ScottYates/VoiceLabels/case/stl/11a_front_panel_main.stl

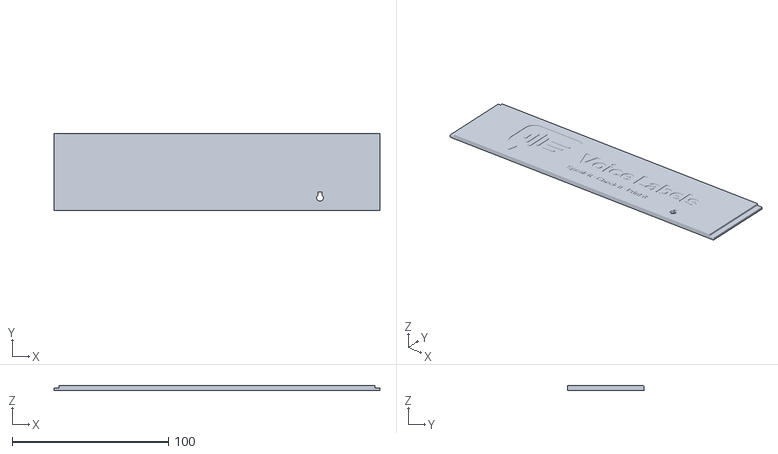
[picture p23: CAD file, 2026-11-02]
case/stl/11a_front_panel_main.stl
208.9 x 49.1 x 3.00
