ScottYates/VoiceLabels/case/stl/4_base.stl

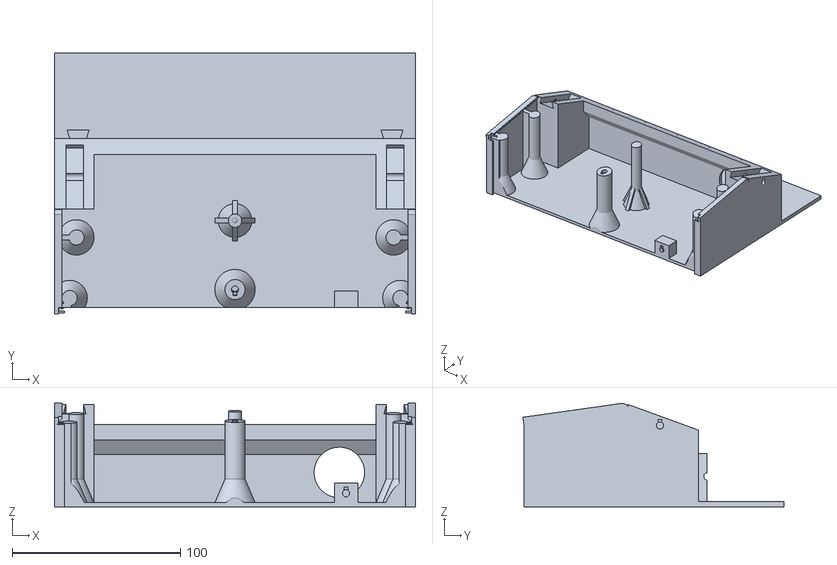
[picture p24: CAD file, 2026-11-02]
case/stl/4_base.stl
214.5 x 155.2 x 61.5
