ScottYates/VoiceLabels/logo3d/stl/logo_plaque.stl

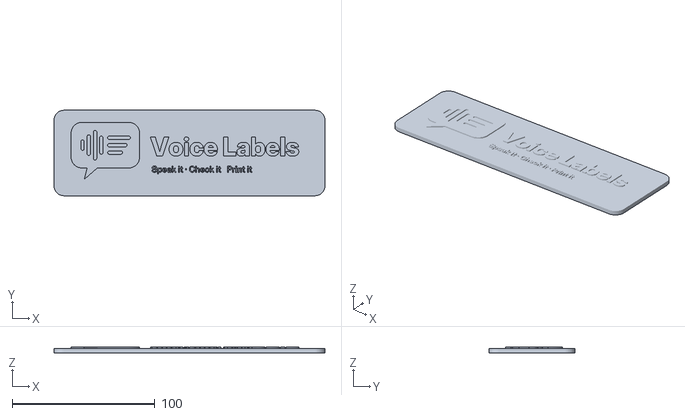
[picture p25: CAD file, 2026-10-25]
logo3d/stl/logo_plaque.stl
190.0 x 60.0 x 4.00
