ScottYates/VoiceLabels/logo3d/stl/logo_3_white.stl

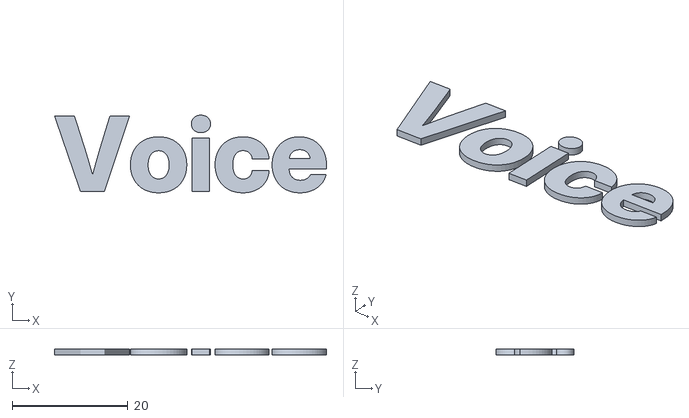
[picture p26: CAD file, 2026-10-25]
logo3d/stl/logo_3_white.stl
47.0 x 13.4 x 1.00
