ScottYates/VoiceLabels/case/stl/6_power_pod.stl

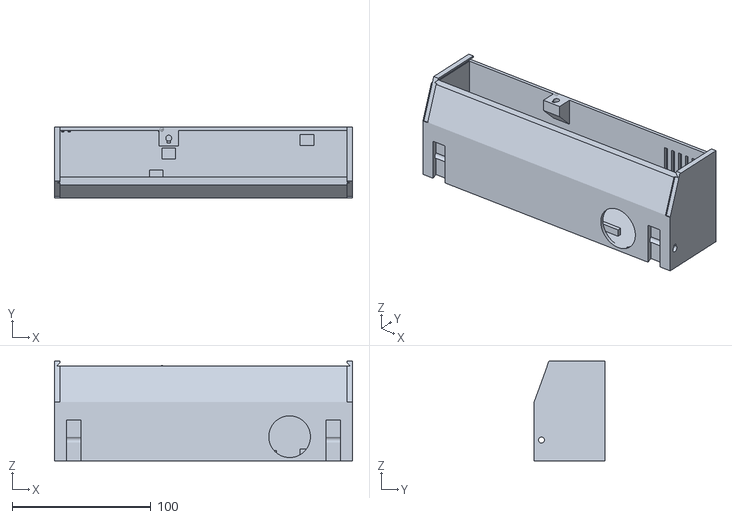
[picture p27: CAD file, 2026-11-02]
case/stl/6_power_pod.stl
214.5 x 50.8 x 71.8
