ScottYates/VoiceLabels/logo3d/stl/logo_4_gray.stl

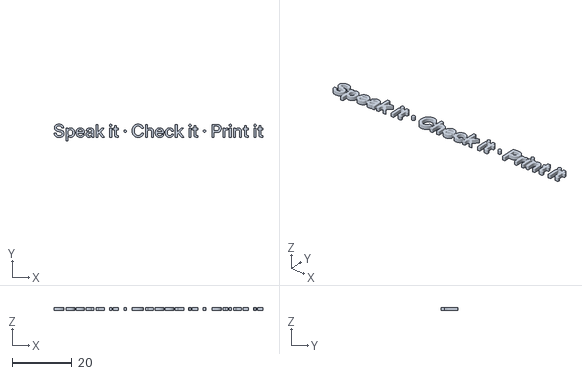
[picture p28: CAD file, 2026-10-25]
logo3d/stl/logo_4_gray.stl
70.0 x 5.66 x 1.00
