ScottYates/VoiceLabels/case/stl/1_housing.stl

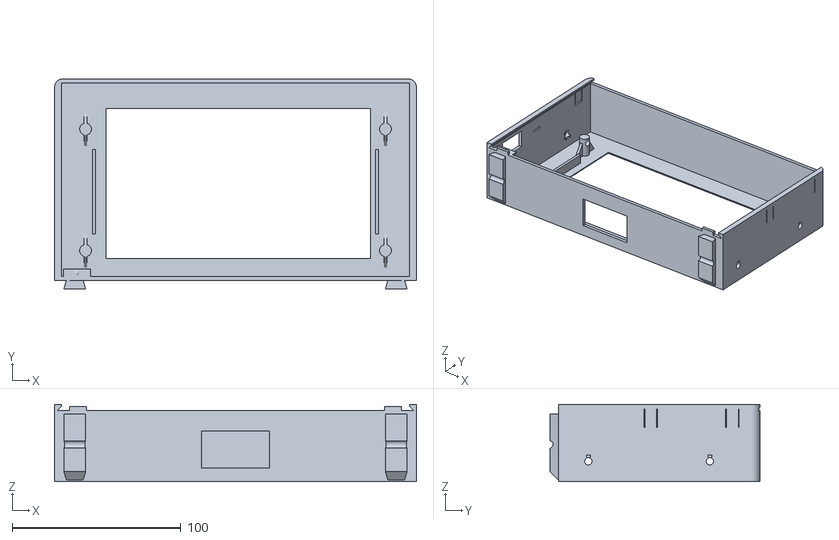
[picture p29: CAD file, 2026-11-02]
case/stl/1_housing.stl
214.5 x 124.6 x 45.7
