ScottYates/VoiceLabels/logo3d/stl/logo_1_base_dark.stl

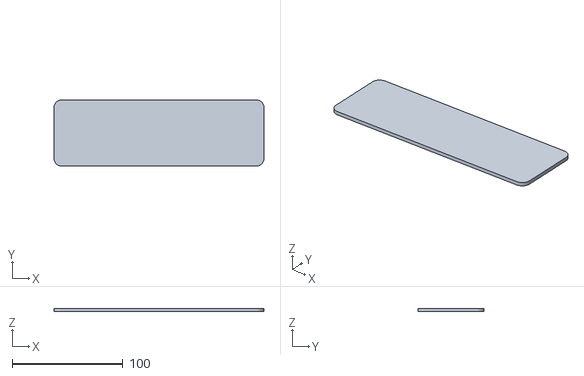
[picture p30: CAD file, 2026-10-25]
logo3d/stl/logo_1_base_dark.stl
190.0 x 60.0 x 3.00
