ScottYates/VoiceLabels/case/stl/9_socket_keeper.stl

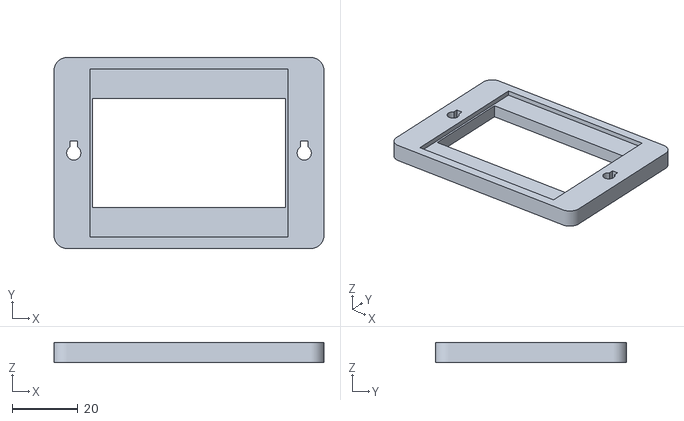
[picture p31: CAD file, 2026-11-02]
case/stl/9_socket_keeper.stl
82.0 x 58.0 x 6.20
