ScottYates/VoiceLabels/logo3d/stl/logo_2_yellow.stl

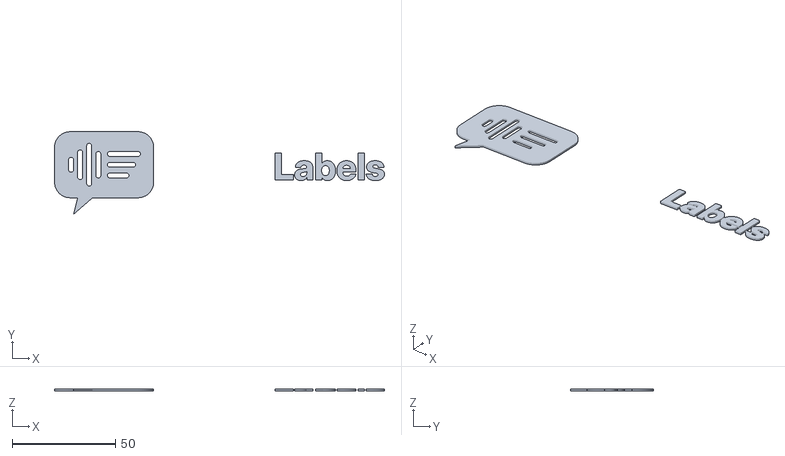
[picture p32: CAD file, 2026-10-25]
logo3d/stl/logo_2_yellow.stl
159.6 x 40.0 x 1.00
