ScottYates/VoiceLabels/case/stl/12_panel_pin_x3.stl

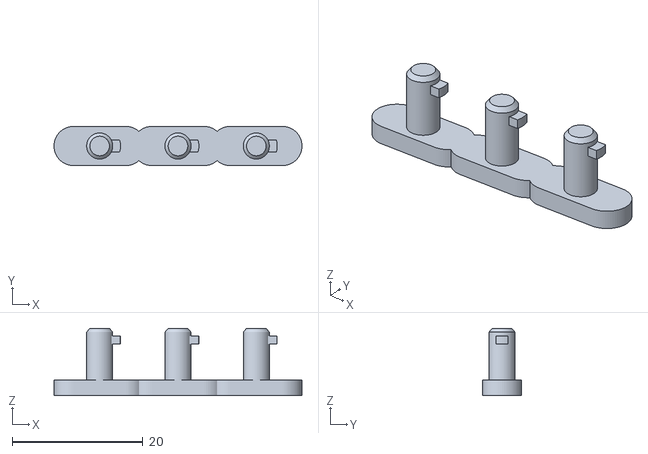
[picture p33: CAD file, 2026-11-02]
case/stl/12_panel_pin_x3.stl
38.0 x 6.00 x 10.3
