ScottYates/VoiceLabels/case/stl/11_front_panel.stl

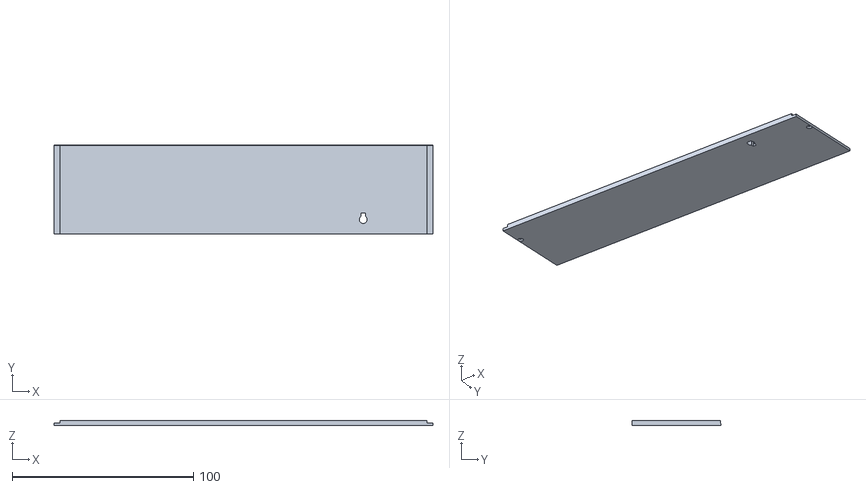
[picture p34: CAD file, 2026-11-02]
case/stl/11_front_panel.stl
208.9 x 49.1 x 3.00
