ScottYates/VoiceLabels/case/stl/5_deck.stl

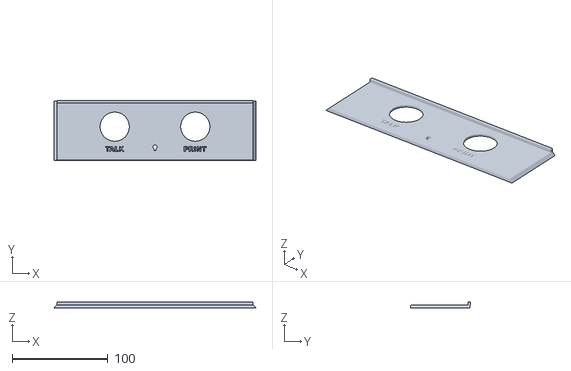
[picture p35: CAD file, 2026-11-02]
case/stl/5_deck.stl
210.7 x 62.7 x 6.00
