ScottYates/VoiceLabels/case/stl/7_pod_lid.stl

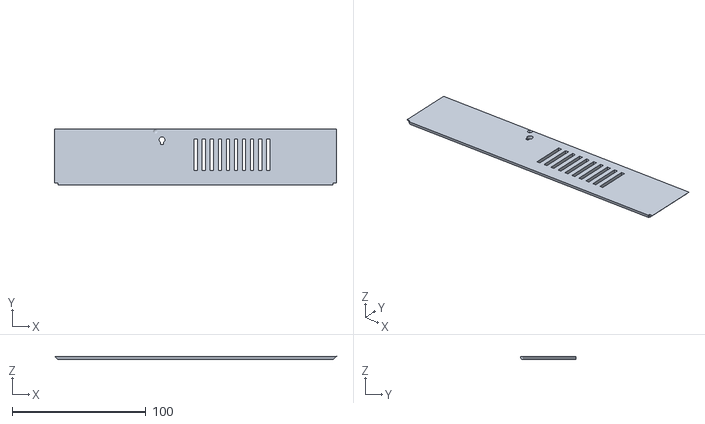
[picture p36: CAD file, 2026-11-02]
case/stl/7_pod_lid.stl
210.7 x 41.5 x 2.40
