ScottYates/VoiceLabels/case/stl/11c_front_logo_voice.stl

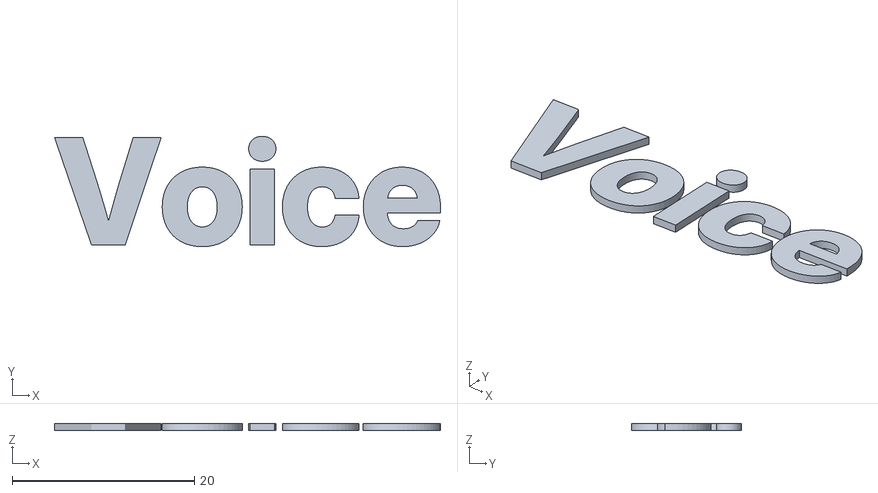
[picture p37: CAD file, 2026-10-29]
case/stl/11c_front_logo_voice.stl
42.3 x 12.1 x 0.8
