ScottYates/VoiceLabels/case/stl/11d_front_logo_tagline.stl

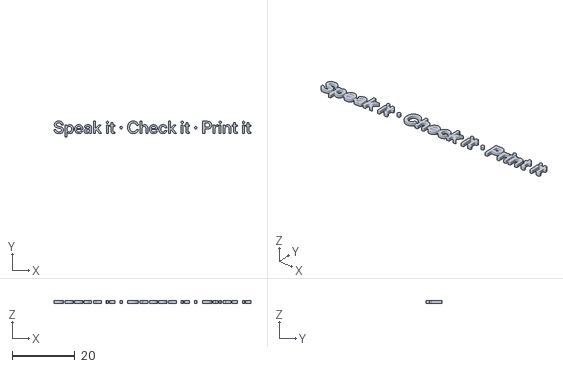
[picture p38: CAD file, 2026-10-29]
case/stl/11d_front_logo_tagline.stl
63.0 x 5.09 x 0.8
