ScottYates/VoiceLabels/case/stl/11b_front_logo_yellow.stl

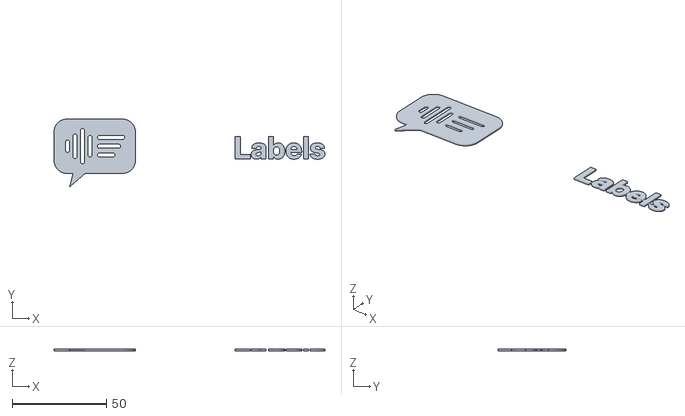
[picture p39: CAD file, 2026-10-29]
case/stl/11b_front_logo_yellow.stl
143.7 x 36.0 x 0.8
