ScottYates/VoiceLabels/case/stl/2_back_plate.stl

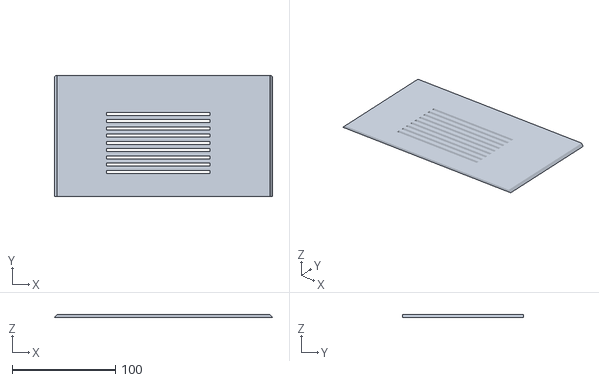
[picture p40: CAD file, 2026-10-23]
case/stl/2_back_plate.stl
210.7 x 117.3 x 2.50
