ScottYates/VoiceLabels/case/stl/10_socket_pin_x2.stl

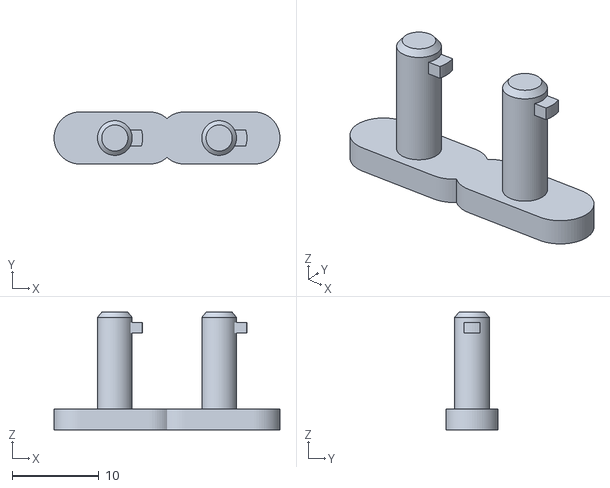
[picture p41: CAD file, 2026-10-23]
case/stl/10_socket_pin_x2.stl
26.0 x 6.00 x 13.5
