ScottYates/VoiceLabels/case/stl/3_screen_pin_x4.stl

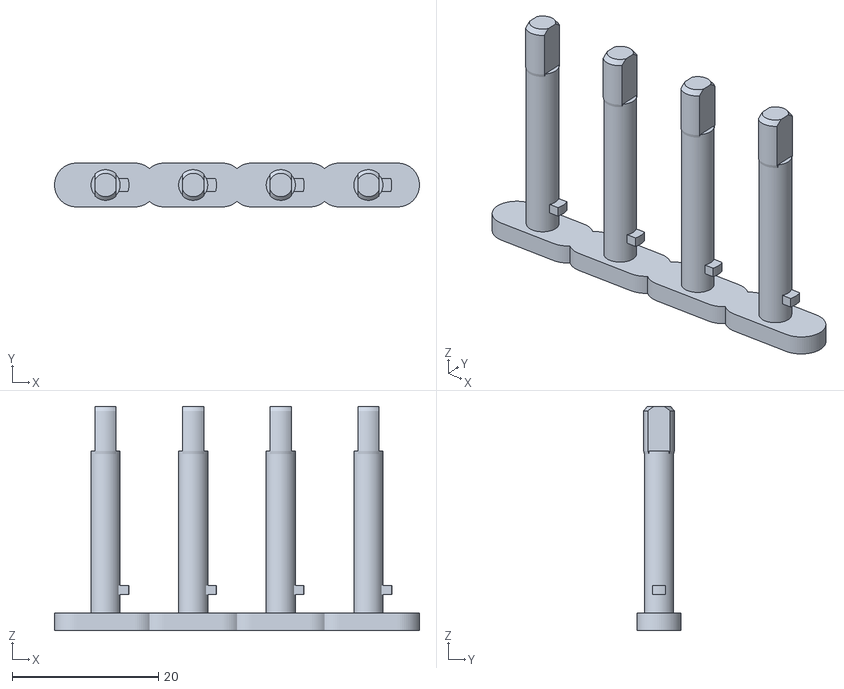
[picture p42: CAD file, 2026-10-23]
case/stl/3_screen_pin_x4.stl
50.0 x 6.00 x 30.7
