ScottYates/VoiceLabels/case/stl/8_lock_pin_x4.stl

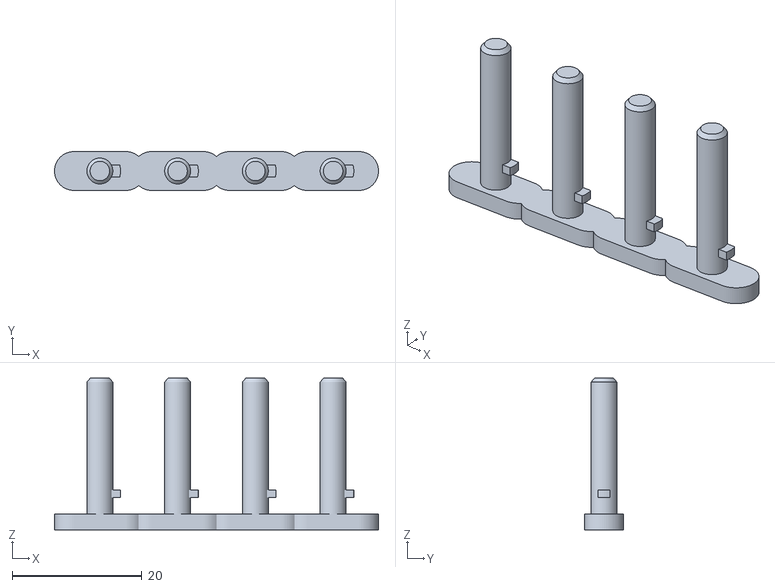
[picture p43: CAD file, 2026-10-23]
case/stl/8_lock_pin_x4.stl
50.0 x 6.00 x 23.4
