ScottYates/VoiceLabels/case/case.py

"""Voice label printer case: parametric model built with manifold3d.

Run:  python3 case.py      -> writes STL files and preview PNGs in ./out

Parts (each exported in its print orientation, no supports needed):
  1. housing      screen housing, printed face-down (best finish on the bezel)
  2. back_plate   flat back of the housing, with vents
  3. screen_pin x4  push-in pins that hold the screen board in the housing
  4. base         console with the button deck in front and the housing seat
  5. deck         flat button plate with TALK / PRINT labels
  6. power_pod    closed box behind the base for the USB power brick, with a
                  switched, fused IEC power socket in its back wall
  7. pod_lid      sliding lid for the power pod
 11. front_panel  the base's front wall: slides up from underneath once the deck is in;
                  the logo is inlaid flush in its front face (11a-11d: the same
                  panel split by colour for a multi-colour printer)
  8. lock_pin x4  quarter-turn pins that lock the housing and pod to the base
  9. socket_keeper  frame that clamps the power socket's front plate to the pod
 10. socket_pin x2  quarter-turn pins that hold the keeper on
 12. panel_pin x3   quarter-turn pins that lock the pod lid, the deck and the front panel in place

How the big parts join (no screws carry them):
  housing -> base   two dovetail rails under the housing slide down its seat
                    into dovetail slots in the base. The deck's back edge
                    then stops the housing sliding back out.
  power pod -> base two vertical dovetail rails on the back of the base; the
                    pod drops onto them and rests on the floor tongue. With
                    the housing on, its lean over the pod stops it lifting.

Coordinates for the housing ("print" frame): X across, Y up the face,
Z depth (0 = front face on the bed). Viewed from the FRONT, user-right = -X.
World frame for the assembly: X user-right, Y toward the back, Z up.
"""
import math
from pathlib import Path

import numpy as np
from manifold3d import CrossSection, FillRule, Manifold, OpType

# ------------------------------------------------------------------ settings
SEG = 64                       # circle smoothness
WALL = 2.4                     # side wall thickness
FRONT = 2.0                    # bezel (front plate) thickness
CLR = 0.4                      # clearance around the screen board

# Hosyond 7" DSI (from the maker's drawing)
PCB_W, PCB_H = 164.9, 102.0    # board / backlight outline
LENS_W, LENS_H = 164.28, 99.17 # glass; top edge flush with the board top
VA_L, VA_R = 3.2, 6.5          # visible area inset from glass edges, front view
VA_T, VA_B = 3.7, 8.5
STACK = 8.25                   # glass front to back of the board
WINDOW_MARGIN = 1.0            # window larger than the visible area by this
WINDOW_CHAMFER = 1.5

SIDE_GAP = 22.0                # room beside the board for USB plugs
TOP_GAP = 12.0                 # room above the board for the power cable to bend
INNER_DEPTH = 40.0             # front plate to back plate (Pi + plugs)
BACK_T = 2.5                   # back plate thickness
CORNER_R = 5.0

# Mic: it plugs straight into one of the Pi's USB ports through an opening in
# the side wall. The Pi's ports face the user's right, near the bottom of the
# case (the GPIO header is at the bottom). The opening lines up with the
# outer port of the stack nearest the GPIO header.
MIC_SIDE = "right"                # side the Pi's USB ports face, seen from the front
PI_STANDOFF = 8.0                 # gap between the screen board and the Pi board
PI_TOP_EDGE = 31.69               # Pi board top edge, mm below the screen board top
MIC_PORT_FROM_GPIO = 9.0          # USB stack centre, mm in from the Pi's GPIO edge
MIC_PORT_ABOVE_PI = 12.8          # outer port centre above the Pi board's top face
MIC_PLUG_W, MIC_PLUG_T = 19.0, 10.0   # mic plug body: width (up-down) x thickness
MIC_HOLE_CLR = 3.0                # extra room around the plug body

# Base and deck
RECLINE = 20.0                 # screen tilt back from vertical, degrees
DECK_ANGLE = 8.0               # button deck rises toward the screen
DECK_LEN = 62.0                # deck depth (horizontal)
DECK_T = 3.0                   # deck thickness (snap-in buttons like ~3 mm)
FRONT_H = 49.0                 # height of the deck underside at the front edge
REAR_SLOPE = 50.0              # rear wall angle from horizontal (>45 = no supports)
BUTTON_HOLE = 30.4             # 30 mm arcade buttons (print-tested holes run small)
BUTTON_PANEL_T = 2.0           # deck thinned to this around each button, for snap-in clips
BUTTON_RECESS_D = 38.0         # diameter of the thinned area (underside)
BUTTON_SPACING = 84.0
BASE_WALL = 2.4
# Front panel: the base's front wall is a separate panel that slides up into
# place from underneath once the deck (with the buttons hanging under it) is in.
# Its side edges are rebated and run in slots in two posts inside the front
# corners; a lip of each post covers the rebate, so the front stays flush.
FP_T = 3.0                     # panel thickness
FP_LIP = 1.2                   # post lip in front of the panel's rebated edge
FP_TONGUE = 3.5                # how far each edge runs into its post
FP_POST = 7.5                  # post width, from the side wall inwards
FP_CLR = 0.25                  # play in the slots
FP_DETENT_Z = 14.0             # click bump height (from the floor)
BUTTON_BODY_D, BUTTON_BODY_L = 31.0, 34.0   # arcade button body under the deck (stand-in for checks)

# Sliding panels (back plate, pod lid, deck): each panel's two long edges are
# bevelled at 45 degrees and slide under matching lips along the top of the
# side walls, like a pencil-box lid. A stop ends the travel and a small bump
# clicks into a dimple under the panel to hold it there. No screws.
SLIDE_NECK = 1.6               # rail width where it sits on the wall
SLIDE_LIP = 1.2                # lip thickness above the panel
SLIDE_CLR = 0.3                # play on each side
DETENT_R, DETENT_H = 1.4, 0.45 # click bump (the dimple is a little bigger)

# Dovetails. A rail is NECK wide where it meets its part and TIP wide at its
# end, HEIGHT tall; slots are DOVE_CLR bigger all round. Raise DOVE_CLR if
# your printer's joints come out too tight, lower it if they rattle.
DOVE_NECK, DOVE_TIP, DOVE_H = 10.0, 13.0, 5.0
DOVE_CLR = 0.25
HOUSING_RAIL_X = None          # set below: rail centres across the housing
HOUSING_RAIL_Z = (1.0, 40.0)   # rail start (at its root) / end along the housing depth
SEAT_RIB_W = 21.0              # solid rib inside each side wall carrying a slot
DECK_LIP_H = 3.0               # lip on the deck's back edge, in front of the bezel
DECK_LIP_D = 2.5
DECK_LIP_REACH = 0.4           # the lip reaches this far past the deck's back end, up to the bezel

# Lock pins: short printed pegs pushed in through the outside walls. Each one
# crosses a dovetail through a groove in the rail, so the part can't slide.
# They lock with a quarter turn, like a camera-lens bayonet: a lug on the shaft
# passes a slot in the wall, then turns behind it, riding up a small ramp on
# the wall's inside face (which pulls the head tight) and dropping into a
# notch at 90 degrees. A raised stop past the notch stops it turning too far.
PIN_D = 4.0                    # pin shaft
PIN_HOLE_D = 4.3               # holes the shaft passes through
PIN_LEN = 21.0                 # shaft length under the head
PIN_HEAD_L, PIN_HEAD_W, PIN_HEAD_T = 14.0, 6.0, 2.4   # wing head you turn with your fingers
PIN_WALL = 2.4                 # the walls the pins lock behind (all 2.4 mm)
LUG_R, LUG_W, LUG_T = 3.2, 1.8, 1.2   # lug: reach from the axis, width, thickness
LUG_GAP = 0.15                 # lug face to the wall's inside face, before the ramp
RAMP_H, NOTCH_H, STOP_H = 0.4, 0.15, 1.2   # ramp top, notch floor, stop: height off the wall
KEYWAY_W, KEYWAY_R = 2.3, 3.6  # slot in the wall the lug passes through
POCKET_R, POCKET_L = 3.8, 2.2  # room behind the wall for the lug to turn
PIN_HOUSING_S = 22.0           # housing pins: distance along the seat from the bezel
PIN_POD_Z = 18.0               # pod pins: height (world Z)

# Cable hole between the power pod and the space under the buttons.
PASS_HOLE_D = 30.0             # ~1.2 inch: tops out below where the pod's front starts to slope
PASS_HOLE_X = 62.0             # centre, world X (user-right is +)

# Derived housing sizes
INNER_W = PCB_W + 2 * CLR + 2 * SIDE_GAP
INNER_H = PCB_H + 2 * CLR + TOP_GAP
W = INNER_W + 2 * WALL
H = INNER_H + 2 * WALL
DEPTH = FRONT + INNER_DEPTH            # shell depth (without back plate)
PCB_X0 = -PCB_W / 2                    # board edges (print X)
PCB_Y0 = WALL + CLR                    # board bottom edge (print Y)
PCB_BACK_Z = FRONT + STACK             # back face of the board
RIB = 8.0                              # corner rib size
RIB_X = INNER_W / 2 - RIB / 2          # rib centres
CLAMP_X = PCB_W / 2 + CLR + 6.0       # posts beside the board that guide the screen pins
CLAMP_YS = [PCB_Y0 + 15.0, PCB_Y0 + 87.0]
SCREEN_PIN_OVER = 3.5                  # how far each screen pin reaches over the board's back
# The part of each screen pin over the board is a cam: round (CAM_D) with two
# flats. It slides in with a flat towards the board (CAM_FLAT from the axis,
# clear of it), and the quarter turn that locks the pin brings the round side
# down onto the board, pressing it CAM_SQUEEZE into the bezel.
CAM_D = 4.2                            # still passes the 4.3 mm hole
CAM_FLAT = 1.45                        # axis to each flat
CAM_SQUEEZE = 0.35                     # how far the round side reaches past the board's back
HOUSING_RAIL_X = W / 2 - 12.0

# ------------------------------------------------------------------ helpers
def box(x0, x1, y0, y1, z0, z1):
    return Manifold.cube([x1 - x0, y1 - y0, z1 - z0]).translate([x0, y0, z0])

def cyl(r, h, x=0, y=0, z=0):
    return Manifold.cylinder(h, r, circular_segments=SEG).translate([x, y, z])

def housing_outline():
    """The housing's outline (print X across, Y up from its bottom edge):
    rounded top corners, square bottom corners where it sits in the base."""
    return (rrect(W, H, CORNER_R).translate([0, H / 2])
            + CrossSection.square([W, H / 2]).translate([-W / 2, 0]))


def rrect(w, h, r):
    """Rounded rectangle centred at the origin (X width, Y height)."""
    core = CrossSection.square([w - 2 * r, h - 2 * r], center=True)
    return core.offset(r, join_type=__import__("manifold3d").JoinType.Round, circular_segments=SEG)

def union(parts):
    return Manifold.batch_boolean(parts, OpType.Add)


def _ccw(pts):
    area = sum(a[0] * b[1] - b[0] * a[1] for a, b in zip(pts, pts[1:] + pts[:1]))
    return pts if area > 0 else pts[::-1]


def _along_y(cs, y0, y1):
    """Extrude a CrossSection drawn in (x, z) along +Y from y0 to y1."""
    return cs.extrude(y1 - y0).rotate([90, 0, 0]).translate([0, y1, 0])


def slide_rails(t, y0, y1, z0=0.0):
    """Two rails along the side edges (x = +-W/2) of a panel t thick lying on
    the plane z = z0, running from y0 to y1. Each rail's inside face is a 45-degree
    undercut that the panel's bevelled edge slides under."""
    rails = []
    for sx in (-1, 1):
        x0, xn = W / 2, W / 2 - SLIDE_NECK
        pts = [(x0, 0), (xn, 0), (xn - t, t), (xn - t, t + SLIDE_LIP), (x0, t + SLIDE_LIP)]
        pts = _ccw([(sx * x, z) for x, z in pts])
        rails.append(_along_y(CrossSection([pts]), y0, y1))
    return union(rails).translate([0, 0, z0])


def slide_panel(t, y0, y1):
    """A panel t thick (bottom at z = 0) whose long edges are bevelled to slide
    under slide_rails, running from y0 to y1."""
    xb = W / 2 - SLIDE_NECK - SLIDE_CLR
    pts = _ccw([(-xb, 0), (xb, 0), (xb - t, t), (-(xb - t), t)])
    return _along_y(CrossSection([pts]), y0, y1)


def detent_bump(x, y, z):
    """Small dome on a surface at height z (the click bump)."""
    return Manifold.cylinder(DETENT_H, DETENT_R, 0.35, SEG).translate([x, y, z - 0.01])


def detent_dimple(x, y):
    """Matching dimple in a panel's underside (panel bottom at z = 0)."""
    return Manifold.cylinder(DETENT_H + 0.25, DETENT_R + 0.3, 0.6, SEG).translate([x, y, -0.01])

def dove_section(clr=0.0, extra=0.0):
    """Dovetail cross-section (u across, v out from the part), narrow at v=0.
    clr grows it for the slot; extra lengthens it back into the part."""
    n, t, h = DOVE_NECK / 2 + clr, DOVE_TIP / 2 + clr, DOVE_H + clr
    slope = (t - n) / h
    return CrossSection([[(-n + slope * extra, -extra), (n - slope * extra, -extra),
                          (t, h), (-t, h)]])

def text_cross_section(s, size):
    """Text outline as a CrossSection, centred, using DejaVu Sans Bold."""
    from matplotlib.font_manager import FontProperties
    from matplotlib.textpath import TextPath
    tp = TextPath((0, 0), s, size=size, prop=FontProperties(family="DejaVu Sans", weight="bold"))
    polys = [p for p in tp.to_polygons() if len(p) >= 3]
    cs = CrossSection(polys, FillRule.EvenOdd)
    (x0, y0), (x1, y1) = cs.bounds()[:2], cs.bounds()[2:]
    return cs.translate([-(x0 + x1) / 2, -(y0 + y1) / 2])

# ------------------------------------------------------------------ housing
def mic_port_yz():
    """Height (print Y) and depth (print Z) of the mic's USB port centre."""
    pi_top = PCB_Y0 + PCB_H - PI_TOP_EDGE        # Pi board edge toward the case top
    pi_gpio_edge = pi_top - 56.0                  # GPIO edge, toward the case bottom
    y = pi_gpio_edge + MIC_PORT_FROM_GPIO
    z = PCB_BACK_Z + PI_STANDOFF + 1.6 + MIC_PORT_ABOVE_PI
    return y, z


def housing():
    outer = housing_outline().extrude(DEPTH)
    inner = box(-INNER_W / 2, INNER_W / 2, WALL, WALL + INNER_H, FRONT, DEPTH + 1)
    shell = outer - inner

    # Window over the visible area. Front view right = -X, so swap L/R.
    lens_x0, lens_x1 = -LENS_W / 2, LENS_W / 2
    lens_y1 = PCB_Y0 + PCB_H
    lens_y0 = lens_y1 - LENS_H
    va_x0, va_x1 = lens_x0 + VA_R, lens_x1 - VA_L     # print X (mirrored)
    va_y0, va_y1 = lens_y0 + VA_B, lens_y1 - VA_T
    m, c = WINDOW_MARGIN, WINDOW_CHAMFER
    win = box(va_x0 - m, va_x1 + m, va_y0 - m, va_y1 + m, -1, FRONT + 1)
    bevel = Manifold.batch_hull([
        box(va_x0 - m - c, va_x1 + m + c, va_y0 - m - c, va_y1 + m + c, -1, 0),
        box(va_x0 - m, va_x1 + m, va_y0 - m, va_y1 + m, c, c + 0.01),
    ])
    shell = shell - win - bevel

    # Side rails that locate the board left/right.
    rails = []
    for sx in (-1, 1):
        x_in = sx * (PCB_W / 2 + CLR)
        rails.append(box(min(x_in, x_in + sx * 2), max(x_in, x_in + sx * 2),
                         PCB_Y0 + 25, PCB_Y0 + 75, FRONT, FRONT + STACK - 1.5))
    # Back plate: slide rails along the side walls' back rims (trimmed to the
    # rounded outline), stop blocks at the bottom corners, and a small pad inside
    # the bottom wall carrying the click bump.
    ribs = []
    outline = housing_outline().extrude(20).translate([0, 0, DEPTH - 1])
    ribs.append(slide_rails(BACK_T, 0, H, DEPTH) ^ outline)
    for sx in (-1, 1):
        ribs.append(box(sx * (W / 2 - 14) - 5, sx * (W / 2 - 14) + 5, 0, BACK_STOP_Y,
                        DEPTH - 0.01, DEPTH + BACK_T) ^ outline)
    ribs.append(_pad_yz(BACK_DETENT_X))
    ribs.append(detent_bump(BACK_DETENT_X, BACK_DETENT_Y, DEPTH))
    # Posts beside the board that carry the screen pins.
    post_top = screen_pin_z() + PIN_D / 2 + 2.0
    bosses = [cyl(3.5, post_top - FRONT, sx * CLAMP_X, y, FRONT) for sx in (-1, 1) for y in CLAMP_YS]
    # ... each braced by two triangular ribs along Y (clear of the board and the pin's path)
    for sx in (-1, 1):
        for y in CLAMP_YS:
            for sy in (-1, 1):
                tri = [(y + sy * 3.0, FRONT - 0.01), (y + sy * 10.0, FRONT - 0.01), (y + sy * 3.0, post_top - 3.0)]
                bosses.append(x_extrude(tri if sy > 0 else tri[::-1], sx * CLAMP_X - 1.0, sx * CLAMP_X + 1.0))

    # Dovetail rails under the bottom wall, running front to back. In the print
    # frame they hang off the Y=0 face and run along Z (straight up on the bed).
    # Their front ends are cut at 45 degrees (starting at z0 where they meet the
    # wall) so they build up from the bed without supports.
    z0, z1 = HOUSING_RAIL_Z
    end_cut = (box(-200, 200, -100, 100, -200, 0).rotate([-45, 0, 0]).translate([0, 0, z0]))
    for sx in (-1, 1):
        rail = (dove_section(extra=0.5).extrude(z1)              # u -> X, v -> -Y
                .mirror([0, 1, 0]).translate([sx * HOUSING_RAIL_X, 0, 0]))
        # groove across the tip for the lock pin (pin axis at the slot bottom)
        groove = cyl(PIN_HOLE_D / 2, W + 4, 0, 0, 0).rotate([0, 90, 0]).translate(
            [-W / 2 - 2, -(DOVE_H + DOVE_CLR), PIN_HOUSING_S])
        rails.append(rail - end_cut - groove)
    shell = union([shell] + rails + ribs + bosses)

    # Mic opening: a tall rectangle lined up with the Pi's USB port.
    my, mz = mic_port_yz()
    hy, hz = (MIC_PLUG_W + MIC_HOLE_CLR) / 2, (MIC_PLUG_T + MIC_HOLE_CLR) / 2
    mic_hole = box(W / 2 - WALL - 1, W / 2 + 1, my - hy, my + hy, mz - hz, mz + hz)
    if MIC_SIDE == "right":                     # user-right is print -X
        mic_hole = mic_hole.mirror([1, 0, 0])

    holes = [mic_hole]
    bores = []
    # Screen pins: in through the side wall, through the post,
    # reaching over the back of the board's edge.
    for sx in (-1, 1):
        for y in CLAMP_YS:
            bores.append(pin_bore(sx, y, screen_pin_z(), sx * (CLAMP_X - 4.5)))
    # Wire pass-through in the bottom wall (button wires to the GPIO header).
    holes.append(box(-20, 20, -1, WALL + 1, 8, 30))
    # Breakaway cable tabs: a notch at the back rim of each side wall, filled
    # by a tab held on by a thin web. Snap out the ones you need; the back
    # plate closes over the cable.
    for y in KNOCKOUT_YS:
        for sx in (-1, 1):
            x_out, x_in = sx * W / 2, sx * (W / 2 - WALL)
            xa, xb = min(x_out, x_in) - 0.01, max(x_out, x_in) + 0.01
            y0, y1 = y - KO_W / 2, y + KO_W / 2
            z0 = DEPTH - KO_DEPTH
            # slits down both long sides of the tab
            holes.append(box(xa - 1, xb + 1, y0 - KO_SLIT, y0, z0, DEPTH + 1))
            holes.append(box(xa - 1, xb + 1, y1, y1 + KO_SLIT, z0, DEPTH + 1))
            # thin the hinge line at the bottom of the tab from the inside
            hinge_in = (xa, xb - KO_WEB) if sx > 0 else (xa + KO_WEB, xb)
            holes.append(box(hinge_in[0], hinge_in[1], y0, y1, z0 - 0.01, z0 + 1.2))
    return add_pin_bores(shell - union(holes), bores)


KO_W = 7.0                      # breakaway tab width (cable up to ~6 mm)
KO_DEPTH = 10.0                 # how far the notch reaches in from the back rim
KO_SLIT = 0.5
KO_WEB = 0.8                    # thickness left at the hinge (2 perimeters)
KNOCKOUT_YS = [PCB_Y0 + 52.0,                         # low: printer cable
               WALL + INNER_H - RIB - 6.0]            # high: power cable

BACK_STOP_Y = 2.0               # back plate stops on blocks this tall at the bottom corners
BACK_DETENT_X = -94.0           # click bump: on a pad inside the bottom wall, beside the
                                # screen board (the board passes this rim on its way in)
BACK_PAD_W = 16.0
BACK_DETENT_Y = WALL + 2.2


def _pad_yz(x_center):
    """Wedge inside the housing's bottom wall at the back rim (45-degree underside)."""
    prof = [(WALL - 0.01, DEPTH - 5.0), (WALL + 4.6, DEPTH - 0.01), (WALL - 0.01, DEPTH - 0.01)]
    pts = prof
    area = sum(a[0] * b[1] - b[0] * a[1] for a, b in zip(pts, pts[1:] + pts[:1]))
    if area < 0:
        pts = pts[::-1]
    # profile is in (y, z); extrude across x
    return (CrossSection([pts]).extrude(BACK_PAD_W).rotate([90, 0, 90])
            .translate([x_center - BACK_PAD_W / 2, 0, 0]))


def back_plate():
    """Slides down from the top of the housing under the rails on the side
    walls, stops on two blocks at the bottom, and clicks onto a bump."""
    outline = housing_outline().extrude(BACK_T + 2).translate([0, 0, -1])
    plate = slide_panel(BACK_T, BACK_STOP_Y + SLIDE_CLR, H) ^ outline
    cut = [detent_dimple(BACK_DETENT_X, BACK_DETENT_Y)]
    # Vent slots over the Pi.
    for i in range(9):
        y = PCB_Y0 + 22 + i * 7
        cut.append(box(-55, 45, y, y + 3, -1, BACK_T + 1))
    return plate - union(cut)

def screen_pin_len():
    """From the outside of the side wall to SCREEN_PIN_OVER past the board edge."""
    return W / 2 - (PCB_W / 2 - SCREEN_PIN_OVER)


def screen_pin_z():
    """Screen pin axis depth: the cam's round side reaches CAM_SQUEEZE past the
    back of the board, so a locked pin presses the board into the bezel."""
    return PCB_BACK_Z + CAM_D / 2 - CAM_SQUEEZE


def screen_pin_cam_from():
    """Where the cam starts along a screen pin (local Z, head at 0): just past
    the inside face of the post, before the board's edge."""
    return PIN_HEAD_T + W / 2 - (CLAMP_X - 3.5 - 0.3)


# ------------------------------------------------------------------ base (world frame)
T = math.tan
DA, RA = math.radians(DECK_ANGLE), math.radians(RECLINE)
DECK_TOP_BACK = FRONT_H + DECK_LEN * T(DA) + DECK_T / math.cos(DA)
E = np.array([DECK_LEN, DECK_TOP_BACK])            # housing front-bottom edge (y, z)
HOUSING_DEPTH = DEPTH + BACK_T
DOWN_BACK = np.array([math.cos(RA), -math.sin(RA)])  # housing depth direction (y, z)
UP_FACE = np.array([math.sin(RA), math.cos(RA)])     # housing height direction (y, z)
B = E + HOUSING_DEPTH * DOWN_BACK                    # housing back-bottom edge
BASE_LEN = B[0] + B[1] / T(math.radians(REAR_SLOPE))   # without the power pod

# ------------------------------------------------------------------ power pod
# The USB power brick lives in a closed box behind the base, under the
# screen's lean. Mains comes in through a switched, fused IEC C14 socket
# (e.g. Amazon B0C2GHJGW2) in its back wall; inside, the cut-off socket end
# of a short 2-prong extension cord feeds the brick.
POWER_POD = True
PSU_L, PSU_H, PSU_T = 63.5, 63.5, 31.75   # brick: prong axis (X), height (Z), thickness (Y)
PSU_CLR = 0.8                      # room around the brick
POD_WALL = 2.4
TONGUE_T = 3.0                     # base floor extension the pod stands on
POD_RAIL_X = W / 2 - 14.0          # vertical dovetail rails on the base's back wall
POD_GAP_V = 0.0                    # pod front to the base's rear wall: touching (the dovetails locate it; it drops on vertically)
POD_GAP_S = 3.0                    # pod's sloped front to the screen's back plate (at the side rails)
POD_FACE_GAP = 0.0                 # ... where the face is built out to meet it: touching
POD_LID_GAP = 0.0                  # pod lid's front edge touches the housing's back (the housing is its stop)
INLET_CUT = (47.6, 27.8)           # IEC socket panel cutout (W x H)
INLET_SCREW_SPACING = 40.0         # its screw ears, above and below the cutout (unused: no screws)
# The socket's flat mounting plate (width, height from ear tip to ear tip,
# thickness) and the raised face on it (width, height) around the switch,
# fuse and plug. From a photo of the real part, scaled by the pin spacing:
# the plate just clears the two pin holes. Measure yours and adjust.
INLET_PLATE = (59.1, 50.0, 2.0)
INLET_FACE = (56.6, 31.0)      # 1/16" wider than the photo estimate, after a test fit
KEEPER_FACE = 4.5                  # keeper frame: thickness in front of the plate (6.2 mm in all, as the pins expect)
KEEPER_SQUEEZE = 0.3               # how much the keeper presses the plate into the wall
KEEPER_WINDOW_CLR = 1.0            # room around the socket's raised face in the keeper's window, each side
KEEPER_PIN_DX = 35.0               # keeper pins: this far either side of the socket centre (closed holes, solid all round)
INLET_DEPTH = 38.0                 # body + terminals behind the panel
INLET_X = -64.0                    # socket centre across the pod (world X, user-right +): keeps the outer keeper pin clear of the side wall
BRICK_X0 = -5.0                    # brick's prong end (world X); prongs face -X
LID_T = 2.4

def pod_geometry():
    z0 = TONGUE_T
    yf = B[0] + POD_GAP_V                                  # vertical part of the front
    c = POD_GAP_S / math.cos(RA)
    slant = lambda z: B[0] + c + (z - B[1]) * T(RA)       # front, parallel to the back plate
    z_v = B[1] + (yf - B[0] - c) / T(RA)                  # where the slant leaves the vertical
    front = lambda z: yf if z <= z_v else slant(z)        # outer front at height z
    brick_z1 = z0 + POD_WALL + PSU_H + PSU_CLR
    z_top = brick_z1 + 1.5                                 # top of the walls (lid sits on it)
    front_in_top = front(z_top) + POD_WALL / math.cos(RA)
    brick_y0 = front_in_top + PSU_CLR
    brick_y1 = brick_y0 + PSU_T
    yb = brick_y1 + PSU_CLR + POD_WALL                     # outer back
    return dict(z0=z0, yf=yf, z_v=z_v, front=front, z_top=z_top, yb=yb,
                brick=(BRICK_X0, BRICK_X0 + PSU_L, brick_y0, brick_y1,
                       z0 + POD_WALL, z0 + POD_WALL + PSU_H))

POD = pod_geometry()
TOTAL_LEN = POD["yb"] if POWER_POD else BASE_LEN

def profile_xs(points, width=None):
    """Extrude a (y, z) side profile across the base width (world X), centred."""
    width = W if width is None else width
    pts = list(points)
    area = sum(a[0] * b[1] - b[0] * a[1] for a, b in zip(pts, pts[1:] + pts[:1]))
    if area < 0:
        pts = pts[::-1]                                  # manifold wants CCW
    cs = CrossSection([pts])
    # CrossSection is in (u, v); extrude along +Z then rotate so u->Y, v->Z, Z->X.
    return cs.extrude(width).rotate([90, 0, 90]).translate([-width / 2, 0, 0])

def x_extrude(points, x0, x1):
    """Extrude a (y, z) side profile over world X from x0 to x1."""
    pts = list(points)
    area = sum(a[0] * b[1] - b[0] * a[1] for a, b in zip(pts, pts[1:] + pts[:1]))
    if area < 0:
        pts = pts[::-1]
    return CrossSection([pts]).extrude(x1 - x0).rotate([90, 0, 90]).translate([x0, 0, 0])


def housing_slots():
    """The dovetail slots the housing's rails slide into (world frame).
    Open at the front (deck end), closed at the back."""
    z0, z1 = HOUSING_RAIL_Z
    slots = []
    for sx in (-1, 1):
        slot = (dove_section(clr=DOVE_CLR, extra=1.0).extrude(z1 + 0.5 - (z0 - 20))
                .mirror([0, 1, 0]).translate([sx * HOUSING_RAIL_X, 0, z0 - 20]))
        slots.append(housing_world(slot))
    return union(slots)


def pod_rail_z():
    """Bottom and top of the base's vertical pod rails."""
    return TONGUE_T, POD["z_v"] - 5.0


def pass_hole(y0, y1):
    """The 1.5" cable hole, as a cylinder along Y between y0 and y1."""
    zc = TONGUE_T + POD_WALL + PASS_HOLE_D / 2          # bottom level with the pod floor
    return cyl(PASS_HOLE_D / 2, y1 - y0, 0, 0, 0).rotate([-90, 0, 0]).translate(
        [PASS_HOLE_X, y0, zc])


def pin_bore(sx, y, z, x_end):
    """Hole for a quarter-turn lock pin along X at (y, z), entering through the
    side wall at x = sx * W/2. Returns (cuts, adds): the hole, slot and turning
    pocket to remove, and the ramps, notches and stops on the wall's inside face
    to add back. The slot points up (+Z in the part's own frame, which is up on
    the print bed too); the pin locks a quarter turn either way."""
    xo, xi = sx * W / 2, sx * (W / 2 - PIN_WALL)
    def along(x0, x1, r):
        a, b = sorted((x0, x1))
        return cyl(r, b - a, 0, 0, 0).rotate([0, 90, 0]).translate([a, y, z])
    cuts = [along(xo + sx * 1, x_end, PIN_HOLE_D / 2)]
    a, b = sorted((xo + sx * 1, xi - sx * 0.01))
    cuts.append(box(a, b, y - KEYWAY_W / 2, y + KEYWAY_W / 2, z, z + KEYWAY_R))
    cuts.append(along(xi + sx * 0.01, xi - sx * POCKET_L, POCKET_R))
    # Ramp, notch and stop: thin sector slabs on the inside face, each side of the slot.
    def height(t):
        if 24 <= t < 66:
            return RAMP_H * (t - 24) / 42 + 0.02
        if 66 <= t < 112:
            return NOTCH_H
        if 112 <= t < 140:
            return STOP_H
        return 0.0
    r0, r1 = PIN_HOLE_D / 2 + 0.05, LUG_R + 0.35
    step = 3
    adds = []
    for side in (-1, 1):
        for t in range(24, 140, step):
            h = height(t + step / 2)
            a0_, a1_ = math.radians(t), math.radians(t + step + 0.5)
            quad = [(r0, a0_), (r1, a0_), (r1, a1_), (r0, a1_)]
            yz = [(y + r * math.sin(a) * side, z + r * math.cos(a)) for r, a in quad]
            x0, x1 = sorted((xi + sx * 0.01, xi - sx * h))
            adds.append(x_extrude(yz, x0, x1))
    return union(cuts), union(adds)


def pin_hole(sx, yz, rail_x, outer_wall=None):
    """Lock pin hole ending 2.5 mm past the far side of the rail's slot."""
    y, z = yz
    return pin_bore(sx, y, z, sx * (rail_x - DOVE_TIP / 2 - DOVE_CLR - 2.5))


def add_pin_bores(body, bores):
    """Cut the holes and pockets, then add the ramps back."""
    cuts = union([c for c, _ in bores])
    adds = union([a for _, a in bores])
    return (body - cuts) + adds


def pin_place(m, sx, y, z, locked=True):
    """Put a pin (modelled head-down along +Z, lug along +X) into its hole on
    side sx: head against the wall, lug sideways when locked, up when not."""
    lug = [0, 1, 0] if locked else [0, 0, 1]
    ax = [-sx, 0, 0]
    third = np.cross(ax, lug).tolist()
    # columns: images of local X (lug), local Y, local Z (axis)
    mat = [[lug[0], third[0], ax[0], sx * (W / 2 + PIN_HEAD_T)],
           [lug[1], third[1], ax[1], y],
           [lug[2], third[2], ax[2], z]]
    return m.transform(mat)


def housing_pin_yz():
    """Where the housing lock pins cross: at the bottom of the slot, so half the
    pin sits in a groove across the rail's tip."""
    p = E + PIN_HOUSING_S * DOWN_BACK - (DOVE_H + DOVE_CLR) * UP_FACE
    return float(p[0]), float(p[1])


def pod_pin_yz():
    """Pod lock pins cross at the tip face of the base's rails."""
    return B[0] + DOVE_H + DOVE_CLR, PIN_POD_Z


POST_FLARE = 6.0               # tall posts: extra radius at the floor, tapering out over POST_FLARE_H
POST_FLARE_H = 14.0
POST_GUSSET_H = 24.0           # free-standing posts: four ribs this tall, reaching POST_GUSSET_R from the axis
POST_GUSSET_R = 12.0
POST_RIB_T = 3.0               # ribs from posts to the walls, and gussets


def post_support(x, y, r, wall_x=None):
    """Bracing for a tall post standing on the base's floor: a flared foot and,
    beside a side wall, a full-height web to the wall (trimmed to the deck
    underside with everything else); otherwise four triangular gussets."""
    z0 = BASE_WALL - 0.01
    adds = [Manifold.cylinder(POST_FLARE_H, r + POST_FLARE, r, SEG).translate([x, y, z0])]
    if wall_x is not None:
        a, b = sorted((x, wall_x))
        adds.append(box(a, b, y - POST_RIB_T / 2, y + POST_RIB_T / 2, z0, 200))
    else:
        tri = [(0, 0), (POST_GUSSET_R, 0), (0, POST_GUSSET_H)]
        for ang in (0, 90, 180, 270):
            g = (x_extrude([(u, v) for u, v in tri], -POST_RIB_T / 2, POST_RIB_T / 2)   # (y, z) profile, thin in X
                 .rotate([0, 0, ang]).translate([x, y, z0]))
            adds.append(g)
    return union(adds)


def base():
    if POWER_POD:   # straight rear wall under the housing; the pod sits behind it
        prof = [(0, 0), (0, FRONT_H), (DECK_LEN, FRONT_H + DECK_LEN * T(DA)),
                (DECK_LEN, E[1]), (B[0], B[1]), (B[0], 0)]
    else:
        prof = [(0, 0), (0, FRONT_H), (DECK_LEN, FRONT_H + DECK_LEN * T(DA)),
                (DECK_LEN, E[1]), (B[0], B[1]), (BASE_LEN, 0)]
    solid = profile_xs(prof)
    # Inner cavity: open top, keeps floor, front wall and rear wall.
    rs = math.radians(90.0 if POWER_POD else REAR_SLOPE)
    rear_outer = B[0] if POWER_POD else BASE_LEN
    y_rear_inner = rear_outer - BASE_WALL / math.sin(rs)
    top = 400
    cav = [(BASE_WALL, BASE_WALL), (y_rear_inner - BASE_WALL / T(rs), BASE_WALL),
           (y_rear_inner - top / T(rs), top), (BASE_WALL, top)]
    cav_cs = CrossSection([cav])
    cavity = cav_cs.extrude(W - 2 * BASE_WALL).rotate([90, 0, 90]).translate(
        [-W / 2 + BASE_WALL, 0, 0])
    body = solid - cavity

    adds, cuts, late_adds = [], [], []
    # Seat ribs: solid from the floor up to the housing seat, inside each side
    # wall, each carrying one of the housing's dovetail slots.
    seat = [(E[0], 0), (E[0], E[1]), (B[0], B[1]), (B[0], 0)]
    xin = W / 2 - BASE_WALL + 0.01
    for sx in (-1, 1):
        x0, x1 = sorted((sx * xin, sx * (xin - SEAT_RIB_W)))
        adds.append(x_extrude(seat, x0, x1))
    # Rear wall thickened along its top (45-degree underside, no supports), so
    # the cable hole has a solid band above it and the housing a wider seat.
    if POWER_POD:
        yi = B[0] - BASE_WALL
        led = 7.0
        ledge = [(yi + 0.01, B[1] - led - 7.5), (yi - led, B[1] - 6),
                 (yi - led, B[1] + (B[0] - (yi - led)) * T(RA) - 0.01),
                 (yi + 0.01, B[1] + BASE_WALL * T(RA) - 0.01)]
        adds.append(x_extrude(ledge, -W / 2 + 1, W / 2 - 1))
    # Deck screw posts (vertical), top trimmed to the deck underside.
    deck_posts = [(sx * (W / 2 - 9), 9.0) for sx in (-1, 1)] + \
                 [(sx * (W / 2 - 13), DECK_LEN - 17.0) for sx in (-1, 1)]
    for x, y in deck_posts:                       # supports under the deck
        ztop = FRONT_H + y * T(DA)
        adds.append(cyl(4.5, ztop + 5, x, y, 0))
        adds.append(post_support(x, y, 4.5, wall_x=math.copysign(W / 2 - BASE_WALL + 0.01, x)))
    # A post near the back of the deck carries the deck's click bump.
    adds.append(cyl(4.0, FRONT_H + DECK_DETENT_Y * T(DA) + 5, DECK_DETENT_X, DECK_DETENT_Y, 0))
    # ... and a post at the front middle takes the deck's lock pin.
    adds.append(cyl(DECK_PIN_POST_R, FRONT_H + DECK_PIN_Y * T(DA) + 5, DECK_PIN_X, DECK_PIN_Y, 0))
    adds.append(post_support(DECK_DETENT_X, DECK_DETENT_Y, 4.0))
    adds.append(post_support(DECK_PIN_X, DECK_PIN_Y, DECK_PIN_POST_R))
    body = union([body] + adds)
    # Trim everything to the outside profile.
    body = body ^ solid
    # Deck: slide rails along the side walls' sloped tops (the deck slides in
    # from the front and stops against the seat ribs), and the click bump.
    L = DECK_LEN / math.cos(DA)
    body = body + deck_world(slide_rails(DECK_T, 0, L))
    body = body + deck_world(detent_bump(DECK_DETENT_X, DECK_DETENT_Y / math.cos(DA), 0))
    cuts.append(housing_slots())
    bores = [pin_hole(sx, housing_pin_yz(), HOUSING_RAIL_X) for sx in (-1, 1)]
    bores.append(deck_pin_bore())
    fp_block, fp_cut, fp_add = front_pin_bore()
    body = body + fp_block
    bores.append((fp_cut, fp_add))
    rear_feet_y = BASE_LEN - 22
    if POWER_POD:
        # Floor tongue the pod stands on, and the vertical dovetail rails on the
        # back wall that the pod drops onto.
        body = body + box(-W / 2, W / 2, B[0] - 1, TOTAL_LEN, 0, TONGUE_T)
        z0, z1 = pod_rail_z()
        rails = [dove_section(extra=0.5).extrude(z1 - z0).translate([sx * POD_RAIL_X, B[0], z0])
                 for sx in (-1, 1)]
        # groove across each rail's tip for the pod's lock pin
        py, pz = pod_pin_yz()
        groove = cyl(PIN_HOLE_D / 2, W + 4, 0, 0, 0).rotate([0, 90, 0]).translate([-W / 2 - 2, py, pz])
        rails = [r - groove for r in rails]
        body = union([body] + rails)
        cuts.append(pass_hole(B[0] - BASE_WALL - 10, B[0] + 0.3))
        rear_feet_y = TOTAL_LEN - 14
    # The housing slides on and off along its dovetails, forward and up. Trim
    # the tops of the side walls in front of it to 0.4 mm below the path of
    # its floor, or their front corners would scrape it.
    cuts.append(housing_world(box(-W / 2 - 1, W / 2 + 1, -0.4, WALL + 20, -90, 0.01)))
    # Front: the wall itself is the separate front panel; leave its opening,
    # through the floor, with a slotted post in each front corner.
    iw = W / 2 - BASE_WALL
    cuts.append(box(-iw, iw, -1, FP_T + FP_CLR, -1, FRONT_H + 6))
    post_d = FP_T + FP_CLR + 2.4
    for sx in (-1, 1):
        a, b = sorted((sx * iw, sx * (iw - FP_POST)))
        post = box(a, b, 0, post_d, 0, FRONT_H + 3) ^ profile_xs(
            [(0, 0), (0, FRONT_H), (DECK_LEN, FRONT_H + DECK_LEN * T(DA)), (DECK_LEN, 0)])
        x1 = iw - FP_TONGUE - FP_CLR                      # panel's full-thickness edge
        slot_main = box(*sorted((sx * (x1 + FP_CLR), 0)), -1, FP_T + FP_CLR, -1, FRONT_H + 6)
        slot_tongue = box(*sorted((sx * (iw - FP_CLR + 0.01), 0)), FP_LIP, FP_T + FP_CLR, -1, FRONT_H + 6)
        post = post - slot_main - slot_tongue
        # click bump on the slot's back face, into a dimple in the panel's edge
        xt = sx * (iw - FP_CLR - FP_TONGUE / 2)
        bump = Manifold.cylinder(DETENT_H + FP_CLR, DETENT_R, 0.35, SEG).rotate([90, 0, 0]).translate(
            [xt, FP_T + FP_CLR + 0.01, FP_DETENT_Z])
        late_adds.append(post + bump)
    # Feet recesses under the floor.
    for x in (-W / 2 + 16, W / 2 - 16):
        for y in (16, rear_feet_y):
            cuts.append(cyl(6.5, 1.2, x, y, -0.2))
    body = union([body - union(cuts)] + late_adds)
    body = add_pin_bores(body, bores)
    # drop zero-volume slivers the deck pin's tilted ramps leave behind; the base is one piece
    return max(body.decompose(), key=lambda m: m.volume()), deck_posts


def power_pod():
    """Closed box for the brick, modelled in world coordinates (print as is)."""
    g = POD
    w = POD_WALL
    z0, z_top, yb, yf = g["z0"], g["z_top"], g["yb"], g["yf"]
    front = g["front"]
    outer = profile_xs([(yf, z0), (yf, g["z_v"]), (front(z_top), z_top), (yb, z_top), (yb, z0)])
    # Inside: walls of thickness w (the slanted part measured square to its face).
    c_in = POD_GAP_S / math.cos(RA) + w / math.cos(RA)
    slant_in = lambda z: B[0] + c_in + (z - B[1]) * T(RA)
    yf_in = yf + w
    z_vi = B[1] + (yf_in - B[0] - c_in) / T(RA)
    zi0 = z0 + w
    zt = z_top + 5
    inner = profile_xs([(yf_in, zi0), (yf_in, z_vi), (slant_in(zt), zt), (yb - w, zt), (yb - w, zi0)],
                       W - 2 * w)
    pod = outer - inner
    fin = lambda z: yf_in if z <= z_vi else slant_in(z)

    adds, cuts = [], []
    xb0, xb1, yb0, yb1, zb0, zb1 = g["brick"]
    # Slots for the base's vertical dovetail rails: open at the bottom, closed
    # at the top, in thickened pads behind the front wall.
    rz0, rz1 = pod_rail_z()
    half = DOVE_TIP / 2 + DOVE_CLR
    for sx in (-1, 1):
        x = sx * POD_RAIL_X
        adds.append(box(x - half - 2.4, x + half + 2.4, yf_in - 0.01, B[0] + DOVE_H + DOVE_CLR + 2.6,
                        zi0 - 0.01, rz1 + 2.5))
        cuts.append(dove_section(clr=DOVE_CLR, extra=1.5).extrude(rz1 + 0.5 - (z0 - 1))
                    .translate([x, B[0], z0 - 1]))
    # The 1.5" cable hole through the front wall, into the space under the buttons.
    cuts.append(pass_hole(yf - 1, slant_in(TONGUE_T + POD_WALL + PASS_HOLE_D) + 1.5))
    bores = []
    # Lock pin holes through each side wall into the rail pads.
    for sx in (-1, 1):
        bores.append(pin_hole(sx, pod_pin_yz(), POD_RAIL_X))
    # Lid: slide rails along the side walls' tops (the lid slides in from the
    # back until it meets the housing's back) and a click bump on the back wall.
    # (the rails run forward to the housing; they're trimmed with the front fill below)
    lid_rails = slide_rails(LID_T, plate_face_y(z_top) - 3, yb, z_top)
    adds.append(detent_bump(POD_DETENT_X, yb - w / 2 - 0.4, z_top))
    # Block for the lid's lock pin, on the inside of the back wall.
    lp_block, lp_cut, lp_add = lid_pin_bore()
    adds.append(lp_block)
    bores.append((lp_cut, lp_add))
    # Fill the space in front of the pod's sloped face, then cut away
    # everything within POD_FACE_GAP of the housing and its back plate. The
    # front then follows the plate and its rails 0.4 mm away, and stays
    # straight (y = yf) against the base below the housing, with no wedge gaps.
    # (bounded by the plate's outer face plus the gap, so nothing reaches
    # into the housing or the plate's vents)
    zc = B[1] + (yf - plate_face_y(B[1], POD_FACE_GAP)) / T(RA)   # that line meets y = yf
    fill = x_extrude([(yf, g["z_v"]), (front(z_top), z_top), (plate_face_y(z_top, POD_FACE_GAP), z_top),
                      (yf, zc)], -W / 2, W / 2)
    shift = [0, POD_FACE_GAP * DOWN_BACK[0], POD_FACE_GAP * DOWN_BACK[1]]
    hous = union([housing_world(housing()), housing_world(back_plate().translate([0, 0, DEPTH]))])
    # sweep the housing through the gap (if any), so undercuts (the rails' lips) are covered too
    # (and 0.3 mm down along the face, so nothing touches the housing's bottom edge)
    down = [0, -0.3 * UP_FACE[0], -0.3 * UP_FACE[1]]
    # and 8 mm along its way off (forward and up), so the rails' undercut lips
    # can't catch the pod as the housing starts to slide.
    moves = [[v * k + d * j for v, d in zip(shift, down)] for k in (0, 0.25, 0.5, 0.75, 1.0) for j in (0, 1)]
    off = [0, -DOWN_BACK[0], -DOWN_BACK[1]]                  # the housing's way off, per mm
    moves += [[v * k for v in off] for k in (0.25, 0.5, 0.75, 1, 1.5, 2, 3, 4, 5, 6, 8)]
    swept = union([hous.translate(m) for m in moves])
    adds.append(fill - swept)
    adds.append(lid_rails - swept)
    # Brick locators: a low rib in front of it and a short stop past its cable end.
    adds.append(box(xb0 + 6, xb1 - 6, yb0 - 3.0 - PSU_CLR, yb0 - PSU_CLR, zi0 - 0.01, zi0 + 5))
    # IEC socket in the back wall: the cutout, and the bores for the two
    # quarter-turn pins that hold the keeper frame over its front plate.
    iw, ih = INLET_CUT
    izc = inlet_zc()
    cuts.append(box(INLET_X - iw / 2, INLET_X + iw / 2, yb - w - 1, yb + 1, izc - ih / 2, izc + ih / 2))
    for dx in (-KEEPER_PIN_DX, KEEPER_PIN_DX):
        bores.append(back_wall_bore(INLET_X + dx, izc))
    # Zip-tie anchors (a bar with a tunnel) for the cord socket and the cords.
    for x, y in [(xb0 - 20, (yb0 + yb1) / 2), (INLET_X + 30, g["yf"] + 16),
                 (xb1 + 16, yb1 - 6)]:
        adds.append(box(x - 5, x + 5, y - 4, y + 4, zi0 - 0.01, zi0 + 6))
        cuts.append(box(x - 6, x + 6, y - 2, y + 2, zi0 + 1.2, zi0 + 3.8))
    # Vent slots in the back wall above the cable coil (away from the mains side).
    for i in range(6):
        x = xb1 + 6 + i * 6
        if x + 2.5 < W / 2 - 14:
            cuts.append(box(x, x + 2.5, yb - w - 1, yb + 1, z_top - 30, z_top - 8))
    pod = add_pin_bores(union([pod] + adds) - union(cuts), bores)
    # drop any zero-volume slivers the trimming leaves behind; the pod is one piece
    return max(pod.decompose(), key=lambda m: m.volume())

def inlet_zc():
    """Height of the power socket's centre: its front plate clears the pod's floor."""
    return POD["z0"] + POD_WALL + 5 + INLET_SCREW_SPACING / 2 + 2


def keeper_t():
    return INLET_PLATE[2] - KEEPER_SQUEEZE + KEEPER_FACE


def back_wall_bore(x, z):
    """A lock-pin bore (hole, slot, turning pocket, ramps) through the pod's
    back wall at (x, z), pin axis along -Y. Built as a side-wall bore and
    turned a quarter turn about Z."""
    cut, add = pin_bore(1, 0.0, z, W / 2 - PIN_WALL - 3.0)
    move = lambda m: m.rotate([0, 0, 90]).translate([x, POD["yb"] - W / 2, 0])
    return move(cut), move(add)


def keeper_pin_place(m, x, locked=True):
    """Put a keeper pin (as modelled by lock_pin) in its hole at x: head on the
    keeper's outer face."""
    m = pin_place(m, 1, 0.0, inlet_zc(), locked)
    return m.rotate([0, 0, 90]).translate([x, POD["yb"] - W / 2 + keeper_t(), 0])


def keeper_pin():
    return lock_pin(keeper_pin_len(), grip=keeper_t() + PIN_WALL)


def keeper_pin_len():
    return keeper_t() + PIN_WALL + LUG_GAP + LUG_T + 1.2      # short tail: the cord socket sits close inside


def socket_keeper():
    """Frame over the power socket's front plate, in world coordinates. A
    pocket in its back fits the plate, a window lets the raised face (plug,
    switch and fuse drawer) through, and two lock pins clamp it to the back
    wall: it presses on the plate around the face, mostly above and below it."""
    yb, izc, kt = POD["yb"], inlet_zc(), keeper_t()
    pw, ph, pt = INLET_PLATE
    hw, hh = KEEPER_PIN_DX + 6.0, ph / 2 + 4.0
    frame = (rrect(2 * hw, 2 * hh, 4.0).extrude(kt)          # in (x, z), thickness along +Y
             .rotate([-90, 0, 0]).translate([INLET_X, yb, izc]))
    cuts = [box(INLET_X - pw / 2 - 0.5, INLET_X + pw / 2 + 0.5, yb - 1, yb + pt - KEEPER_SQUEEZE,
                izc - ph / 2 - 0.5, izc + ph / 2 + 0.5),
            box(INLET_X - INLET_FACE[0] / 2 - KEEPER_WINDOW_CLR, INLET_X + INLET_FACE[0] / 2 + KEEPER_WINDOW_CLR,
                yb - 1, yb + kt + 1,
                izc - INLET_FACE[1] / 2 - KEEPER_WINDOW_CLR, izc + INLET_FACE[1] / 2 + KEEPER_WINDOW_CLR)]
    win_half = INLET_FACE[0] / 2 + KEEPER_WINDOW_CLR
    for dx in (-KEEPER_PIN_DX, KEEPER_PIN_DX):
        x = INLET_X + dx
        cuts.append(cyl(PIN_HOLE_D / 2, kt + 2, 0, 0, 0).rotate([-90, 0, 0]).translate([x, yb - 1, izc]))
        # if the window comes within 1 mm of the pin hole, open it right into the
        # hole rather than leave a sliver too thin to print
        if KEEPER_PIN_DX - PIN_HOLE_D / 2 - win_half < 1.0:
            sgn = 1 if dx > 0 else -1
            a, b = sorted((INLET_X + sgn * (win_half - 0.5), x))
            cuts.append(box(a, b, yb - 1, yb + kt + 1, izc - PIN_HOLE_D / 2, izc + PIN_HOLE_D / 2))
        cuts.append(box(x - KEYWAY_W / 2, x + KEYWAY_W / 2, yb - 1, yb + kt + 1, izc, izc + KEYWAY_R))
    return frame - union(cuts)


POD_DETENT_X = -30.0            # click bump on the back wall's top

# Panel pins: one quarter-turn pin each through the pod lid and the button deck,
# straight down into a block under it, so neither can slide out. Same pin for
# both: it grips 5.4 mm (deck 3.0 + a 2.4 mm shelf; lid 2.4 + a 3.0 mm shelf).
PANEL_PIN_GRIP = DECK_T + PIN_WALL
LID_PIN_X = -25.0               # lid pin: across (world X), clear of the brick and the socket
LID_PIN_IN = 5.5                # ... this far in from the back wall's inside face
LID_BLOCK_W = 14.0              # the block it locks into, on the back wall's inside
DECK_PIN_X, DECK_PIN_Y = 0.0, 14.0   # deck pin: front middle, between the buttons
DECK_PIN_POST_R = 6.0


def _down_frame(px, py, zface):
    """Transform for a pin bore built by pin_bore(1, 0, 0, ...) (axis along X,
    outside at x = W/2, keyway along +Z) so that it points straight down at
    (px, py), its outside face at height zface, keyway towards -Y."""
    return lambda m: m.transform([[0, -1, 0, px], [0, 0, -1, py], [1, 0, 0, zface - W / 2]])


def panel_pin_len():
    return PANEL_PIN_GRIP + LUG_GAP + LUG_T + 1.2


def panel_pin():
    return lock_pin(panel_pin_len(), grip=PANEL_PIN_GRIP)


def _panel_bore(frame):
    cut, add = pin_bore(1, 0.0, 0.0, W / 2 - 7.5)
    return frame(cut), frame(add)


def _panel_hole(px, py, t):
    """Hole and keyway through a panel t thick (its own frame, bottom z = 0)."""
    return union([cyl(PIN_HOLE_D / 2, t + 2, px, py, -1),
                  box(px - KEYWAY_W / 2, px + KEYWAY_W / 2, py - KEYWAY_R, py, -1, t + 1)])


def lid_pin_xy():
    return LID_PIN_X, POD["yb"] - POD_WALL - LID_PIN_IN


def lid_pin_bore():
    """Shelf block on the inside of the pod's back wall (45-degree underside),
    top flush with the walls, with the bore whose 2.4 mm 'wall' sits 0.6 mm
    below the top (so the grip matches the deck's)."""
    px, py = lid_pin_xy()
    zt, yw = POD["z_top"], POD["yb"] - POD_WALL
    d = LID_PIN_IN * 2
    block = x_extrude([(yw + 0.01, zt), (yw - d, zt), (yw - d, zt - 8), (yw + 0.01, zt - 8 - d)],
                      px - LID_BLOCK_W / 2, px + LID_BLOCK_W / 2)
    cut, add = _panel_bore(_down_frame(px, py, zt - (PANEL_PIN_GRIP - LID_T - PIN_WALL)))
    return block, cut, add


def lid_pin_place(m, locked=True):
    """Lid pin in place: head on the lid's top."""
    px, py = lid_pin_xy()
    return _down_frame(px, py, POD["z_top"] + LID_T)(_pin_local(m, locked))


def _pin_local(m, locked):
    """A pin as pin_place puts it on side +1 at (y, z) = (0, 0): head outside x = W/2."""
    return pin_place(m, 1, 0.0, 0.0, locked)


FRONT_PIN_X, FRONT_PIN_Z = 66.0, 8.0   # front panel pin: low on the right, clear of the logo
FRONT_PIN_BLOCK = (14.0, 10.0, 14.0)  # block behind the panel it locks into: width, depth, top height


def _back_frame(px, pz, yface):
    """Transform for a pin bore built by pin_bore(1, 0, 0, ...) so that it
    points straight back (+Y) at (px, pz), its outside face at y = yface,
    keyway pointing up."""
    return lambda m: m.transform([[0, 1, 0, px], [-1, 0, 0, yface + W / 2], [0, 0, 1, pz]])


def front_pin_bore():
    """Block on the base's floor right behind the front panel, with the bore.
    The bore's 2.4 mm 'wall' starts at the panel's back face (y = FP_T); the
    block starts 0.25 mm behind it (the panel's sliding clearance), so the
    lock has that much play."""
    bw, bd, bt = FRONT_PIN_BLOCK
    block = box(FRONT_PIN_X - bw / 2, FRONT_PIN_X + bw / 2, FP_T + FP_CLR, FP_T + FP_CLR + bd, BASE_WALL - 0.01, bt)
    cut, add = _panel_bore(_back_frame(FRONT_PIN_X, FRONT_PIN_Z, FP_T))
    return block, cut, add


def front_pin_hole():
    return union([cyl(PIN_HOLE_D / 2, FP_T + 2, 0, 0, 0).rotate([-90, 0, 0]).translate([FRONT_PIN_X, -1, FRONT_PIN_Z]),
                  box(FRONT_PIN_X - KEYWAY_W / 2, FRONT_PIN_X + KEYWAY_W / 2, -1, FP_T + 1,
                      FRONT_PIN_Z, FRONT_PIN_Z + KEYWAY_R)])


def front_pin_place(m, locked=True):
    """Front panel pin in place: head on the panel's front face."""
    return _back_frame(FRONT_PIN_X, FRONT_PIN_Z, 0.0)(_pin_local(m, locked))


def deck_pin_local():
    """Deck pin position in the deck's own frame (x, along the slope)."""
    return DECK_PIN_X, DECK_PIN_Y / math.cos(DA)


def deck_pin_bore():
    x, s = deck_pin_local()
    cut, add = _panel_bore(_down_frame(x, s, 0.0))
    return deck_world(cut), deck_world(add)


def deck_pin_place(m, locked=True):
    """Deck pin in place: head on the deck's top."""
    x, s = deck_pin_local()
    return deck_world(_down_frame(x, s, DECK_T)(_pin_local(m, locked)))

def back_rail_x():
    """Inside edge of the housing back plate's rail lips (world X)."""
    return W / 2 - SLIDE_NECK - BACK_T - 0.4


def plate_face_y(z, extra=0.0):
    """World Y of the housing back plate's outer face at height z, plus a gap
    `extra` measured square to the face."""
    return B[0] + (z - B[1]) * T(RA) + extra / math.cos(RA)


def pod_lid():
    """Slides in from the back under the rails on the pod's side walls until
    its front edge meets the housing's back plate (its front face is cut at the
    plate's angle, POD_FACE_GAP away), and clicks onto a bump on the back wall."""
    g = POD
    zt = g["z_top"]
    y1 = g["yb"]
    lid = slide_panel(LID_T, plate_face_y(zt) - 2, y1)
    cuts = [detent_dimple(POD_DETENT_X, y1 - POD_WALL / 2 - 0.4), _panel_hole(*lid_pin_xy(), LID_T)]
    rx = back_rail_x()
    for x0, x1, gap in ((-rx, rx, POD_LID_GAP), (rx - 0.01, W, POD_LID_GAP + SLIDE_LIP),
                        (-W, -rx + 0.01, POD_LID_GAP + SLIDE_LIP)):
        ya, yb_ = plate_face_y(zt - 1, gap), plate_face_y(zt + LID_T + 1, gap)
        cuts.append(x_extrude([(ya - 20, -1), (ya, -1), (yb_, LID_T + 1), (ya - 20, LID_T + 1)], x0, x1))
    # Vent slots over the brick and cable coil only (never over the mains side).
    xb0, xb1, yb0, yb1, _, _ = g["brick"]
    for i in range(10):
        x = xb0 + 4 + i * 6
        if x + 2.5 < W / 2 - 14:
            cuts.append(box(x, x + 2.5, yb0 + 4, yb1 - 4, -1, LID_T + 1))
    return lid - union(cuts)

def lock_pin(length=None, cam_from=None, grip=PIN_WALL):
    """Quarter-turn lock pin, modelled as printed: wing head flat on the bed,
    shaft up. The lug (local +X) lines up with the head's long axis, so the
    head shows the lock state: along the slot = open, crosswise = locked.
    The lug's flat underside is a 1.4 mm overhang, which prints fine."""
    length = PIN_LEN if length is None else length
    L, Wd, T = PIN_HEAD_L, PIN_HEAD_W, PIN_HEAD_T
    head = rrect(L, Wd, Wd / 2 - 0.01).extrude(T)
    if cam_from is None:
        shaft = cyl(PIN_D / 2, length - 0.6, 0, 0, T - 0.01)
        tip = Manifold.cylinder(0.6, PIN_D / 2, PIN_D / 2 - 0.5, SEG).translate([0, 0, T + length - 0.61])
    else:
        # Screen pin: round shaft to the post, then the cam: round CAM_D with
        # flats on the lug's sides (local X), so the round side (local Y) faces
        # the board once the pin is turned to locked.
        end = T + length
        shaft = cyl(PIN_D / 2, cam_from - T + 0.01, 0, 0, T - 0.01)
        cam = (Manifold.cylinder(end - cam_from, CAM_D / 2, CAM_D / 2, SEG)
               .translate([0, 0, cam_from])
               ^ box(-CAM_FLAT, CAM_FLAT, -CAM_D, CAM_D, cam_from, end))
        # lead-in where it steps up from the shaft, and a rounded-off tip
        step = Manifold.cylinder(0.4, PIN_D / 2, CAM_D / 2, SEG).translate([0, 0, cam_from - 0.4])
        tip = (Manifold.cylinder(0.6, CAM_D / 2, CAM_D / 2 - 0.5, SEG).translate([0, 0, end - 0.6])
               ^ box(-CAM_FLAT, CAM_FLAT, -CAM_D, CAM_D, end - 0.6, end))
        cam = cam - box(-5, 5, -5, 5, end - 0.6, end + 1)
        shaft = union([shaft, cam, step ^ box(-CAM_FLAT, CAM_FLAT, -CAM_D, CAM_D, 0, end)])
    z0 = T + grip + LUG_GAP
    lug = box(PIN_D / 2 - 0.3, LUG_R, -LUG_W / 2, LUG_W / 2, z0, z0 + LUG_T)
    lug = lug ^ cyl(LUG_R, LUG_T + 1, 0, 0, z0 - 0.5)          # round its outer end
    return union([head, shaft, tip, lug])


DECK_DETENT_X, DECK_DETENT_Y = 0.0, DECK_LEN - 7.0   # click post near the back of the deck


def front_panel():
    """The base's front wall, in world coordinates: slides up from underneath
    in the corner posts' slots, its top following the deck's underside."""
    iw = W / 2 - BASE_WALL
    x1 = iw - FP_TONGUE - FP_CLR
    xe = iw - FP_CLR - 0.15
    top = profile_xs([(-1, -1), (-1, FRONT_H - 0.3 - 1 * T(DA)), (FP_T + 1, FRONT_H - 0.3 + (FP_T + 1) * T(DA)),
                      (FP_T + 1, -1)])
    panel = box(-x1, x1, 0, FP_T, 0, FRONT_H + 2)
    tongues = [box(*sorted((sx * x1 - sx * 0.01, sx * xe)), FP_LIP + FP_CLR, FP_T, 0, FRONT_H + 2)
               for sx in (-1, 1)]
    panel = union([panel] + tongues) ^ top
    dimples = [Manifold.cylinder(DETENT_H + 0.3, DETENT_R + 0.3, 0.6, SEG).rotate([90, 0, 0])
               .translate([sx * (iw - FP_CLR - FP_TONGUE / 2), FP_T + 0.01, FP_DETENT_Z]) for sx in (-1, 1)]
    return panel - union(dimples) - front_pin_hole()


LOGO_SCALE = 0.9                # front panel logo, relative to the logo3d plaque (144 x 36 mm)
LOGO_DEPTH = 0.8                # how deep the coloured logo sits into the front face


def front_logo():
    """The logo inlaid flush into the front panel's front face, by colour:
    {"yellow": ..., "white": ..., "gray": ...} in world coordinates."""
    import sys
    sys.path.insert(0, str(Path(__file__).resolve().parent.parent / "logo3d"))
    from make_logo import logo_2d
    shapes = logo_2d()
    allc = shapes["yellow"] + shapes["white"] + shapes["gray"]
    (u0, v0), (u1, v1) = allc.bounds()[:2], allc.bounds()[2:]
    cu, cv = (u0 + u1) / 2, (v0 + v1) / 2
    zc = FRONT_H / 2 - 0.5
    out = {}
    for colour, cs in shapes.items():
        m = cs.translate([-cu, -cv]).scale([LOGO_SCALE, LOGO_SCALE]).extrude(LOGO_DEPTH + 0.01)
        # (u, v, w) -> (u, -w, v): u = user-right, v = up, into the face along +y
        out[colour] = m.rotate([90, 0, 0]).translate([0, LOGO_DEPTH, zc])
    return out


def front_panel_parts():
    """The front panel split by colour: {"dark": panel minus logo (case colour),
    "yellow": bubble + "Labels", "white": "Voice", "gray": tagline}."""
    panel = front_panel()
    logo = {k: v ^ panel for k, v in front_logo().items()}
    return {"dark": panel - union(list(logo.values())), **logo}


def deck(deck_posts):
    """Slides in from the front under the rails on the base's side walls,
    stops against the seat ribs, and clicks onto a bump on a post."""
    L = DECK_LEN / math.cos(DA)               # length along the slope
    plate = slide_panel(DECK_T, 0, L - SLIDE_CLR)
    cuts = [detent_dimple(DECK_DETENT_X, DECK_DETENT_Y / math.cos(DA)), _panel_hole(*deck_pin_local(), DECK_T)]
    s_mid = L / 2 + 4
    for sx, label in ((-1, "TALK"), (1, "PRINT")):
        cuts.append(cyl(BUTTON_HOLE / 2, DECK_T + 2, sx * BUTTON_SPACING / 2, s_mid, -1))
        # thin the plate around the hole from underneath so snap-in clips can grip
        cuts.append(cyl(BUTTON_RECESS_D / 2, DECK_T - BUTTON_PANEL_T + 1,
                        sx * BUTTON_SPACING / 2, s_mid, -1))
        txt = text_cross_section(label, 7.0).extrude(1.0)
        cuts.append(txt.translate([sx * BUTTON_SPACING / 2, s_mid - BUTTON_HOLE / 2 - 8,
                                   DECK_T - 0.6]))
    # Lip along the back edge: it stands in front of the bottom of the screen
    # bezel and stops the housing sliding back out along its rails.
    xt = W / 2 - SLIDE_NECK - SLIDE_CLR - DECK_T          # the deck's top face reaches this far
    plate = plate + box(-xt, xt, L - SLIDE_CLR - DECK_LIP_D, L - SLIDE_CLR + DECK_LIP_REACH, DECK_T - 0.01,
                        DECK_T + DECK_LIP_H)
    # Trim the front end face vertical in world terms, flush with the front panel
    # below it (cut square to the slope, its top corner would stand 0.4 mm proud).
    ca, sa = math.cos(DA), math.sin(DA)
    front = box(-W, W, -20, 0, FRONT_H - 20, FRONT_H + 30).translate([0, 0, -FRONT_H]).transform(
        [[1, 0, 0, 0], [0, ca, sa, 0], [0, -sa, ca, 0]])
    cuts.append(front)
    return plate - union(cuts), s_mid

# ------------------------------------------------------------------ assembly transforms
def housing_world(m):
    # Explicit affine: world = R * p + t, columns are images of X, Y, Z.
    ex = [-1, 0, 0]
    ey = [0, UP_FACE[0], UP_FACE[1]]
    ez = [0, DOWN_BACK[0], DOWN_BACK[1]]
    mat = [[ex[0], ey[0], ez[0], 0], [ex[1], ey[1], ez[1], E[0]], [ex[2], ey[2], ez[2], E[1]]]
    return m.transform(mat)

def deck_world(m):
    ca, sa = math.cos(DA), math.sin(DA)
    mat = [[1, 0, 0, 0], [0, ca, -sa, 0], [0, sa, ca, FRONT_H]]
    return m.transform(mat)

# ------------------------------------------------------------------ export
def to_trimesh(m):
    import trimesh
    mesh = m.to_mesh()
    return trimesh.Trimesh(vertices=np.asarray(mesh.vert_properties)[:, :3],
                           faces=np.asarray(mesh.tri_verts), process=True)

def place_on_bed(m):
    (x0, y0, z0, x1, y1, z1) = m.bounding_box()
    return m.translate([-(x0 + x1) / 2, -(y0 + y1) / 2, -z0])

def build():
    out = Path(__file__).with_name("out")
    out.mkdir(exist_ok=True)
    h = housing()
    bp = back_plate()
    b, posts = base()
    d, s_mid = deck(posts)
    parts = {
        "1_housing": h,                                   # face-down as modelled
        "2_back_plate": bp,
        "3_screen_pin_x4": union([lock_pin(screen_pin_len(), screen_pin_cam_from()).translate([i * 12, 0, 0])
                                   for i in range(4)]),
        "4_base": b,
        "5_deck": d,                                      # top face up: labels print last, crisp
        "11_front_panel": front_panel().rotate([-90, 0, 0]),   # inside face down, front face up
        "8_lock_pin_x4": union([lock_pin().translate([i * 12, 0, 0]) for i in range(4)]),
        "12_panel_pin_x3": union([panel_pin().translate([i * 12, 0, 0]) for i in range(3)]),
    }
    # The front panel split by colour: all four keep the same placement, so they
    # load together as one multi-part object (one filament per part).
    fpp = {k: v.rotate([-90, 0, 0]) for k, v in front_panel_parts().items()}
    x0, y0, z0, x1, y1, z1 = fpp["dark"].bounding_box()
    shift = [-(x0 + x1) / 2, -(y0 + y1) / 2, -z0]
    aligned = {}
    for key, tag in (("dark", "11a_front_panel_main"), ("yellow", "11b_front_logo_yellow"),
                     ("white", "11c_front_logo_voice"), ("gray", "11d_front_logo_tagline")):
        aligned[tag] = fpp[key].translate(shift)
    if POWER_POD:
        parts["6_power_pod"] = power_pod()                # as modelled: floor down
        parts["7_pod_lid"] = pod_lid().mirror([0, 0, 1])  # top face down, lip up
        parts["9_socket_keeper"] = socket_keeper().rotate([-90, 0, 0])  # outer face down, pocket up
        parts["10_socket_pin_x2"] = union([keeper_pin().translate([i * 12, 0, 0]) for i in range(2)])
    report = {}
    for name, m in list(parts.items()) + list(aligned.items()):
        m = place_on_bed(m) if name in parts else m
        x0, y0, z0, x1, y1, z1 = m.bounding_box()
        report[name] = (round(x1 - x0, 1), round(y1 - y0, 1), round(z1 - z0, 1),
                        m.status().name, m.genus())
        to_trimesh(m).export(out / f"{name}.stl")
    # Assembly in world coordinates.
    hw = housing_world(h)
    bpw = housing_world(bp.translate([0, 0, DEPTH]))
    dw = deck_world(d)
    fpw = front_panel_parts()
    asm = {"housing": hw, "back_plate": bpw, "base": b, "deck": dw, "front_panel": fpw["dark"],
           "front_logo_yellow": fpw["yellow"], "front_logo_white": fpw["white"],
           "front_logo_gray": fpw["gray"]}
    if POWER_POD:
        asm["power_pod"] = power_pod()
        asm["pod_lid"] = pod_lid().translate([0, 0, POD["z_top"]])
        asm["socket_keeper"] = socket_keeper()
    return report, asm, s_mid

if __name__ == "__main__":
    rep, asm, _ = build()
    for k, v in rep.items():
        print(f"{k:14s} {v[0]:6.1f} x {v[1]:6.1f} x {v[2]:6.1f} mm  {v[3]} genus={v[4]}")
    # Interference checks between assembled parts
    names = list(asm)
    for i in range(len(names)):
        for j in range(i + 1, len(names)):
            v = (asm[names[i]] ^ asm[names[j]]).volume()
            print(f"overlap {names[i]} / {names[j]}: {v:.1f} mm^3")
    if POWER_POD:
        xb0, xb1, yb0, yb1, zb0, zb1 = POD["brick"]
        brick = box(xb0, xb1, yb0, yb1, zb0, zb1)
        print(f"brick vs pod: {(brick ^ asm['power_pod']).volume():.1f} mm^3,"
              f" brick vs lid: {(brick ^ asm['pod_lid']).volume():.1f} mm^3")
        print("pod: front y %.1f, back y %.1f, top z %.1f" % (POD["yf"], POD["yb"], POD["z_top"]))
    allm = union(list(asm.values()))
    x0, y0, z0, x1, y1, z1 = allm.bounding_box()
    print(f"assembled size: {x1-x0:.0f} W x {y1-y0:.0f} D x {z1-z0:.0f} H mm")
    to_trimesh(allm).export(Path(__file__).with_name("out") / "assembly_preview.stl")
