ScottYates/VoiceLabels/labelbox/app.py

"""Voice label printer: hold the button, speak, edit, see the label, print.

    python3 app.py              # normal (fullscreen, prints to the Zebra)
    python3 app.py --dry-run    # saves labels to ./out instead of printing
    python3 app.py --windowed   # not fullscreen (handy when testing)

Keys: F1 talk (press to start, press again to stop)   F2 date on/off
      F3 QR on/off   F4 landscape/portrait   F5 left/center/right   F6 icon
      Ctrl+P or Ctrl+Enter print
      Esc clear text   Ctrl+Shift+Q quit
Touch: tap TALK then press and hold it again = clear and start over;
       press and hold the text box or preview = screen off
"""

from __future__ import annotations

import argparse
import datetime as dt
import glob
import json
import os
from pathlib import Path
import queue
import subprocess
import time
import threading
import tkinter as tk

from PIL import Image, ImageTk

import config
import icons
import printer
from hardware import Button
import iconlib
import labels
import network
import voicecmd
from spelling import hyphenate_spelling
from render import LabelSpec, canvas_size, for_printer, render
from stt import PushToTalk
from zpl import image_to_zpl

BG = "#1e1f22"
PANEL = "#2b2d31"
FG = "#f2f3f5"
MUTED = "#a4a7ad"
ACCENT = "#f0b232"
REC = "#e5484d"
OK = "#3fb950"
INPUT_BG = "#14161a"      # text box: darker than the panel, unlike the white label
INPUT_EDGE = "#4a4f57"
LINER = "#c9b98f"         # label backing paper in the preview
LABEL_GHOST = "#d9d6cc"   # neighbouring labels on the roll


def today() -> str:
    return dt.date.today().strftime(config.DATE_FORMAT)


class PowerTile(tk.Canvas):
    """A large square-ish tile: drawn icon, label and a short note, all inside.
    Tapping calls on_tap; the owner switches it between normal and armed."""

    def __init__(self, master, kind, label, note, font_big, font_note, on_tap, accent,
                 icon=None, icon_armed=None):
        super().__init__(master, bg=BG, highlightthickness=0, bd=0, cursor="hand2")
        self.kind, self.label, self.note = kind, label, note
        self.icon, self.icon_armed = icon, icon_armed
        self.font_big, self.font_note, self.accent = font_big, font_note, accent
        self.armed_text = None
        self.bind("<Configure>", lambda e: self.draw())
        self.bind("<ButtonRelease-1>", lambda e: on_tap())

    def set_armed(self, text):
        self.armed_text = text
        self.draw()

    @staticmethod
    def _rrect(c, x0, y0, x1, y1, r, **kw):
        pts = [x0 + r, y0, x1 - r, y0, x1, y0, x1, y0 + r, x1, y1 - r, x1, y1,
               x1 - r, y1, x0 + r, y1, x0, y1, x0, y1 - r, x0, y0 + r, x0, y0]
        return c.create_polygon(pts, smooth=True, **kw)

    def draw(self):
        self.delete("all")
        w, h = self.winfo_width(), self.winfo_height()
        if w < 20 or h < 20:
            return
        armed = self.armed_text is not None
        bg = REC if armed else PANEL
        self._rrect(self, 2, 2, w - 2, h - 2, 18, fill=bg, outline="")
        fg = "#ffffff" if armed else FG
        icon_col = "#ffffff" if armed else self.accent
        cx, cy, r = w / 2, h * 0.34, min(w, h) * 0.16
        lw = max(4, int(r / 5))
        if self.icon is not None:
            self.create_image(cx, cy, image=self.icon_armed if armed else self.icon)
        elif self.kind == "shutdown":                      # power symbol
            self.create_arc(cx - r, cy - r, cx + r, cy + r, start=120, extent=300,
                            style="arc", outline=icon_col, width=lw)
            self.create_line(cx, cy - r * 1.15, cx, cy - r * 0.15, fill=icon_col, width=lw,
                             capstyle="round")
        elif self.kind == "restart":                     # circular arrow
            self.create_arc(cx - r, cy - r, cx + r, cy + r, start=110, extent=290,
                            style="arc", outline=icon_col, width=lw)
            import math as _m
            a = _m.radians(110)
            ex, ey = cx + r * _m.cos(a), cy - r * _m.sin(a)
            s_ = r * 0.55
            self.create_polygon(ex - s_ * 0.2, ey - s_ * 0.55, ex + s_ * 0.85, ey - s_ * 0.05,
                                ex - s_ * 0.2, ey + s_ * 0.6, fill=icon_col, outline="")
        else:                                            # monitor (desktop)
            self.create_rectangle(cx - r * 1.25, cy - r * 0.9, cx + r * 1.25, cy + r * 0.6,
                                  outline=icon_col, width=lw)
            self.create_line(cx, cy + r * 0.6, cx, cy + r * 1.05, fill=icon_col, width=lw)
            self.create_line(cx - r * 0.6, cy + r * 1.1, cx + r * 0.6, cy + r * 1.1,
                             fill=icon_col, width=lw, capstyle="round")
        main = self.armed_text if armed else self.label
        self.create_text(cx, h * 0.66, text=main, fill=fg, font=self.font_big, justify="center",
                         width=w - 24)
        if not armed:
            self.create_text(cx, h * 0.87, text=self.note, fill=MUTED, font=self.font_note,
                             justify="center", width=w - 24)


class HoldButton(tk.Canvas):
    """A button that must be held for `seconds` before it fires.

    While held, a green bar sweeps across it and the label counts down.
    Letting go early cancels. begin()/end() can also be driven by a
    physical button.
    """

    def __init__(self, master, text, font, seconds, on_fire, on_start=None,
                 on_cancel=None, bg=ACCENT, fill=OK, fg="#000000", icon=None):
        super().__init__(master, highlightthickness=0, bd=0, bg=bg, height=1, cursor="hand2")
        self.text, self.font, self.seconds = text, font, seconds
        self.icon = icon                                  # a PhotoImage drawn left of the label
        import tkinter.font as tkfont
        self._measure = tkfont.Font(font=font).measure
        self.on_fire, self.on_start, self.on_cancel = on_fire, on_start, on_cancel
        self.bg, self.fill, self.fg = bg, fill, fg
        self._t0 = None
        self._job = None
        self.bind("<Configure>", lambda e: self._draw(0.0))
        self.bind("<ButtonPress-1>", lambda e: self.begin())
        self.bind("<ButtonRelease-1>", lambda e: self.end())

    def _draw(self, p, label=None):
        w, h = self.winfo_width(), self.winfo_height()
        self.delete("all")
        self.create_rectangle(0, 0, w, h, fill=self.bg, width=0)
        if p > 0:
            self.create_rectangle(0, 0, int(w * min(p, 1.0)), h, fill=self.fill, width=0)
        text = label or self.text
        if self.icon is None:
            self.create_text(w // 2, h // 2, text=text, font=self.font, fill=self.fg)
            return
        iw, gap = self.icon.width(), max(8, self.icon.width() // 3)
        total = iw + gap + self._measure(text)
        x0 = (w - total) // 2
        self.create_image(x0 + iw // 2, h // 2, image=self.icon)
        self.create_text(x0 + iw + gap, h // 2, text=text, font=self.font, fill=self.fg, anchor="w")

    def begin(self):
        if self._t0 is not None:
            return
        if self.on_start and self.on_start() is False:
            return                                      # nothing to print, etc.
        if self.seconds <= 0:                           # no hold required
            self._draw(1.0, "PRINTING")
            self.after(700, lambda: self._draw(0.0))
            self.on_fire()
            return
        self._t0 = time.monotonic()
        self._tick()

    def _tick(self):
        p = (time.monotonic() - self._t0) / self.seconds
        if p >= 1.0:
            self._t0 = None
            self._draw(1.0, "PRINTING")
            self.after(700, lambda: self._draw(0.0))
            self.on_fire()
            return
        left = max(1, int(self.seconds - (time.monotonic() - self._t0)) + 1)
        self._draw(p, f"HOLD {left}")
        self._job = self.after(30, self._tick)

    def end(self):
        if self._t0 is None:
            return
        self._t0 = None
        if self._job:
            self.after_cancel(self._job)
            self._job = None
        self._draw(0.0)
        if self.on_cancel:
            self.on_cancel()


class App:
    def __init__(self, root: tk.Tk, dry_run: bool, screen: tuple[int, int]):
        self.root = root
        self.screen = screen
        self.dry_run = dry_run
        self.events: queue.Queue = queue.Queue()
        self.recording = False
        self.busy = False
        self._preview_job = None
        self._preview_photo = None
        self._auto_date = today()

        self.show_date = tk.BooleanVar(value=config.DATE_DEFAULT_ON)
        self.show_qr = tk.BooleanVar(value=config.QR_DEFAULT_ON)
        self.date_text = tk.StringVar(value=self._auto_date)
        self.qr_text = tk.StringVar(value="")
        self.orientation = tk.StringVar(value=config.ORIENTATION)
        self.align = tk.StringVar(value=config.TEXT_ALIGN)
        self.icon_id = tk.StringVar(value="")
        self.icon_pos = tk.StringVar(value=config.ICON_POSITION)
        self.icon_size = tk.StringVar(value=config.ICON_SIZE)
        self._voice_search = False
        self.copies = tk.IntVar(value=1)

        self._build_ui()
        self._bind_keys()
        saved = self._load_settings()
        # Label size and the per-size position offsets (mm).
        self.label_size = saved.get("label_size") if saved.get("label_size") in labels.sizes() \
            else labels.default_key()
        labels.apply(self.label_size)
        self.offsets = {k: [float(v[0]), float(v[1])] for k, v in (saved.get("offsets") or {}).items()
                        if isinstance(v, (list, tuple)) and len(v) == 2}
        self._refresh_labels_panel()
        self.brightness = int(saved.get("brightness", 100))
        self.print_btn.seconds = float(saved.get("print_hold", config.PRINT_HOLD_SECONDS))
        if saved.get("align") in self.ALIGNS:
            self.align.set(saved["align"])
        if saved.get("icon_pos") in self.ICON_POSITIONS:
            self.icon_pos.set(saved["icon_pos"])
        if saved.get("icon_size") in self.ICON_SIZES:
            self.icon_size.set(saved["icon_size"])
        # Date and QR on/off and the QR text are remembered too.
        if "show_date" in saved:
            self.show_date.set(bool(saved["show_date"]))
        if "show_qr" in saved:
            self.show_qr.set(bool(saved["show_qr"]))
        if isinstance(saved.get("qr_text"), str):
            self.qr_text.set(saved["qr_text"])
        self.show_date.trace_add("write", lambda *_: self._save_settings(show_date=self.show_date.get()))
        self.show_qr.trace_add("write", lambda *_: self._save_settings(show_qr=self.show_qr.get()))
        self._refresh_align_buttons()
        self._refresh_place_buttons()
        self._display_power(True)     # in case an earlier run left it blanked
        self._apply_brightness()

        self.stt = PushToTalk(
            on_partial=lambda t: self.events.put(("partial", t)),
            on_final=lambda t: self.events.put(("final", t)),
            on_error=lambda m: self.events.put(("error", m)),
            on_progress=lambda f, _file: self.events.put(("progress", f)),
        )
        self.button = Button(
            config.TALK_BUTTON_PIN, config.TALK_LED_PIN,
            on_press=lambda: self.events.put(("hw_press", None)),
            on_release=lambda held: self.events.put(("hw_release", held)),
        )
        self.print_hw = Button(
            config.PRINT_BUTTON_PIN, config.PRINT_LED_PIN,
            on_press=lambda: self.events.put(("print_press", None)),
            on_release=lambda held: self.events.put(("print_release", held)),
        )

        self.set_status("Initializing…", MUTED)
        threading.Thread(target=self._load_model, daemon=True).start()
        self._network_at_start()

        for var in (self.show_date, self.show_qr, self.date_text, self.qr_text, self.orientation,
                    self.align, self.icon_id, self.icon_pos, self.icon_size):
            var.trace_add("write", lambda *_: self.schedule_preview())
        self.root.after(50, self._poll)
        self.schedule_preview()

        # Screen blanking: any touch, click or key counts as activity.
        self._last_activity = time.monotonic()
        self._blank_overlay = None
        self._talk_down_at = 0.0
        self._last_talk_tap = -10.0
        self._lp_jobs = []
        self._lp_origin = None
        self._lp_status = None
        self.root.bind_all("<ButtonPress>", lambda e: self._note_activity(), add="+")
        self.root.bind_all("<KeyPress>", lambda e: self._wake(), add="+")
        if config.SCREEN_BLANK_SECONDS:
            self.root.after(5000, self._check_idle)

    # ------------------------------------------------------------------ UI
    def _build_ui(self):
        """Main screen: Hold and speak (top left) and PRINT (top right) side by
        side at the same size; below them the label preview and status on the
        left, the text box and Rotate / Clear / Setup on the right. Date, QR,
        copies and brightness live on a separate Setup screen with big buttons.
        Sizes scale with the screen (800x480 on the 7" panel)."""
        r = self.root
        sw, sh = self.screen
        s = min(sw, sh) / 720          # 0.67 on 800x480
        self._s = s

        def font(pt, bold=False):
            size = max(9, round(pt * s))
            return ("DejaVu Sans", size, "bold") if bold else ("DejaVu Sans", size)
        self._font = font
        self._icon_cache = {}

        pad = max(6, round(14 * s))
        gap = max(4, round(9 * s))
        self._gap = gap
        r.configure(bg=BG)

        body = tk.Frame(r, bg=BG)
        body.pack(fill="both", expand=True, padx=pad, pady=pad)
        body.columnconfigure(0, weight=11, uniform="c")
        body.columnconfigure(1, weight=9, uniform="c")

        # Top row: the two main actions, same height and font.
        big = dict(font=font(30, True), relief="flat", bd=0, highlightthickness=0,
                   pady=round(30 * s), cursor="hand2")
        self.talk_btn = tk.Button(body, text=" Hold and speak", bg=PANEL, fg=FG,
                                  image=self.icon("mic", FG, 30), compound="left",
                                  activebackground=PANEL, activeforeground=FG, **big)
        self.talk_btn.grid(row=0, column=0, sticky="nsew", padx=(0, pad), pady=(0, gap))
        self.talk_btn.bind("<ButtonPress-1>", lambda e: self.talk_press())
        self.talk_btn.bind("<ButtonRelease-1>", lambda e: self.talk_release())
        self.print_btn = HoldButton(body, "PRINT", font(30, True), config.PRINT_HOLD_SECONDS,
                                    on_fire=self.print_label, on_start=self._print_hold_start,
                                    on_cancel=self._print_hold_cancel,
                                    icon=self.icon("printer", "#000000", 30))
        self.print_btn.grid(row=0, column=1, sticky="nsew", pady=(0, gap))

        # Rows below the top buttons: captions, the two boxes (same height),
        # then the status message beside Rotate / Clear / Setup.
        body.rowconfigure(1, weight=0)
        body.rowconfigure(2, weight=1)
        cap_font, cap_bold = font(15), font(15, True)

        cap = tk.Frame(body, bg=BG)
        cap.grid(row=1, column=1, sticky="ew")
        tk.Label(cap, text="LABEL PREVIEW", bg=BG, fg=MUTED, font=cap_bold,
                 anchor="w").pack(side="left")
        # The label size, as a button: it opens the Labels screen (size, position, test print).
        self.size_caption = tk.Button(cap, text="", command=self.open_labels, font=cap_bold,
                                      relief="flat", bd=0, highlightthickness=0,
                                      padx=round(10 * s), pady=0, bg=PANEL, fg=FG,
                                      activebackground=PANEL, activeforeground=FG, cursor="hand2")
        self.size_caption.pack(side="right")
        tcap = tk.Frame(body, bg=BG)
        tcap.grid(row=1, column=0, sticky="ew", padx=(0, pad))
        tk.Label(tcap, text="TEXT", bg=BG, fg=MUTED, font=cap_bold,
                 anchor="w").pack(side="left")
        tk.Label(tcap, text="type here to edit", bg=BG, fg=MUTED, font=cap_font,
                 anchor="e").pack(side="right")

        # Right box: the label drawn on its backing paper.
        self.canvas = tk.Canvas(body, bg=LINER, width=1, height=1, highlightthickness=2,
                                highlightbackground=INPUT_EDGE)
        self.canvas.grid(row=2, column=1, sticky="nsew")
        self.canvas.bind("<Configure>", lambda e: self.schedule_preview())

        # Left box: a dark input, so it can't be mistaken for the white label.
        self.text = tk.Text(body, width=1, height=1, wrap="word", font=font(22),
                            bg=INPUT_BG, fg=FG, insertbackground=FG, insertwidth=3,
                            undo=True, relief="flat", padx=10, pady=8,
                            highlightthickness=2, highlightbackground=INPUT_EDGE,
                            highlightcolor=ACCENT, selectbackground=ACCENT,
                            selectforeground="#000000")
        self.text.grid(row=2, column=0, sticky="nsew", padx=(0, pad))
        self.text.bind("<<Modified>>", self._text_changed)
        self.placeholder = tk.Label(self.text, text="Hold and speak, or type the label text",
                                    bg=INPUT_BG, fg=MUTED, font=font(19), anchor="nw",
                                    justify="left", wraplength=1)
        self.placeholder.bind("<Button-1>", lambda e: self.text.focus_set())
        # Press and hold on either box turns the screen off.
        for w in (self.text, self.placeholder, self.canvas):
            w.bind("<ButtonPress-1>", self._long_press_start, add="+")
            w.bind("<B1-Motion>", self._long_press_move, add="+")
            w.bind("<ButtonRelease-1>", self._long_press_cancel, add="+")
        # Double tap on the text box or the preview clears the text and icon (touch taps land a few pixels
        # apart, so this is checked by hand rather than with <Double-Button-1>).
        self._last_tap = (0.0, 0, 0)
        self._history = []                        # (text, icon) states for "undo"
        self._icon_before = ""
        for w in (self.text, self.placeholder, self.canvas):
            w.bind("<ButtonPress-1>", self._tap_check, add="+")
        self.text.bind("<Double-Button-1>", lambda e: "break")   # no word select
        self.text.bind("<Configure>", lambda e: (
            self.placeholder.configure(wraplength=max(50, e.width - 30)),
            self.status.configure(wraplength=max(100, e.width - 4))))

        # Bottom row: status message (left), Rotate / Align / Icon / Help / Setup (right).
        self.status = tk.Label(body, text="", bg=BG, fg=FG, font=font(22, True),
                               anchor="w", justify="left")
        self.status.grid(row=3, column=0, sticky="ew", padx=(0, pad), pady=(gap, 0))
        row = tk.Frame(body, bg=BG)
        row.grid(row=3, column=1, sticky="ew", pady=(gap, 0))
        btn = dict(font=font(15, True), relief="flat", bd=0, highlightthickness=0,
                   pady=round(7 * s), bg=PANEL, fg=FG, activebackground=PANEL,
                   activeforeground=FG, cursor="hand2", compound="top")
        self._main_btns = {}
        for col, (key, label, ic, cmd) in enumerate([
                ("rotate", "Rotate", "rotate", self.toggle_orientation),
                ("align", "Align", "align-left", self.cycle_align),
                ("icon", "Icon", "image", self.open_icons),
                ("help", "Help", "help", self.open_help),
                ("setup", "Setup", "gear", self.open_setup)]):
            row.columnconfigure(col, weight=1, uniform="b")
            b = tk.Button(row, text=label, command=cmd, image=self.icon(ic, FG, 17), **btn)
            b.grid(row=0, column=col, sticky="nsew", padx=(0 if col == 0 else gap, 0))
            self._main_btns[key] = b

        self._build_setup()
        self._build_icons()
        self._build_place()
        self._build_help()
        self._build_labels()
        self.text.focus_set()

    # --------------------------------------------------------------- setup
    def _build_setup(self):
        """A full-window panel, hidden until Setup is tapped."""
        s, font, gap = self._s, self._font, self._gap
        pad = max(8, round(18 * s))
        p = tk.Frame(self.root, bg=BG)
        self.setup_panel = p
        p.columnconfigure(1, weight=1)
        for r_ in (1, 2, 4, 5, 6):              # button rows share the spare height
            p.rowconfigure(r_, weight=1, uniform="rows")

        big = dict(font=font(24, True), relief="flat", bd=0, highlightthickness=0,
                   pady=round(20 * s), cursor="hand2", bg=PANEL, fg=FG,
                   activebackground=PANEL, activeforeground=FG)
        label = dict(bg=BG, fg=MUTED, font=font(20, True), anchor="w")
        entry = dict(font=font(24), relief="flat")

        head = tk.Frame(p, bg=BG)
        head.grid(row=0, column=0, columnspan=2, sticky="w", padx=pad, pady=(pad, gap))
        tk.Label(head, text="Setup", bg=BG, fg=FG, font=font(30, True), anchor="w").pack(anchor="w")
        self.net_label = tk.Label(head, text="", bg=BG, fg=MUTED, font=font(15, True), anchor="w")
        self.net_label.pack(anchor="w")
        top = tk.Frame(p, bg=BG)
        top.grid(row=0, column=1, sticky="e", padx=pad, pady=(pad, gap))
        self.protect_label = tk.Label(head, text="", bg=BG, font=font(15, True), justify="left",
                                      anchor="w")
        self.protect_label.pack(anchor="w")
        tk.Button(top, text=" Network", command=self.open_network, image=self.icon("network", FG, 24),
                  compound="left", **dict(big, padx=round(16 * s))).pack(side="left", padx=(0, gap))
        tk.Button(top, text=" Power", command=self.open_power, image=self.icon("power", FG, 24),
                  compound="left", **dict(big, padx=round(16 * s))).pack(side="left", padx=(0, gap))
        tk.Button(top, text=" Done", command=self.close_setup, image=self.icon("check", "#000000", 24),
                  compound="left",
                  **dict(big, bg=ACCENT, fg="#000000", activebackground="#ffd36b",
                         activeforeground="#000000", padx=round(22 * s))).pack(side="left")

        # Date and QR: a big on/off button plus the text to print.
        self._toggles = {}
        for r_, (name, var, text_var) in enumerate(
                [("Date", self.show_date, self.date_text), ("QR", self.show_qr, self.qr_text)],
                start=1):
            t = tk.Checkbutton(p, text=name, variable=var, indicatoron=False,
                               offrelief="flat", selectcolor=OK, **big)
            t.grid(row=r_, column=0, sticky="nsew", padx=(pad, gap), pady=(0, gap))
            tk.Entry(p, textvariable=text_var, **entry).grid(
                row=r_, column=1, sticky="nsew", padx=(0, pad), pady=(0, gap))
            self._toggles[name] = (t, var)
            var.trace_add("write", lambda *_: self._refresh_toggles())
        tk.Label(p, text="QR text: leave blank to use the label text", bg=BG, fg=MUTED,
                 font=font(15), anchor="w").grid(row=3, column=1, sticky="w",
                                                 padx=(0, pad), pady=(0, gap))

        # Text alignment: Left / Center / Right, the current one highlighted.
        tk.Label(p, text=" Align", image=self.icon("align-left", MUTED, 20), compound="left",
                 **label).grid(row=4, column=0, sticky="w", padx=(pad, gap), pady=(0, gap))
        al = tk.Frame(p, bg=BG)
        al.grid(row=4, column=1, sticky="nsew", padx=(0, pad), pady=(0, gap))
        al.rowconfigure(0, weight=1)
        self._align_btns = {}
        for i, a in enumerate(self.ALIGNS):
            al.columnconfigure(i, weight=1, uniform="al")
            b = tk.Button(al, text=" " + a.capitalize(), compound="left",
                          command=lambda a=a: self.set_align(a), **big)
            b.grid(row=0, column=i, sticky="nsew", padx=(0 if i == 0 else gap, 0))
            self._align_btns[a] = b

        # Copies: − n +
        tk.Label(p, text=" Copies", image=self.icon("copies", MUTED, 20), compound="left",
                 **label).grid(row=5, column=0, sticky="w",
                                                padx=(pad, gap), pady=(0, gap))
        cp = tk.Frame(p, bg=BG)
        cp.grid(row=5, column=1, sticky="nsw", padx=(0, pad), pady=(0, gap))
        step = dict(big, padx=round(34 * s))
        tk.Button(cp, text="−", command=lambda: self._bump_copies(-1), **step).pack(side="left", fill="y")
        tk.Label(cp, textvariable=self.copies, bg=BG, fg=FG, width=3,
                 font=font(30, True)).pack(side="left")
        tk.Button(cp, text="+", command=lambda: self._bump_copies(1), **step).pack(side="left", fill="y")

        # Brightness: one button per level, the current one highlighted.
        tk.Label(p, text=" Brightness", image=self.icon("sun", MUTED, 20), compound="left",
                 **label).grid(row=6, column=0, sticky="w",
                                                    padx=(pad, gap), pady=(0, gap))
        br = tk.Frame(p, bg=BG)
        br.grid(row=6, column=1, sticky="nsew", padx=(0, pad), pady=(0, gap))
        br.rowconfigure(0, weight=1)
        self._bright_btns = {}
        for i, lv in enumerate(sorted(config.BRIGHTNESS_LEVELS) or [100]):
            br.columnconfigure(i, weight=1, uniform="br")
            b = tk.Button(br, text=f"{lv}%", command=lambda lv=lv: self.set_brightness(lv), **big)
            b.grid(row=0, column=i, sticky="nsew", padx=(0 if i == 0 else gap, 0))
            self._bright_btns[lv] = b
        # Print hold: how long PRINT must be held.
        p.rowconfigure(7, weight=1, uniform="rows")
        tk.Label(p, text=" Print hold", image=self.icon("timer", MUTED, 20), compound="left",
                 **label).grid(row=7, column=0, sticky="w",
                                                    padx=(pad, gap), pady=(0, gap))
        ph = tk.Frame(p, bg=BG)
        ph.grid(row=7, column=1, sticky="nsew", padx=(0, pad), pady=(0, gap))
        ph.rowconfigure(0, weight=1)
        self._hold_btns = {}
        for i, sec in enumerate(config.PRINT_HOLD_CHOICES):
            ph.columnconfigure(i, weight=1, uniform="ph")
            b = tk.Button(ph, text="Off" if sec == 0 else f"{sec:g} s",
                          command=lambda sec=sec: self.set_print_hold(sec), **big)
            b.grid(row=0, column=i, sticky="nsew", padx=(0 if i == 0 else gap, 0))
            self._hold_btns[sec] = b
        # Labels: the size loaded, opening the Labels screen (size, position, test print).
        p.rowconfigure(8, weight=1, uniform="rows")
        tk.Label(p, text=" Labels", image=self.icon("printer", MUTED, 20), compound="left",
                 **label).grid(row=8, column=0, sticky="w", padx=(pad, gap), pady=(0, pad))
        self.setup_labels_btn = tk.Button(p, text="", command=self.open_labels,
                                          image=self.icon("arrow-right", FG, 22), compound="right",
                                          **dict(big, padx=round(20 * s)))
        self.setup_labels_btn.grid(row=8, column=1, sticky="nsew", padx=(0, pad), pady=(0, pad))
        self._refresh_toggles()
        self._build_power(big, pad, gap, font)
        self._build_network(big, pad, gap, font)

    # ------------------------------------------------------------ icon search
    ICON_COLS, ICON_ROWS = 7, 3
    ICON_POSITIONS = ("left", "top", "right", "bottom")
    ICON_SIZES = ("small", "medium", "large")

    def _panel_button_style(self, pt=22):
        s, font = self._s, self._font
        return dict(font=font(pt, True), relief="flat", bd=0, highlightthickness=0,
                    pady=round(14 * s), padx=round(18 * s), cursor="hand2", bg=PANEL, fg=FG,
                    activebackground=PANEL, activeforeground=FG)

    # ------------------------------------------------------------ labels
    def _build_labels(self):
        """Label size, a position nudge for each size, and a calibration print."""
        s, font, gap = self._s, self._font, self._gap
        pad = max(8, round(16 * s))
        big = self._panel_button_style(22)
        p = tk.Frame(self.root, bg=BG)
        self.labels_panel = p
        p.columnconfigure(1, weight=1)
        head = tk.Frame(p, bg=BG)
        head.grid(row=0, column=0, columnspan=2, sticky="ew", padx=pad, pady=(pad, gap))
        tk.Label(head, text="Labels", bg=BG, fg=FG, font=font(28, True)).pack(side="left")
        tk.Button(head, text=" Done", command=self.close_labels, image=self.icon("check", "#000000", 22),
                  compound="left", **dict(big, bg=ACCENT, fg="#000000", activebackground="#ffd36b",
                                          activeforeground="#000000", pady=round(8 * s),
                                          padx=round(26 * s))).pack(side="right")
        lab = dict(bg=BG, fg=MUTED, font=font(18, True), anchor="w")

        # Size: one button per size in config.LABEL_SIZES.
        tk.Label(p, text="Size", **lab).grid(row=1, column=0, sticky="w", padx=(pad, gap), pady=(0, gap))
        sz = tk.Frame(p, bg=BG)
        sz.grid(row=1, column=1, sticky="nsew", padx=(0, pad), pady=(0, gap))
        sz.rowconfigure(0, weight=1)
        self._size_btns = {}
        for i, key in enumerate(labels.sizes()):
            sz.columnconfigure(i, weight=1, uniform="sz")
            b = tk.Button(sz, text=labels.name(key), command=lambda k=key: self.set_label_size(k), **big)
            b.grid(row=0, column=i, sticky="nsew", padx=(0 if i == 0 else gap, 0))
            self._size_btns[key] = b

        # Position: nudge the print across (left / right) and along (up / down).
        self.offset_title = tk.Label(p, text="Position", **lab)
        self.offset_title.grid(row=2, column=0, sticky="nw", padx=(pad, gap), pady=(0, gap))
        pos = tk.Frame(p, bg=BG)
        pos.grid(row=2, column=1, sticky="nsew", padx=(0, pad), pady=(0, gap))
        step = dict(big, padx=round(22 * s))
        self._offset_vals = []
        for r_, (axis, minus, plus, ic_m, ic_p) in enumerate(
                [(0, "Left", "Right", "arrow-left", "arrow-right"),
                 (1, "Up", "Down", "arrow-up", "arrow-down")]):
            pos.rowconfigure(r_, weight=1)
            tk.Button(pos, text=" " + minus, image=self.icon(ic_m, FG, 22), compound="left",
                      command=lambda a=axis: self.nudge_offset(a, -1), **step).grid(
                row=r_, column=0, sticky="nsew", pady=(0 if r_ == 0 else gap, 0))
            v = tk.Label(pos, text="", bg=BG, fg=FG, font=font(22, True), width=9)
            v.grid(row=r_, column=1, pady=(0 if r_ == 0 else gap, 0))
            self._offset_vals.append(v)
            tk.Button(pos, text=" " + plus, image=self.icon(ic_p, FG, 22), compound="left",
                      command=lambda a=axis: self.nudge_offset(a, 1), **step).grid(
                row=r_, column=2, sticky="nsew", pady=(0 if r_ == 0 else gap, 0))
        tk.Button(pos, text="Reset", command=self.reset_offset, **step).grid(
            row=0, column=3, rowspan=2, sticky="nsew", padx=(gap, 0))
        pos.columnconfigure(4, weight=1)

        # Measure the labels (after changing rolls) and print the calibration label.
        act = tk.Frame(p, bg=BG)
        act.grid(row=3, column=0, columnspan=2, sticky="nsew", padx=pad, pady=(0, gap))
        act.columnconfigure((0, 1), weight=1, uniform="act")
        act.rowconfigure(0, weight=1)
        tk.Button(act, text=" Measure labels", image=self.icon("timer", FG, 22), compound="left",
                  command=self.measure_labels, **big).grid(row=0, column=0, sticky="nsew", padx=(0, gap))
        tk.Button(act, text=" Print test label", image=self.icon("printer", FG, 22), compound="left",
                  command=self.print_test_label, **big).grid(row=0, column=1, sticky="nsew")
        self.labels_note = tk.Label(p, text="", bg=BG, fg=MUTED, font=font(15), anchor="w",
                                    justify="left", wraplength=1)
        self.labels_note.grid(row=4, column=0, columnspan=2, sticky="ew", padx=pad, pady=(0, pad))
        p.bind("<Configure>", lambda e: self.labels_note.configure(wraplength=max(200, e.width - 2 * pad)))
        for r_ in (1, 2, 3):
            p.rowconfigure(r_, weight=1)
        self._labels_hint = ("After loading a new roll: pick its size, tap Measure labels (the printer "
                             "feeds a few blank labels to learn their length), then Print test label. The "
                             "solid border should sit the same distance from every edge; if it doesn't, "
                             "move the print and test again. Each size keeps its own position.")

    def open_labels(self):
        self._refresh_labels_panel()
        self.labels_note.configure(text=self._labels_hint, fg=MUTED)
        self.labels_panel.place(relx=0, rely=0, relwidth=1, relheight=1)
        self.labels_panel.lift()

    def close_labels(self):
        self.labels_panel.place_forget()
        self.text.focus_set()

    def _refresh_labels_panel(self):
        if not hasattr(self, "_size_btns"):
            return
        for k, b in self._size_btns.items():
            on = k == self.label_size
            col = "#000000" if on else FG
            b.configure(bg=OK if on else PANEL, activebackground=OK if on else PANEL,
                        fg=col, activeforeground=col)
        dx, dy = self.offsets.get(self.label_size, [0.0, 0.0])
        if hasattr(self, "setup_labels_btn"):
            self.setup_labels_btn.configure(
                text=f"{labels.name(self.label_size)}   size, position, test print  ")
        self.offset_title.configure(text=f"Position\n{labels.name(self.label_size)}")
        self._offset_vals[0].configure(text=("centered" if dx == 0 else
                                             f"{abs(dx):.1f} mm {'right' if dx > 0 else 'left'}"))
        self._offset_vals[1].configure(text=("centered" if dy == 0 else
                                             f"{abs(dy):.1f} mm {'down' if dy > 0 else 'up'}"))

    def set_label_size(self, key):
        if key not in labels.sizes():
            return
        self.label_size = key
        labels.apply(key)
        self._save_settings(label_size=key)
        self._refresh_labels_panel()
        self.labels_note.configure(text=f"{labels.name(key)} labels. " + self._labels_hint, fg=MUTED)
        self.schedule_preview()

    def nudge_offset(self, axis, sign):
        cur = list(self.offsets.get(self.label_size, [0.0, 0.0]))
        step = float(getattr(config, "OFFSET_STEP_MM", 0.5))
        cur[axis] = round(max(-10.0, min(10.0, cur[axis] + sign * step)), 2)
        self.offsets[self.label_size] = cur
        self._save_settings(offsets=self.offsets)
        self._refresh_labels_panel()

    def reset_offset(self):
        self.offsets[self.label_size] = [0.0, 0.0]
        self._save_settings(offsets=self.offsets)
        self._refresh_labels_panel()

    def _labels_job(self, what, make_zpl):
        if self.busy:
            return
        self.busy = True
        self.labels_note.configure(text=f"{what}…", fg=MUTED)

        def work():
            try:
                msg = printer.send(make_zpl(), dry_run=self.dry_run)
                self.events.put(("labels_note", (f"{what}: {msg.lower()}", OK)))
            except Exception as e:  # noqa: BLE001
                self.events.put(("labels_note", (f"{what} failed: {e}", REC)))
        threading.Thread(target=work, daemon=True).start()

    def measure_labels(self):
        self._labels_job("Measuring labels", labels.measure_command)

    def print_test_label(self):
        key = self.label_size
        dx, dy = self.offsets.get(key, [0.0, 0.0])
        self._labels_job(f"Test label ({labels.name(key)})",
                         lambda: image_to_zpl(labels.test_label(key, dx, dy)))

    # ------------------------------------------------------------- help
    HELP_VOICE = [
        ("\u201cspace\u201d", "Adds a space. Say it between spelled words:\n"
                                "\u201cJ A N E space D O E\u201d gives Jane Doe"),
        ("\u201cstart over\u201d", "Clears all the text (anything said after it is kept)"),
        ("\u201cupper case\u201d", "Makes everything UPPER CASE"),
        ("\u201clower case\u201d", "Makes everything lower case"),
        ("\u201ctitle case\u201d", "Capitalizes Each Word"),
        ("\u201cundo\u201d", "Goes back to how it was before the last change"),
        ("\u201cchange \u2026 to \u2026\u201d", "Replaces one thing with another everywhere:\n"
                                                  "\u201cchange periods to dashes\u201d, \u201cchange red to blue\u201d"),
        ("\u201cremove \u2026\u201d", "Takes it out of the text: \u201cremove comma\u201d, \u201cremove dash\u201d,\n"
                                       "\u201cremove punctuation\u201d, or words: \u201cremove Doe\u201d"),
        ("Spelling", "Say the letters one by one: \u201cJ A N E\u201d gives Jane"),
    ]
    HELP_TOUCH = [
        ("Double-tap", "On the text or the label: clears the text and icon"),
        ("Tap Talk, then hold", "Starts over and listens again"),
        ("Hold text or label", "Turns the screen off (touch to wake)"),
        ("PRINT", "Hold to print. On other screens it means Done"),
    ]

    def _build_help(self):
        """Voice commands and touch shortcuts, from the Help button."""
        s, font, gap = self._s, self._font, self._gap
        pad = max(8, round(16 * s))
        p = tk.Frame(self.root, bg=BG)
        self.help_panel = p
        p.columnconfigure(1, weight=1)
        head = tk.Frame(p, bg=BG)
        head.grid(row=0, column=0, columnspan=2, sticky="ew", padx=pad, pady=(pad, 0))
        tk.Label(head, text="Help", bg=BG, fg=FG, font=font(28, True)).pack(side="left")
        tk.Button(head, text=" Done", command=self.close_help, image=self.icon("check", "#000000", 22),
                  compound="left", **dict(self._panel_button_style(20), bg=ACCENT, fg="#000000",
                                          activebackground="#ffd36b", activeforeground="#000000",
                                          pady=round(8 * s), padx=round(26 * s))).pack(side="right")
        r = 1
        for title, rows in (("Say these while holding Talk", self.HELP_VOICE),
                            ("Touch", self.HELP_TOUCH)):
            tk.Label(p, text=title.upper(), bg=BG, fg=MUTED, font=font(13, True), anchor="w").grid(
                row=r, column=0, columnspan=2, sticky="w", padx=pad, pady=(gap, 2))
            r += 1
            for key, desc in rows:
                tk.Label(p, text=key, bg=BG, fg=ACCENT, font=font(16, True), anchor="nw",
                         justify="left").grid(row=r, column=0, sticky="nw", padx=(pad, gap), pady=1)
                tk.Label(p, text=desc, bg=BG, fg=FG, font=font(16), anchor="nw",
                         justify="left").grid(row=r, column=1, sticky="nw", padx=(0, pad), pady=1)
                r += 1
        p.rowconfigure(r, weight=1)

    def open_help(self):
        self.help_panel.place(relx=0, rely=0, relwidth=1, relheight=1)
        self.help_panel.lift()

    def close_help(self):
        self.help_panel.place_forget()
        self.text.focus_set()

    def _build_icons(self):
        """Search screen: a search box, a grid of icons, page buttons."""
        s, font, gap = self._s, self._font, self._gap
        pad = max(8, round(14 * s))
        big = self._panel_button_style()
        p = tk.Frame(self.root, bg=BG)
        self.icons_panel = p
        self.icon_query = tk.StringVar()
        self._icon_results, self._icon_svgs = [], {}
        self._icon_mode, self._icon_pg, self._icon_gen = "saved", 0, 0
        self._forget_mode = False
        self._icon_photos = []

        head = tk.Frame(p, bg=BG)
        head.pack(fill="x", padx=pad, pady=(pad, gap // 2))
        self.icon_entry = tk.Entry(head, textvariable=self.icon_query, font=font(26), relief="flat",
                                   bg=INPUT_BG, fg=FG, insertbackground=FG, width=1,
                                   highlightthickness=2, highlightbackground=INPUT_EDGE,
                                   highlightcolor=ACCENT)
        self.icon_entry.pack(side="left", fill="both", expand=True, padx=(0, gap))
        self.icon_entry.bind("<Return>", lambda e: (self.icon_search(), "break")[1])
        self.icon_entry.bind("<Escape>", lambda e: (self.close_icons(), "break")[1])
        tk.Button(head, text=" Find", image=self.icon("search", FG, 22), compound="left",
                  command=self.icon_search, **big).pack(side="left", padx=(0, gap))
        self.saved_btn = tk.Button(head, text=" Saved", image=self.icon("bookmark", FG, 22),
                                   compound="left", command=self.show_saved_icons, **big)
        self.saved_btn.pack(side="left", padx=(0, gap))
        tk.Button(head, text=" Back", image=self.icon("back", FG, 22), compound="left",
                  command=self.close_icons, **big).pack(side="left")

        self.icons_status = tk.Label(p, text="", bg=BG, fg=MUTED, font=font(16, True),
                                     anchor="w", justify="left")
        self.icons_status.pack(fill="x", padx=pad)

        grid = tk.Frame(p, bg=BG)
        grid.pack(fill="both", expand=True, padx=pad, pady=(gap // 2, 0))
        self._blank_tile = ImageTk.PhotoImage(Image.new("RGB", (2, 2), BG))
        self._icon_tiles = []
        for r_ in range(self.ICON_ROWS):
            grid.rowconfigure(r_, weight=1, uniform="ir")
        for c_ in range(self.ICON_COLS):
            grid.columnconfigure(c_, weight=1, uniform="ic")
        for k in range(self.ICON_ROWS * self.ICON_COLS):
            b = tk.Button(grid, image=self._blank_tile, bg=BG, activebackground="#ffffff",
                          relief="flat", bd=0, highlightthickness=4, highlightbackground=BG,
                          width=1, height=1, cursor="hand2",
                          command=lambda k=k: self._icon_tile_tap(k))
            b.grid(row=k // self.ICON_COLS, column=k % self.ICON_COLS, sticky="nsew",
                   padx=(0 if k % self.ICON_COLS == 0 else gap, 0),
                   pady=(0 if k < self.ICON_COLS else gap, 0))
            self._icon_tiles.append(b)

        foot = tk.Frame(p, bg=BG)
        foot.pack(fill="x", padx=pad, pady=(gap, pad))
        self.icon_prev = tk.Button(foot, text=" Prev", image=self.icon("arrow-left", FG, 20),
                                   compound="left", command=lambda: self._icon_page(-1), **big)
        self.icon_prev.pack(side="left")
        self.icon_page_label = tk.Label(foot, text="", bg=BG, fg=MUTED, font=font(18, True))
        self.icon_page_label.pack(side="left", padx=gap)
        self.icon_next = tk.Button(foot, text="Next ", image=self.icon("arrow-right", FG, 20),
                                   compound="right", command=lambda: self._icon_page(1), **big)
        self.icon_next.pack(side="left")
        self.forget_btn = tk.Button(foot, text=" Remove saved", image=self.icon("trash", FG, 20),
                                    compound="left", command=self._toggle_forget, **big)
        self.no_icon_btn = tk.Button(foot, text=" No icon", image=self.icon("clear", FG, 20),
                                     compound="left", command=self.remove_icon, **big)

    def _icons_note(self, msg, color=MUTED):
        self.icons_status.configure(text=msg, fg=color)

    def _icons_hint(self):
        talk = "hold TALK and say it" if self.button.available else "press F1 and say it"
        return f"Type a word and tap Find, or {talk}"

    def open_icons(self, force_search=False):
        """Icon button: adjust the icon if there is one, otherwise pick one."""
        if self.icon_id.get() and not force_search:
            self.open_place()
            return
        self.close_place()
        self.icons_panel.place(relx=0, rely=0, relwidth=1, relheight=1)
        self.icons_panel.lift()
        self._forget_mode = False
        if self.icon_id.get():
            self.no_icon_btn.pack(side="right")
        else:
            self.no_icon_btn.pack_forget()
        if self._icon_mode == "search" and self._icon_results:
            self._render_icon_page()
            self._icons_note(f"{len(self._icon_results)} icons for “{self.icon_query.get()}”. "
                             "Tap one to put it on the label", MUTED)
        else:
            self.show_saved_icons()
        self.icon_entry.focus_set()

    def close_icons(self):
        if self.recording and self._voice_search:
            self.stop_recording(cancel=True)
        self.icons_panel.place_forget()
        self.text.focus_set()
        self.schedule_preview()

    def show_saved_icons(self):
        self._icon_gen += 1
        self._icon_mode, self._icon_pg = "saved", 0
        self._icon_results = iconlib.library()
        self._icon_svgs = {i: iconlib.local_svg(i) for i in self._icon_results}
        if self._icon_results:
            self.forget_btn.pack(side="right", padx=(self._gap, 0))
            self._icons_note("Saved icons: tap one to use it, or find a new one above", MUTED)
        else:
            self.forget_btn.pack_forget()
            self._icons_note("No saved icons yet. " + self._icons_hint(), MUTED)
        self._render_icon_page()

    def icon_search(self):
        q = " ".join(self.icon_query.get().split())
        if not q:
            self._icons_note(self._icons_hint(), ACCENT)
            return
        self._icon_gen += 1
        gen = self._icon_gen
        self._forget_mode = False
        self.forget_btn.pack_forget()
        self._last_icon_query = q
        self._icons_note(f"Searching for “{q}”…", MUTED)
        per = self.ICON_COLS * self.ICON_ROWS

        def work():
            try:
                ids = iconlib.search(q)
                svgs = iconlib.fetch_many(ids[:per])
                self.events.put(("icons_found", (gen, q, ids, svgs)))
            except iconlib.IconError as e:
                self.events.put(("icons_error", (gen, str(e))))
            except Exception as e:  # noqa: BLE001
                self.events.put(("icons_error", (gen, f"Search failed: {e}")))
        threading.Thread(target=work, daemon=True).start()

    def _icons_loaded(self, gen, q, ids, svgs):
        if gen != self._icon_gen:
            return
        self._icon_mode, self._icon_pg = "search", 0
        self._icon_results, self._icon_svgs = ids, dict(svgs)
        if ids:
            self._icons_note(f"{len(ids)} icons for “{q}”. Tap one to put it on the label", MUTED)
        else:
            self._icons_note(f"Nothing found for “{q}”. Try a simpler word", ACCENT)
        self._render_icon_page()

    def _icon_page(self, delta):
        per = self.ICON_COLS * self.ICON_ROWS
        pages = max(1, -(-len(self._icon_results) // per))
        self._icon_pg = max(0, min(pages - 1, self._icon_pg + delta))
        self._render_icon_page()
        ids = self._icon_results[self._icon_pg * per:(self._icon_pg + 1) * per]
        missing = [i for i in ids if not self._icon_svgs.get(i)]
        if missing:
            gen, pg = self._icon_gen, self._icon_pg

            def work():
                try:
                    self.events.put(("icons_page", (gen, pg, iconlib.fetch_many(missing))))
                except Exception as e:  # noqa: BLE001
                    self.events.put(("icons_error", (gen, f"Couldn't load icons: {e}")))
            threading.Thread(target=work, daemon=True).start()

    def _icons_page_loaded(self, gen, pg, svgs):
        if gen == self._icon_gen:
            self._icon_svgs.update(svgs)
            if pg == self._icon_pg:
                self._render_icon_page()

    def _render_icon_page(self):
        per = self.ICON_COLS * self.ICON_ROWS
        pages = max(1, -(-len(self._icon_results) // per))
        px = max(40, round(108 * self._s))
        self._icon_photos = []
        cur = self.icon_id.get()
        for k, b in enumerate(self._icon_tiles):
            idx = self._icon_pg * per + k
            iid = self._icon_results[idx] if idx < len(self._icon_results) else None
            svg = self._icon_svgs.get(iid) if iid else None
            pic = iconlib.thumb(iid, svg, px) if svg else None
            if pic is None:
                b.configure(image=self._blank_tile, bg=PANEL if iid else BG,
                            state="normal" if iid else "disabled", highlightbackground=BG)
                continue
            photo = ImageTk.PhotoImage(pic.convert("RGB"))
            self._icon_photos.append(photo)
            edge = REC if self._forget_mode else (ACCENT if iid == cur else BG)
            b.configure(image=photo, bg="#ffffff", state="normal", highlightbackground=edge)
        for w in (self.icon_prev, self.icon_page_label, self.icon_next):
            w.pack_forget()
        if pages > 1:                               # Prev  2 / 5  Next
            self.icon_prev.pack(side="left")
            self.icon_page_label.pack(side="left", padx=self._gap)
            self.icon_next.pack(side="left")
            self.icon_page_label.configure(text=f"{self._icon_pg + 1} / {pages}")
        self.icon_prev.configure(state="normal" if self._icon_pg > 0 else "disabled")
        self.icon_next.configure(state="normal" if self._icon_pg < pages - 1 else "disabled")

    def _toggle_forget(self):
        self._forget_mode = not self._forget_mode
        self.forget_btn.configure(bg=REC if self._forget_mode else PANEL,
                                  activebackground=REC if self._forget_mode else PANEL,
                                  text=" Done removing" if self._forget_mode else " Remove saved")
        self._icons_note("Tap icons to remove them from your saved icons" if self._forget_mode
                         else "Your saved icons. Tap one to use it", REC if self._forget_mode else MUTED)
        self._render_icon_page()

    def _icon_tile_tap(self, k):
        per = self.ICON_COLS * self.ICON_ROWS
        idx = self._icon_pg * per + k
        if idx >= len(self._icon_results):
            return
        iid = self._icon_results[idx]
        if self._forget_mode:
            iconlib.forget(iid)
            self._icon_results.remove(iid)
            if not self._icon_results:
                self._toggle_forget()
                self.show_saved_icons()
            else:
                self._icon_pg = min(self._icon_pg, (len(self._icon_results) - 1) // per)
                self._render_icon_page()
            return
        if not self._icon_svgs.get(iid):
            return                                  # still downloading
        if iid != self.icon_id.get():
            self._remember()
        self.icon_id.set(iid)
        threading.Thread(target=lambda: self._save_icon(iid), daemon=True).start()
        self.icons_panel.place_forget()
        self.open_place()

    def _save_icon(self, iid):
        try:
            iconlib.save(iid)
        except Exception:  # noqa: BLE001
            pass

    def remove_icon(self):
        if self.icon_id.get():
            self._remember()
        self.icon_id.set("")
        self.close_place()
        self.close_icons()

    # ------------------------------------------------------------ icon placement
    def _build_place(self):
        """Placement screen: the label in the middle with a button on each side
        to move the icon there, plus icon size."""
        s, font, gap = self._s, self._font, self._gap
        pad = max(8, round(14 * s))
        big = self._panel_button_style(20)
        p = tk.Frame(self.root, bg=BG)
        self.place_panel = p
        p.columnconfigure(1, weight=1)
        p.rowconfigure(1, weight=1)
        self.place_canvas = tk.Canvas(p, bg=LINER, highlightthickness=0, width=1, height=1)
        self.place_canvas.grid(row=1, column=1, sticky="nsew")
        self.place_canvas.bind("<Configure>", lambda e: self.schedule_preview())
        self._pos_btns = {}
        spots = {"top": (0, 1, "n"), "bottom": (2, 1, "s"), "left": (1, 0, "w"), "right": (1, 2, "e")}
        for pos, (r_, c_, side) in spots.items():
            vertical = pos in ("top", "bottom")
            b = tk.Button(p, text=pos.capitalize(), image=self.icon("arrow-" + {
                "top": "up", "bottom": "down", "left": "left", "right": "right"}[pos], FG, 22),
                compound="left" if vertical else "top",
                command=lambda pos=pos: self.set_icon_pos(pos), **big)
            b.grid(row=r_, column=c_, sticky="nsew",
                   padx=(pad if pos == "left" else (gap if pos == "right" else 0),
                         gap if pos == "left" else 0),
                   pady=(pad if pos == "top" else (gap if pos == "bottom" else 0),
                         gap if pos == "top" else (pad if pos == "bottom" else 0)))
            self._pos_btns[pos] = b
        side = tk.Frame(p, bg=BG)
        side.grid(row=0, column=3, rowspan=3, sticky="nsew", padx=(gap, pad), pady=pad)
        tk.Button(side, text=" Done", image=self.icon("check", "#000000", 22), compound="left",
                  command=self.close_place,
                  **dict(big, bg=ACCENT, fg="#000000", activebackground="#ffd36b",
                         activeforeground="#000000")).pack(fill="x")
        tk.Label(side, text="Icon size", bg=BG, fg=MUTED, font=font(16, True),
                 anchor="w").pack(fill="x", pady=(gap * 2, gap // 2))
        self._size_btns = {}
        for sz in self.ICON_SIZES:
            b = tk.Button(side, text=sz.capitalize(), command=lambda sz=sz: self.set_icon_size(sz),
                          **big)
            b.pack(fill="x", pady=(0, gap))
            self._size_btns[sz] = b
        tk.Button(side, text=" Remove", image=self.icon("trash", FG, 20), compound="left",
                  command=self.remove_icon, **big).pack(side="bottom", fill="x")
        tk.Button(side, text=" Change", image=self.icon("image", FG, 20), compound="left",
                  command=lambda: self.open_icons(force_search=True),
                  **big).pack(side="bottom", fill="x", pady=(0, gap))

    def open_place(self):
        if not self.icon_id.get():
            self.open_icons(force_search=True)
            return
        self.place_panel.place(relx=0, rely=0, relwidth=1, relheight=1)
        self.place_panel.lift()
        self._refresh_place_buttons()
        self.schedule_preview()

    def close_place(self):
        if hasattr(self, "place_panel"):
            self.place_panel.place_forget()
        self.text.focus_set()
        self.schedule_preview()

    def set_icon_pos(self, pos):
        if pos in self.ICON_POSITIONS:
            self.icon_pos.set(pos)
            self._save_settings(icon_pos=pos)
            self._refresh_place_buttons()

    def set_icon_size(self, size):
        if size in self.ICON_SIZES:
            self.icon_size.set(size)
            self._save_settings(icon_size=size)
            self._refresh_place_buttons()

    def _refresh_place_buttons(self):
        for group, cur in ((getattr(self, "_pos_btns", {}), self.icon_pos.get()),
                           (getattr(self, "_size_btns", {}), self.icon_size.get())):
            for key, b in group.items():
                on = key == cur
                col = "#000000" if on else FG
                b.configure(bg=OK if on else PANEL, activebackground=OK if on else PANEL,
                            fg=col, activeforeground=col)
                if group is getattr(self, "_pos_btns", None):
                    arrow = {"top": "up", "bottom": "down", "left": "left", "right": "right"}[key]
                    b.configure(image=self.icon("arrow-" + arrow, col, 22))

    def _draw_place_preview(self, img):
        c = self.place_canvas
        cw, ch = max(c.winfo_width(), 50), max(c.winfo_height(), 50)
        pad = 12
        scale = min((cw - 2 * pad) / img.width, (ch - 2 * pad) / img.height)
        w, h = max(1, int(img.width * scale)), max(1, int(img.height * scale))
        self._place_photo = ImageTk.PhotoImage(img.convert("L").resize((w, h), Image.LANCZOS))
        c.delete("all")
        c.create_image((cw - w) // 2, (ch - h) // 2, image=self._place_photo, anchor="nw")

    # ------------------------------------------------------------ power panel
    POWER_ACTIONS = {   # key: (label, armed label, note)
        "restart": ("Restart", "Tap again\nto restart", "Back in about a minute"),
        "shutdown": ("Shut down", "Tap again\nto shut down", "Switch back on to start"),
        "desktop": ("Desktop", "Tap again\nto exit", "The app icon brings it back"),
    }

    def _build_power(self, big, pad, gap, font):
        """Restart / Shut down / Exit to desktop, each needing a second tap."""
        p = tk.Frame(self.root, bg=BG)
        self.power_panel = p
        p.columnconfigure((0, 1, 2), weight=1, uniform="pw")
        p.rowconfigure(2, weight=1)
        tk.Label(p, text="Power", bg=BG, fg=FG, font=font(30, True), anchor="w").grid(
            row=0, column=0, columnspan=2, sticky="w", padx=pad, pady=(pad, gap))
        tk.Button(p, text=" Back", command=self.close_power, image=self.icon("back", "#000000", 24),
                  compound="left",
                  **dict(big, bg=ACCENT, fg="#000000", activebackground="#ffd36b",
                         activeforeground="#000000", padx=round(30 * self._s))).grid(
            row=0, column=2, sticky="e", padx=pad, pady=(pad, gap))
        self.power_note = tk.Label(p, text="", bg=BG, fg=MUTED, font=font(16, True), anchor="w",
                                   justify="left")
        self.power_note.grid(row=1, column=0, columnspan=3, sticky="w", padx=pad, pady=(0, gap))
        self._power_btns = {}
        accents = {"restart": ACCENT, "shutdown": REC, "desktop": MUTED}
        row = tk.Frame(p, bg=BG)                     # equal spacing, so all tiles match
        row.grid(row=2, column=0, columnspan=3, sticky="nsew", padx=pad - gap // 2, pady=(0, pad))
        row.rowconfigure(0, weight=1)
        for i, (key, (lab, _, note)) in enumerate(self.POWER_ACTIONS.items()):
            row.columnconfigure(i, weight=1, uniform="tile")
            ic = {"restart": "rotate", "shutdown": "power", "desktop": "monitor"}[key]
            t = PowerTile(row, key, lab, note, font(24, True), font(14),
                          lambda k=key: self._power_tap(k), accents[key],
                          icon=self.icon(ic, accents[key], 84),
                          icon_armed=self.icon(ic, "#ffffff", 84))
            t.grid(row=0, column=i, sticky="nsew", padx=gap // 2)
            self._power_btns[key] = t
        self._power_armed = None

    # ------------------------------------------------------------ network panel
    def _build_network(self, big, pad, gap, font):
        """Automatic (DHCP) or a fixed IP address, with an on-screen number pad."""
        s = self._s
        p = tk.Frame(self.root, bg=BG)
        self.network_panel = p
        p.columnconfigure(0, weight=1)
        head = tk.Frame(p, bg=BG)
        head.grid(row=0, column=0, sticky="ew", padx=pad, pady=(pad, gap // 2))
        tk.Label(head, text="Network", bg=BG, fg=FG, font=font(30, True)).pack(side="left")
        tk.Button(head, text=" Back", command=self.close_network, image=self.icon("back", FG, 24),
                  compound="left", **dict(big, padx=round(24 * s))).pack(side="right")
        self.net_save_btn = tk.Button(
            head, text=" Save", command=self._network_save, image=self.icon("check", "#000000", 24),
            compound="left", **dict(big, bg=ACCENT, fg="#000000", activebackground="#ffd36b",
                                    activeforeground="#000000", padx=round(28 * s)))
        self.net_save_btn.pack(side="right", padx=(0, gap))
        self.net_status = tk.Label(p, text="", bg=BG, fg=MUTED, font=font(15, True), anchor="w",
                                   justify="left")
        self.net_status.grid(row=1, column=0, sticky="ew", padx=pad)

        body = tk.Frame(p, bg=BG)
        body.grid(row=2, column=0, sticky="nsew", padx=pad, pady=(gap // 2, pad))
        p.rowconfigure(2, weight=1)
        body.columnconfigure(0, weight=3, uniform="nb")
        body.columnconfigure(1, weight=2, uniform="nb")
        body.rowconfigure(0, weight=1)

        left = tk.Frame(body, bg=BG)
        left.grid(row=0, column=0, sticky="nsew", padx=(0, gap))
        left.columnconfigure(1, weight=1)
        modes = tk.Frame(left, bg=BG)
        modes.grid(row=0, column=0, columnspan=2, sticky="ew", pady=(0, gap))
        modes.columnconfigure((0, 1), weight=1, uniform="nm")
        self.net_mode = tk.StringVar(value="dhcp")
        self._net_mode_btns = {}
        for i, (key, lab) in enumerate((("dhcp", "Automatic"), ("static", "Fixed address"))):
            b = tk.Button(modes, text=lab, command=lambda k=key: self._set_net_mode(k),
                          **dict(big, font=font(20, True), padx=4))
            b.grid(row=0, column=i, sticky="nsew", padx=(0 if i == 0 else gap, 0))
            self._net_mode_btns[key] = b
        self._net_entries = {}
        for r_, (key, lab) in enumerate((("ip", "IP address"), ("gateway", "Router"),
                                         ("dns", "DNS server")), start=1):
            left.rowconfigure(r_, weight=1)
            tk.Label(left, text=lab, bg=BG, fg=MUTED, font=font(17, True), anchor="w").grid(
                row=r_, column=0, sticky="w", padx=(0, gap))
            e = tk.Entry(left, font=font(24), relief="flat", width=1, justify="left",
                         bg=INPUT_BG, fg=FG, insertbackground=FG, disabledbackground=PANEL,
                         disabledforeground=MUTED, highlightthickness=2,
                         highlightbackground=INPUT_EDGE, highlightcolor=ACCENT)
            e.grid(row=r_, column=1, sticky="nsew", pady=(0, gap))
            e.bind("<FocusIn>", lambda ev, k=key: setattr(self, "_net_focus", k))
            e.bind("<Return>", lambda ev: (self._network_save(), "break")[1])
            self._net_entries[key] = e
        self._net_focus = "ip"
        self.net_hint = tk.Label(left, text="", bg=BG, fg=MUTED, font=font(14), anchor="w",
                                 justify="left")
        self.net_hint.grid(row=4, column=0, columnspan=2, sticky="ew")
        left.bind("<Configure>", lambda ev: self.net_hint.configure(wraplength=max(100, ev.width - 4)))

        pad_f = tk.Frame(body, bg=BG)                 # number pad
        pad_f.grid(row=0, column=1, sticky="nsew")
        keys = ["1", "2", "3", "4", "5", "6", "7", "8", "9", ".", "0", "back"]
        self._net_keys = []
        for i, k in enumerate(keys):
            r_, c_ = divmod(i, 3)
            pad_f.rowconfigure(r_, weight=1, uniform="kp")
            pad_f.columnconfigure(c_, weight=1, uniform="kp")
            kw = dict(big, font=font(24, True), padx=2, pady=2)
            if k == "back":
                b = tk.Button(pad_f, image=self.icon("backspace", FG, 22), command=self._net_backspace, **kw)
            else:
                b = tk.Button(pad_f, text=k, command=lambda k=k: self._net_type(k), **kw)
            b.grid(row=r_, column=c_, sticky="nsew", padx=(0 if c_ == 0 else gap // 2, 0),
                   pady=(0 if r_ == 0 else gap // 2, 0))
            self._net_keys.append(b)
        self._net_busy = False

    def open_network(self):
        self.network_panel.place(relx=0, rely=0, relwidth=1, relheight=1)
        self.network_panel.lift()
        saved = self._load_settings().get("network") or {}
        self.net_status.configure(text="Reading the network…", fg=MUTED)
        self._set_net_mode(saved.get("mode", "dhcp"), refresh_only=True)

        def work():
            try:
                st = network.status()
            except network.NetError as e:
                st = {"error": str(e)}
            self.events.put(("net_status", st))
        threading.Thread(target=work, daemon=True).start()

    def close_network(self):
        self.network_panel.place_forget()
        if hasattr(self, "net_label"):
            self.net_label.configure(text=self.network_text())

    def _net_status_text(self, st):
        if st.get("error"):
            return st["error"], REC
        if not st.get("connection"):
            return "Not connected to a network", ACCENT
        how = {"static": "fixed address", "dhcp": "automatic address"}.get(st.get("method"), st.get("method") or "")
        return (f"{st.get('type') or 'Network'} “{st['connection']}” · {st.get('ip') or 'no address'}"
                f" · {how}"), MUTED

    def _network_loaded(self, st):
        self._net_current = st
        text, color = self._net_status_text(st)
        self.net_status.configure(text=text, fg=color)
        saved = self._load_settings().get("network") or {}
        mode = saved.get("mode") or st.get("method") or "dhcp"
        vals = {"ip": saved.get("ip") or st.get("ip") or "",
                "gateway": saved.get("gateway") or st.get("gateway") or "",
                "dns": " ".join(saved.get("dns") or []) or (st.get("dns") or [st.get("gateway") or ""])[0] or ""}
        for k, e in self._net_entries.items():
            e.configure(state="normal")
            e.delete(0, "end")
            e.insert(0, vals[k])
        self._set_net_mode("static" if mode == "static" else "dhcp")

    def _set_net_mode(self, mode, refresh_only=False):
        self.net_mode.set(mode)
        for k, b in self._net_mode_btns.items():
            on = k == mode
            col = "#000000" if on else FG
            b.configure(bg=OK if on else PANEL, activebackground=OK if on else PANEL,
                        fg=col, activeforeground=col)
        fixed = mode == "static"
        for e in self._net_entries.values():
            e.configure(state="normal" if fixed else "disabled")
        for b in self._net_keys:
            b.configure(state="normal" if fixed else "disabled")
        if fixed and not refresh_only:
            e = self._net_entries.get(self._net_focus) or self._net_entries["ip"]
            e.focus_set()
            e.icursor("end")
        self.net_hint.configure(text=(
            "Pick an address your router doesn't hand out to other devices (outside its "
            "DHCP range), or reserve it in the router. The Pi uses it every time it starts."
            if fixed else
            "The router gives the Pi an address each time it connects. It can change "
            "after a restart; the Setup screen always shows the current one."))

    def _net_entry(self):
        return self._net_entries.get(self._net_focus) or self._net_entries["ip"]

    def _net_type(self, ch):
        e = self._net_entry()
        if str(e.cget("state")) != "normal":
            return
        e.insert("insert", ch)
        e.focus_set()

    def _net_backspace(self):
        e = self._net_entry()
        if str(e.cget("state")) != "normal":
            return
        i = e.index("insert")
        if i > 0:
            e.delete(i - 1)
        e.focus_set()

    def _network_save(self):
        if self._net_busy:
            return
        mode = self.net_mode.get()
        cur = getattr(self, "_net_current", {}) or {}
        if mode == "static":
            ip = self._net_entries["ip"].get().strip()
            gw = self._net_entries["gateway"].get().strip()
            dns = self._net_entries["dns"].get().replace(",", " ").split()
            problem = network.check_static(ip, gw, cur.get("prefix") or 24, dns)
            if problem:
                self.net_status.configure(text=problem, fg=REC)
                return
            choice = {"mode": "static", "ip": ip, "gateway": gw, "dns": dns or [gw],
                      "prefix": cur.get("prefix") or 24}
        else:
            choice = {"mode": "dhcp"}
        self._net_busy = True
        self.net_save_btn.configure(state="disabled")
        self.net_status.configure(
            text="Applying… the network drops for a few seconds while it reconnects", fg=ACCENT)

        def work():
            try:
                if choice["mode"] == "static":
                    st = network.apply("static", choice["ip"], choice["gateway"], choice["dns"],
                                       choice["prefix"])
                else:
                    st = network.apply("dhcp")
                self.events.put(("net_applied", (True, choice, st)))
            except network.NetError as e:
                self.events.put(("net_applied", (False, choice, str(e))))
            except Exception as e:  # noqa: BLE001
                self.events.put(("net_applied", (False, choice, f"Failed: {e}")))
        threading.Thread(target=work, daemon=True).start()

    def _network_applied(self, ok, choice, result):
        self._net_busy = False
        self.net_save_btn.configure(state="normal")
        if not ok:
            self.net_status.configure(text=result, fg=REC)
            return
        self._save_settings(network=choice)
        self._net_current = result
        text, _ = self._net_status_text(result)
        self.net_status.configure(text="Saved. " + text, fg=OK)
        if hasattr(self, "net_label"):
            self.net_label.configure(text=self.network_text())

    def _network_at_start(self):
        """Put the saved network choice back at start-up (needed with power-off
        protection on, which resets the system's own network files)."""
        saved = self._load_settings().get("network") or {}

        def work():
            note = network.ensure(saved)
            if note:
                self.events.put(("net_note", note))
            network.watch()
        threading.Thread(target=work, daemon=True).start()
        if not self.dry_run:
            printer.watch(on_change=lambda st, d: self.events.put(("printer_state", d)))

    def open_power(self):
        self._power_armed = None
        self._refresh_power_buttons()
        state = self.protection_state()
        self.power_note.configure(text={
            "on": "Safe to unplug at any time.",
            "pending": "Unplug protection starts after a restart.",
            "ending": "Unplug protection ends at the next restart.",
            "off": "Shut down before unplugging.",
        }[state], fg=OK if state == "on" else MUTED)
        self.power_panel.place(relx=0, rely=0, relwidth=1, relheight=1)
        self.power_panel.lift()

    def close_power(self):
        self._power_armed = None
        self.power_panel.place_forget()

    def _refresh_power_buttons(self):
        for key, t in self._power_btns.items():
            t.set_armed(self.POWER_ACTIONS[key][1] if key == self._power_armed else None)

    def _power_tap(self, key):
        """First tap arms the button for 4 s; a second tap does it."""
        if self._power_armed != key:
            self._power_armed = key
            self._refresh_power_buttons()
            token = object()
            self._power_token = token
            self.root.after(4000, lambda: (self._power_token is token and self._power_armed == key
                                           and (setattr(self, "_power_armed", None),
                                                self._refresh_power_buttons())))
            return
        self._power_armed = None
        self._refresh_power_buttons()
        if key == "desktop":
            self._exit_armed = True
            self.exit_to_desktop()
            return
        verb, msg = (("reboot", "Restarting…") if key == "restart"
                     else ("poweroff", "Shutting down… wait for the screen to go dark"))
        self.button.led_off()
        self.print_hw.led_off()
        try:
            subprocess.run(["sync"], timeout=20)
            r = subprocess.run(["systemctl", verb], capture_output=True, text=True, timeout=20)
            ok = r.returncode == 0
            err = r.stderr.strip()
        except Exception as e:  # noqa: BLE001
            ok, err = False, str(e)
        if ok:
            self.power_note.configure(text=msg, fg=ACCENT)
        else:
            if "authentication" in (err or "").lower():
                err = "not allowed yet. Run once: sudo bash ~/labelbox/kiosk/allow-power.sh"
            self.power_note.configure(text="Couldn't do that: " + (err or "systemctl failed")[:120], fg=REC)

    ALIGNS = ("left", "center", "right")

    def set_align(self, align: str):
        if align not in self.ALIGNS:
            return
        self.align.set(align)
        self._save_settings(align=align)
        self._refresh_align_buttons()

    def cycle_align(self):
        i = self.ALIGNS.index(self.align.get()) if self.align.get() in self.ALIGNS else 0
        self.set_align(self.ALIGNS[(i + 1) % len(self.ALIGNS)])

    def _refresh_align_buttons(self):
        cur = self.align.get()
        if hasattr(self, "_main_btns") and cur in self.ALIGNS:
            self._main_btns["align"].configure(image=self.icon("align-" + cur, FG, 17),
                                               text=cur.capitalize())
        for a, b in getattr(self, "_align_btns", {}).items():
            on = a == cur
            col = "#000000" if on else FG
            b.configure(image=self.icon("align-" + a, col, 24),
                        bg=OK if on else PANEL, activebackground=OK if on else PANEL,
                        fg=col, activeforeground=col)

    def set_print_hold(self, seconds):
        self.print_btn.seconds = float(seconds)
        self._save_settings(print_hold=float(seconds))
        self._refresh_hold_buttons()

    def _refresh_hold_buttons(self):
        cur = self.print_btn.seconds
        for sec, b in getattr(self, "_hold_btns", {}).items():
            on = abs(sec - cur) < 1e-6
            b.configure(bg=OK if on else PANEL, activebackground=OK if on else PANEL,
                        fg="#000000" if on else FG, activeforeground="#000000" if on else FG)

    def open_setup(self):
        self.setup_panel.place(relx=0, rely=0, relwidth=1, relheight=1)
        self.setup_panel.lift()
        self._refresh_brightness_buttons()
        self._refresh_hold_buttons()
        text, color = {
            "on": ("Safe to unplug", OK),
            "pending": ("Safe to unplug after a restart", MUTED),
            "ending": ("Unplug protection ends at restart", ACCENT),
            "off": ("Shut down before unplugging", MUTED),
        }[self.protection_state()]
        self.protect_label.configure(text=text, fg=color)
        self.net_label.configure(text=self.network_text())

    def exit_to_desktop(self):
        """First tap arms the button; a second tap within 4 s leaves the app."""
        if not getattr(self, "_exit_armed", False):
            self.open_setup()
            self.open_power()
            return
        self._exit_armed = False
        if os.environ.get("LABELBOX_KIOSK"):
            # Starting the desktop stops the kiosk service (they conflict).
            r = subprocess.run(["systemctl", "--no-block", "start", "lightdm.service"],
                               capture_output=True, text=True)
            if r.returncode != 0:
                self.close_power()
                self.close_setup()
                self.set_status("Couldn't start the desktop: "
                                + (r.stderr.strip() or "systemctl failed"), REC)
        else:
            self.root.destroy()                         # running on the desktop already

    def _quit_now(self):
        """Ctrl+Shift+Q: go straight to the desktop (or quit if already there)."""
        self._exit_armed = True
        self.exit_to_desktop()

    def close_setup(self):
        if hasattr(self, "power_panel"):
            self.close_power()
        if hasattr(self, "network_panel"):
            self.close_network()
        self.setup_panel.place_forget()
        qr = self.qr_text.get()
        if qr != self._load_settings().get("qr_text", ""):
            self._save_settings(qr_text=qr)               # saved once, not on every key
        self.text.focus_set()
        self.schedule_preview()

    def icon(self, name, color=FG, pt=24):
        """A PhotoImage icon sized to sit beside text of `pt` points."""
        px = max(18, round(pt * 2.0 * self._s))
        key = (name, color, px)
        if key not in self._icon_cache:
            self._icon_cache[key] = ImageTk.PhotoImage(icons.icon_image(name, px, color))
        return self._icon_cache[key]

    def _refresh_toggles(self):
        for name, (t, var) in self._toggles.items():
            on = var.get()
            ic = {"Date": "calendar", "QR": "qr"}.get(name, "check")
            t.configure(text=" " + name, image=self.icon(ic, "#000000" if on else FG, 24),
                        compound="left",
                        fg="#000000" if on else FG,
                        activeforeground="#000000" if on else FG,
                        activebackground=OK if on else PANEL)

    def _refresh_brightness_buttons(self):
        for lv, b in getattr(self, "_bright_btns", {}).items():
            on = lv == self.brightness
            b.configure(bg=OK if on else PANEL, activebackground=OK if on else PANEL,
                        fg="#000000" if on else FG, activeforeground="#000000" if on else FG)

    def _bump_copies(self, delta: int):
        try:
            n = int(self.copies.get())
        except (tk.TclError, ValueError):
            n = 1
        self.copies.set(max(1, min(50, n + delta)))

    def _bind_keys(self):
        keys = {
            "<F1>": lambda e: self.toggle_recording(),
            "<F2>": lambda e: self.show_date.set(not self.show_date.get()),
            "<F3>": lambda e: self.show_qr.set(not self.show_qr.get()),
            "<F4>": lambda e: self.toggle_orientation(),
            "<F5>": lambda e: self.cycle_align(),
            "<F6>": lambda e: self.open_icons(),
            "<Control-p>": lambda e: self.print_label(),
            "<Control-Return>": lambda e: self.print_label(),
            "<Escape>": lambda e: self._escape(),
            "<Control-Q>": lambda e: self._quit_now(),     # Ctrl+Shift+Q
        }
        for seq, fn in keys.items():
            # Bind on the text box too, and stop Tk's built-in text bindings.
            for w in (self.root, self.text):
                w.bind(seq, lambda e, fn=fn: (fn(e), "break")[1])

    def _open_menu(self):
        """The screen covering the main one, if any."""
        for name in ("labels_panel", "help_panel", "place_panel", "icons_panel", "setup_panel"):
            panel = getattr(self, name, None)
            if panel is not None and panel.winfo_ismapped():
                return name
        return None

    def _menu_ok(self):
        """The deck's PRINT button acts as Done / OK on the other screens."""
        menu = self._open_menu()
        if menu == "labels_panel":
            self.close_labels()
        elif menu == "help_panel":
            self.close_help()
        elif menu == "place_panel":
            self.close_place()
        elif menu == "icons_panel":
            q = " ".join(self.icon_query.get().split())
            if q and q != getattr(self, "_last_icon_query", None):
                self.icon_search()                 # typed a word: OK = Find
            else:
                self.close_icons()
        elif menu == "setup_panel":
            self.close_setup()                     # also closes the power tiles
        self.print_hw.led_flash(1)

    def _escape(self):
        if self.labels_panel.winfo_ismapped():
            self.close_labels()
        elif self.help_panel.winfo_ismapped():
            self.close_help()
        elif self.place_panel.winfo_ismapped():
            self.close_place()
        elif self.icons_panel.winfo_ismapped():
            self.close_icons()
        elif self.setup_panel.winfo_ismapped():
            self.close_setup()
        else:
            self.clear()

    def set_status(self, msg: str, color: str = FG):
        self.status.configure(text=msg, fg=color)

    # ------------------------------------------------------------- preview
    def _text_changed(self, _e=None):
        if self.text.edit_modified():
            self.text.edit_modified(False)
            self.schedule_preview()

    def current_spec(self) -> LabelSpec:
        return LabelSpec(
            text=self.text.get("1.0", "end-1c"),
            show_date=self.show_date.get(),
            date_text=self.date_text.get().strip(),
            show_qr=self.show_qr.get(),
            qr_data=self.qr_text.get().strip(),
            orientation=self.orientation.get(),
            align=self.align.get(),
            icon=self.icon_id.get(),
            icon_pos=self.icon_pos.get(),
            icon_size=self.icon_size.get(),
        )

    def schedule_preview(self):
        if self._preview_job:
            self.root.after_cancel(self._preview_job)
        self._preview_job = self.root.after(120, self.update_preview)

    def update_preview(self):
        self._preview_job = None
        try:
            img = render(self.current_spec())
        except Exception as e:  # noqa: BLE001
            self.set_status(f"Preview error: {e}", REC)
            return
        cw, ch = max(self.canvas.winfo_width(), 50), max(self.canvas.winfo_height(), 50)
        pad, gap = 14, 10
        scale = min((cw - 2 * pad - 2 * gap) / img.width, (ch - 2 * pad) / img.height)
        w, h = max(1, int(img.width * scale)), max(1, int(img.height * scale))
        shown = img.convert("L").resize((w, h), Image.LANCZOS)
        self._preview_photo = ImageTk.PhotoImage(shown)
        c = self.canvas
        c.delete("all")
        x0, y0 = (cw - w) // 2, (ch - h) // 2
        # Draw it as a label on a roll: the box is the backing paper, with the
        # neighbouring labels peeking in at the sides.
        for nx in (x0 - gap - w, x0 + w + gap):
            c.create_rectangle(nx, y0, nx + w, y0 + h, fill=LABEL_GHOST, outline="")
        c.create_image(x0, y0, image=self._preview_photo, anchor="nw")
        if self.place_panel.winfo_ismapped():
            self._draw_place_preview(img)
        cw_, ch_ = canvas_size(self.orientation.get())
        self.size_caption.configure(text=f"{cw_ / config.DPI:g} × {ch_ / config.DPI:g} in  \u25be")
        # Placeholder in the text box when it's empty.
        if self.text.get("1.0", "end-1c").strip():
            self.placeholder.place_forget()
        else:
            self.placeholder.place(x=12, y=10)

    # ----------------------------------------------------------- recording
    def talk_press(self):
        """TALK went down (screen or physical button). A tap followed quickly by
        a press and hold clears the text and starts over."""
        now = time.monotonic()
        fresh = now - self._last_talk_tap <= getattr(config, "DOUBLE_TAP_SECONDS", 0.6)
        self._talk_down_at = now
        self._last_talk_tap = -10.0
        self.start_recording(fresh=fresh)

    def talk_release(self):
        held = time.monotonic() - self._talk_down_at
        if held < config.MIN_TALK_SECONDS:
            self.stop_recording(cancel=True)        # a tap: too short to be speech
            self._last_talk_tap = time.monotonic()
        else:
            self.stop_recording()

    def toggle_recording(self):
        self.stop_recording() if self.recording else self.start_recording()

    def start_recording(self, fresh: bool = False):
        if self.recording or self.busy:
            return
        if not self.stt.ready:
            self.set_status("Speech model is still loading…", MUTED)
            return
        # Keep the date current unless someone typed their own.
        if self.date_text.get() == self._auto_date:
            self._auto_date = today()
            self.date_text.set(self._auto_date)
        if self.help_panel.winfo_ismapped():
            self.close_help()                      # talking from Help goes to the label
        self._voice_search = self.icons_panel.winfo_ismapped()
        if self._voice_search:
            self._query_before = self.icon_query.get()
            self._icons_note("Listening… say what the icon should show, then let go", REC)
        elif fresh:
            self._remember()                       # so "undo" can bring it back
            self._set_text("")                     # start over: nothing to go back to
        self._status_before = (self.status.cget("text"), self.status.cget("fg"))
        self.recording = True
        self._before_recording = self.text.get("1.0", "end-1c")
        self._icon_before = self.icon_id.get()
        self.stt.begin()
        self.button.led_on()
        self.talk_btn.configure(bg=REC, activebackground=REC, text=" Listening…")
        self.set_status("Cleared. Listening… release to finish" if fresh
                        else "Listening… release to finish", REC)

    def stop_recording(self, cancel: bool = False):
        if not self.recording:
            return
        self.recording = False
        self.talk_btn.configure(bg=PANEL, activebackground=PANEL, text=" Hold and speak")
        if cancel:
            self.stt.cancel()
            self.button.led_off()
            if self._voice_search:
                self.icon_query.set(getattr(self, "_query_before", ""))
                self._icons_note(self._icons_hint(), MUTED)
                self._voice_search = False
                return
            self._set_text(self._before_recording)
            # Put back the message from before the tap, not "Listening…".
            text, color = getattr(self, "_status_before", ("", FG))
            if not text or text.startswith(("Listening", "Cleared")):
                text, color = self._idle_hint(), FG
            self.set_status(text, color)
            return
        self.busy = True
        self.button.led_on()                       # stays on until the words are in
        self.set_status("Transcribing…", MUTED)
        self.stt.end()

    def _set_text(self, value: str):
        self.text.delete("1.0", "end")
        self.text.insert("1.0", value)
        self.text.mark_set("insert", "end-1c")
        self.schedule_preview()

    @staticmethod
    def _tidy(spoken: str) -> str:
        """Join spelled-out letters (J A N E -> Jane) and drop the period
        speech recognition puts at the end; labels don't want one."""
        spoken = spoken.strip()
        joiner = getattr(config, "SPELL_JOINER", "-")
        if joiner is not None:
            spoken = hyphenate_spelling(spoken, joiner, getattr(config, "SPELL_CASE", "name"))
        while spoken.endswith(".") and not spoken.endswith("..."):
            spoken = spoken[:-1].rstrip()
        return spoken

    def _merge(self, spoken: str) -> str:
        """What was heard, combined with the text from before the recording,
        with the spoken commands (space, start over, upper / lower / title
        case) carried out."""
        self._cmd_note = None
        self._undo_said = False
        if not getattr(config, "VOICE_COMMANDS", True):
            spoken = self._tidy(spoken)
            if config.RECORD_MODE == "append" and self._before_recording.strip():
                return f"{self._before_recording.rstrip()} {spoken}"
            return spoken
        text, case, cleared, only, removals, undo = voicecmd.parse(spoken.strip())
        if undo:                                     # "undo": show what it would go back to
            self._undo_said = True
            return self._history[-1][0] if self._history else self._before_recording
        new = voicecmd.finish(self._tidy(text))
        before = "" if cleared else self._before_recording.rstrip("\n")
        if cleared:
            result = new.lstrip()
        elif only:                                   # just commands: work on the text there
            result = before + new
        elif config.RECORD_MODE == "append" and before.strip():
            result = before.rstrip() + ("" if new.startswith(" ") else " ") + new
        else:
            result = new
        result = voicecmd.apply_case(voicecmd.apply_removals(result, removals), case)
        notes = {"upper": "Changed to UPPER CASE", "lower": "Changed to lower case",
                 "title": "Changed to Title Case"}
        if only:
            self._cmd_note = ("Cleared" if cleared and not case else
                              notes.get(case) or (("Changed" if any(r[0] == "replace" for r in removals)
                                                   else "Removed") if removals else None) or
                              ("Space added" if new else None))
        return result

    # ------------------------------------------------------------ printing
    def _print_hold_start(self):
        """Called when PRINT is pressed. Return False to refuse the hold."""
        self._note_activity()
        if self.recording or self.busy:
            return False
        spec = self.current_spec()
        if not (spec.text.strip() or spec.show_qr or spec.show_date):
            self.set_status("Nothing to print yet", MUTED)
            return False
        self.print_hw.led_blink(fast=True)
        self.set_status("Keep holding to print…", ACCENT)
        return True

    def _print_hold_cancel(self):
        self.print_hw.led_off()
        self.set_status(f"Hold PRINT for {self.print_btn.seconds:g} seconds to print", MUTED)

    def print_label(self):
        if self.recording or self.busy:
            return
        spec = self.current_spec()
        if not (spec.text.strip() or spec.show_qr or spec.show_date):
            self.set_status("Nothing to print yet", MUTED)
            return
        try:
            copies = max(1, min(50, int(self.copies.get())))
        except (tk.TclError, ValueError):
            copies = 1
        self.busy = True
        self.print_hw.led_on()                     # stays on until the label is sent
        self.set_status("Printing…", MUTED)

        def work():
            try:
                img = render(spec)
                dx, dy = self.offsets.get(self.label_size, [0.0, 0.0])
                zpl = image_to_zpl(labels.shift(for_printer(img, spec.orientation), dx, dy), copies=copies)
                msg = printer.send(zpl, dry_run=self.dry_run, preview_png=img)
                self.events.put(("printed", f"{msg} ({copies} cop{'y' if copies == 1 else 'ies'})"))
            except Exception as e:  # noqa: BLE001
                self.events.put(("print_error", str(e)))

        threading.Thread(target=work, daemon=True).start()

    # ------------------------------------------------------- screen blanking
    def _note_activity(self):
        self._last_activity = time.monotonic()

    def _display_power(self, on: bool):
        try:
            subprocess.run(["wlopm", "--on" if on else "--off", "*"],
                           timeout=5, capture_output=True)
        except Exception:  # noqa: BLE001 - not on a Wayland desktop
            pass

    # ------------------------------------------------------------ brightness
    SETTINGS_FILE = Path(__file__).with_name("settings.json")

    @staticmethod
    def _backlights() -> list:
        return sorted(glob.glob("/sys/class/backlight/*"))

    # With power-off protection on (kiosk/protect.sh), the main storage is
    # read-only and anything written to it is lost at restart, so settings are
    # also kept on the boot partition through a small root helper.
    BOOT_SETTINGS = Path("/boot/firmware/voicelabels-settings.json")
    SAVE_HELPER = "/usr/local/sbin/voicelabels-save-settings"

    def _load_settings(self) -> dict:
        for f in (self.BOOT_SETTINGS, self.SETTINGS_FILE):
            try:
                data = json.loads(f.read_text())
                if isinstance(data, dict):
                    return data
            except (OSError, ValueError):
                continue
        return {}

    def _save_settings(self, **changes):
        data = self._load_settings()
        data.update(changes)
        text = json.dumps(data, indent=2)
        tmp = self.SETTINGS_FILE.with_suffix(".tmp")
        try:                                   # write, flush to disk, then swap in
            with open(tmp, "w") as fh:
                fh.write(text)
                fh.flush()
                os.fsync(fh.fileno())
            os.replace(tmp, self.SETTINGS_FILE)
        except OSError:
            pass
        if os.path.exists(self.SAVE_HELPER):
            try:
                subprocess.run(["sudo", "-n", self.SAVE_HELPER], input=text.encode(),
                               timeout=10, capture_output=True)
            except Exception:  # noqa: BLE001
                pass

    @staticmethod
    def network_text() -> str:
        """'labelbox · 192.168.1.20', or a note when there's no network."""
        import socket
        host = socket.gethostname()
        ip = None
        try:                       # the address used to reach the network (sends nothing)
            with socket.socket(socket.AF_INET, socket.SOCK_DGRAM) as sk:
                sk.connect(("192.0.2.1", 9))
                ip = sk.getsockname()[0]
        except OSError:
            pass
        if not ip or ip.startswith("127."):
            try:
                ips = subprocess.run(["hostname", "-I"], capture_output=True, text=True,
                                     timeout=3).stdout.split()
                ip = next((a for a in ips if "." in a and not a.startswith("127.")), None)
            except Exception:  # noqa: BLE001
                ip = None
        return f"{host} · {ip}" if ip else f"{host} · no network"

    @staticmethod
    def protection_state() -> str:
        """'on' (safe to unplug), 'pending' (on after a restart), or 'off'."""
        try:
            now = "overlayroot=tmpfs" in Path("/proc/cmdline").read_text()
            conf = "overlayroot=tmpfs" in Path("/boot/firmware/cmdline.txt").read_text()
        except OSError:
            return "off"
        if now:
            return "on" if conf else "ending"
        return "pending" if conf else "off"

    def _apply_brightness(self):
        pct = max(1, min(100, int(self.brightness)))
        for dev in self._backlights():
            try:
                top = int(Path(dev, "max_brightness").read_text())
                Path(dev, "brightness").write_text(str(max(1, round(top * pct / 100))))
            except (OSError, ValueError):
                pass
        self._refresh_brightness_buttons()

    def set_brightness(self, level: int):
        self.brightness = int(level)
        self._apply_brightness()
        self._save_settings(brightness=self.brightness)

    def _check_idle(self):
        idle = time.monotonic() - self._last_activity
        if (self._blank_overlay is None and not self.recording and not self.busy
                and idle >= config.SCREEN_BLANK_SECONDS):
            self._blank()
        self.root.after(5000, self._check_idle)

    def _blank(self):
        # A black cover over the whole window catches the waking touch, so it
        # can't also press whatever button is underneath.
        cover = tk.Frame(self.root, bg="#000000", cursor="none")
        cover.place(relx=0, rely=0, relwidth=1, relheight=1)
        cover.lift()
        cover.bind("<ButtonPress>", lambda e: (self._wake(), "break")[1])
        self._blank_overlay = cover
        self._display_power(False)

    def _long_press_start(self, e):
        self._long_press_cancel()
        secs = getattr(config, "LONG_PRESS_BLANK_SECONDS", 0)
        if not secs or self.recording or self.busy:
            return
        self._lp_origin = (e.x_root, e.y_root)
        self._lp_status = (self.status.cget("text"), self.status.cget("fg"))
        self._lp_jobs = [
            self.root.after(int(min(0.6, secs / 2) * 1000),
                            lambda: self.set_status("Keep holding to turn the screen off", MUTED)),
            self.root.after(int(secs * 1000), self._long_press_fire),
        ]

    def _long_press_move(self, e):
        # Dragging (e.g. selecting text) is not a long press.
        if self._lp_origin and (abs(e.x_root - self._lp_origin[0]) > 15
                                or abs(e.y_root - self._lp_origin[1]) > 15):
            self._long_press_cancel()

    def _long_press_cancel(self, _e=None):
        jobs, self._lp_jobs = self._lp_jobs, []
        for job in jobs:
            self.root.after_cancel(job)
        if jobs and self._lp_status:
            self.set_status(*self._lp_status)       # put back the message it replaced
        self._lp_origin = self._lp_status = None

    def _long_press_fire(self):
        self._lp_jobs = []
        if self._lp_status:
            self.set_status(*self._lp_status)
        self._lp_origin = self._lp_status = None
        if self._blank_overlay is None and not self.recording and not self.busy:
            self._blank()

    def _wake(self):
        self._note_activity()
        if self._blank_overlay is not None:
            self._display_power(True)
            # The panel can come back at full brightness; put back the level
            # it had, now and again shortly after in case the driver resets it.
            self._apply_brightness()
            self.root.after(400, self._apply_brightness)
            self.root.after(1500, self._apply_brightness)
            self._blank_overlay.destroy()
            self._blank_overlay = None

    # --------------------------------------------------------------- misc
    def toggle_orientation(self):
        self.orientation.set("portrait" if self.orientation.get() == "landscape" else "landscape")

    def _tap_check(self, e):
        now = time.monotonic()
        t, x, y = self._last_tap
        if now - t < 0.4 and abs(e.x_root - x) < 40 and abs(e.y_root - y) < 40:
            self._last_tap = (0.0, 0, 0)
            self._long_press_cancel()
            if not self.recording and not self.busy and (self.text.get("1.0", "end-1c")
                                                          or self.icon_id.get()):
                self._remember()
                self._set_text("")
                self.icon_id.set("")
                self.set_status("Cleared", MUTED)
            return "break"
        self._last_tap = (now, e.x_root, e.y_root)
        return None

    def _remember(self, text=None, icon=None):
        """Keep the text and icon so "undo" can put them back."""
        state = (self.text.get("1.0", "end-1c") if text is None else text,
                 self.icon_id.get() if icon is None else icon)
        if not self._history or self._history[-1] != state:
            self._history.append(state)
            del self._history[:-30]

    def undo(self):
        if not self._history:
            self.set_status("Nothing to undo", MUTED)
            return
        text, icon = self._history.pop()
        self._set_text(text)
        self.icon_id.set(icon)
        self.set_status("Undone", OK)

    def clear(self):
        if self.recording:
            self.stop_recording(cancel=True)
        if self.text.get("1.0", "end-1c") or self.icon_id.get():
            self._remember()
        self._set_text("")
        self.icon_id.set("")
        self.set_status("Hold the button and speak", FG)

    def _load_model(self):
        self.stt.load()
        if self.stt.ready:
            self.events.put(("ready", None))

    def _poll(self):
        try:
            while True:
                kind, val = self.events.get_nowait()
                self._handle(kind, val)
        except queue.Empty:
            pass
        self.root.after(50, self._poll)

    def _idle_hint(self) -> str:
        return ("Hold the button and speak" if self.button.available
                else "Hold the Talk button (or press F1) and speak")

    def _handle(self, kind, val):
        if kind == "ready":
            self.button.led_flash(2)                   # ready
            hint = "Hold the button and speak" if self.button.available else "Hold the Talk button (or press F1) and speak"
            if not self.stt.mic_name:
                self.set_status("Microphone not found. Plug in the USB mic.", REC)
                return
            self.set_status(hint, FG)
        elif kind == "progress":
            self.set_status(f"Initializing… {val:.0%}", MUTED)
        elif kind == "partial" and self.recording and self._voice_search:
            self.icon_query.set(self._tidy(val))
        elif kind == "partial" and self.recording:
            self._set_text(self._merge(val))
        elif kind == "final" and self._voice_search:
            self.busy = False
            self._voice_search = False
            words = self._tidy(val or "").rstrip("?!")
            if words:
                self.button.led_flash(2)
                self.icon_query.set(words)
                self.icon_search()
            else:
                self.button.led_off()
                self.icon_query.set(getattr(self, "_query_before", ""))
                self._icons_note("Didn't catch that. Try again", ACCENT)
        elif kind == "net_status":
            self._network_loaded(val)
        elif kind == "net_applied":
            self._network_applied(*val)
        elif kind == "printer_state":
            if val not in ("ready", "no answer") and not self.recording and not self.busy:
                self.set_status(f"Printer: {val}", ACCENT)
            elif val == "ready" and self.status.cget("text").startswith("Printer:"):
                self.set_status(self._idle_hint(), FG)
        elif kind == "labels_note":
            self.busy = False
            self.labels_note.configure(text=val[0], fg=val[1])
        elif kind == "net_note":
            self.set_status(val, ACCENT if "not applied" in val else MUTED)
        elif kind == "icons_found":
            self._icons_loaded(*val)
        elif kind == "icons_page":
            self._icons_page_loaded(*val)
        elif kind == "icons_error":
            if val[0] == self._icon_gen:
                self._icons_note(val[1], ACCENT)
        elif kind == "icons_saved":
            pass
        elif kind == "final":
            self.busy = False
            if val:
                self.button.led_flash(2)               # done
                result = self._merge(val)
                if self._undo_said:
                    self._set_text(self._before_recording)
                    self.undo()
                else:
                    if result != self._before_recording or False:
                        self._remember(self._before_recording, self._icon_before)
                    self._set_text(result)
                    self.set_status(getattr(self, "_cmd_note", None) or "Edit if needed, then print", OK)
            else:
                self.button.led_off()
                self._set_text(self._before_recording)
                self.set_status("Didn't catch that. Try again", ACCENT)
        elif kind == "hw_press":
            self._wake()
            self.talk_press()
        elif kind == "hw_release":
            self._note_activity()
            self.talk_release()
        elif kind == "print_press":
            was_dark = self._blank_overlay is not None
            self._wake()
            if self._open_menu():
                # In a menu, the green button is OK / Done. If the screen was
                # dark, the press only wakes it so you can see where you are.
                self._print_as_ok = True
                if not was_dark:
                    self._menu_ok()
            else:
                self.print_btn.begin()
        elif kind == "print_release":
            self._note_activity()
            if getattr(self, "_print_as_ok", False):
                self._print_as_ok = False
            else:
                self.print_btn.end()
        elif kind == "printed":
            self.busy = False
            self.print_hw.led_flash(2)                 # done
            self.set_status(val, OK)
        elif kind == "print_error":
            self.busy = False
            self.button.led_off()
            self.print_hw.led_off()
            self.set_status(val, REC)
        elif kind == "error":
            self.busy = False
            self.recording = False
            self.button.led_off()
            self.set_status(val, REC)


def main():
    ap = argparse.ArgumentParser(description=__doc__, formatter_class=argparse.RawDescriptionHelpFormatter)
    ap.add_argument("--dry-run", action="store_true", help="save labels to ./out instead of printing")
    ap.add_argument("--windowed", action="store_true", help="don't go fullscreen")
    ap.add_argument("--size", default="800x480",
                    help="window size with --windowed, e.g. 800x480 or 720x1280")
    args = ap.parse_args()

    root = tk.Tk()
    root.title("Voice Labels")

    def repaint():
        # Cover the whole window for a moment and take the cover away, so
        # every widget is drawn again. After a resize, Xwayland can keep
        # showing old pixels at the bottom (cut-off buttons) even though
        # the layout itself is right.
        try:
            cover = tk.Frame(root, bg=BG)
            cover.place(x=0, y=0, relwidth=1, relheight=1)
            cover.lift()
            root.update_idletasks()
            root.after(60, cover.destroy)
        except tk.TclError:
            pass

    if config.FULLSCREEN and not args.windowed:
        screen = (root.winfo_screenwidth(), root.winfo_screenheight())
        root.geometry(f"{screen[0]}x{screen[1]}+0+0")
        root.attributes("-fullscreen", True)
        root.configure(cursor="none")

        # The window manager sometimes ignores the first fullscreen request, or
        # gives the window a title bar that pushes it down so the bottom row of
        # buttons is cut off. Keep checking that the window fills the screen
        # exactly (size AND position) and ask again whenever it doesn't: often
        # just after start, then every few seconds for as long as the app runs.
        def fills_screen():
            root.update_idletasks()
            if not (root.winfo_rootx() == 0 and root.winfo_rooty() == 0 and
                    abs(root.winfo_width() - screen[0]) <= 1 and
                    abs(root.winfo_height() - screen[1]) <= 1):
                return False
            # The bottom-row buttons must end inside the screen too.
            try:
                b = app._main_btns["setup"]
                if b.winfo_ismapped() and b.winfo_rooty() + b.winfo_height() > screen[1]:
                    if fixes["n"] >= 3:
                        return False
                    print(f"bottom buttons end at {b.winfo_rooty() + b.winfo_height()}, "
                          f"below the screen", flush=True)
                    open("/tmp/labelbox-dump", "w").close()   # log the layout once
                    return False
            except (NameError, AttributeError, KeyError, tk.TclError, OSError):
                pass
            return True

        def refullscreen():
            root.attributes("-fullscreen", False)
            root.geometry(f"{screen[0]}x{screen[1]}+0+0")
            root.after(80, lambda: (root.attributes("-fullscreen", True),
                                    root.lift(), root.focus_force()))
            for ms in (400, 1200, 3000):
                root.after(ms, repaint)

        fixes = {"n": 0}

        def ensure_fullscreen(tries):
            if not root.winfo_ismapped():
                root.after(300, ensure_fullscreen, tries)
                return
            if not fills_screen():
                fixes["n"] += 1
                if fixes["n"] <= 3 or fixes["n"] % 10 == 0:
                    print(f"window at {root.winfo_rootx()},{root.winfo_rooty()} "
                          f"{root.winfo_width()}x{root.winfo_height()}: making it fullscreen again",
                          flush=True)
                refullscreen()
            root.after(700 if tries > 0 else 4000, ensure_fullscreen, max(0, tries - 1))
        root.after(500, ensure_fullscreen, 12)
    else:
        w, h = (int(v) for v in args.size.lower().split("x"))
        screen = (w, h)
        root.geometry(f"{w}x{h}")
    app = App(root, dry_run=args.dry_run, screen=screen)

    def geometry_dump():
        # Debugging aid: `touch /tmp/labelbox-dump` writes every widget's place
        # and size to the log.
        if os.path.exists("/tmp/labelbox-dump"):
            try:
                os.remove("/tmp/labelbox-dump")
            except OSError:
                pass

            def walk(w, depth=0):
                if w.winfo_ismapped():
                    print(f"geom {'  ' * depth}{w.winfo_class()} {w.winfo_name()} "
                          f"{w.winfo_x()},{w.winfo_y()} {w.winfo_width()}x{w.winfo_height()} "
                          f"req {w.winfo_reqwidth()}x{w.winfo_reqheight()}", flush=True)
                    for c in w.winfo_children():
                        walk(c, depth + 1)
            print(f"geom root at {root.winfo_rootx()},{root.winfo_rooty()} "
                  f"screen {root.winfo_screenwidth()}x{root.winfo_screenheight()}", flush=True)
            walk(root)
        if os.path.exists("/tmp/labelbox-unfull"):      # test: knock it out of fullscreen
            try:
                os.remove("/tmp/labelbox-unfull")
            except OSError:
                pass
            root.attributes("-fullscreen", False)
            root.geometry("800x418+0+62")
        if os.path.exists("/tmp/labelbox-repaint"):     # `touch` it to redraw the screen
            try:
                os.remove("/tmp/labelbox-repaint")
            except OSError:
                pass
            repaint()
        root.after(2000, geometry_dump)
    root.after(2000, geometry_dump)
    if os.environ.get("LABELBOX_SHOW_SETUP"):      # for screenshots while testing
        root.after(300, app.open_setup)
    if os.environ.get("LABELBOX_SHOW_NETWORK"):
        root.after(400, lambda: (app.open_setup(), app.open_network()))
    if os.environ.get("LABELBOX_SHOW_LABELS"):
        root.after(400, app.open_labels)
    if os.environ.get("LABELBOX_SHOW_HELP"):
        root.after(400, app.open_help)
    if os.environ.get("LABELBOX_SHOW_POWER"):
        root.after(400, lambda: (app.open_setup(), app.open_power()))
    if os.environ.get("LABELBOX_ICON"):            # pre-chosen icon, for screenshots
        root.after(350, lambda: app.icon_id.set(os.environ["LABELBOX_ICON"]))
    if os.environ.get("LABELBOX_SHOW_ICONS"):
        q = os.environ["LABELBOX_SHOW_ICONS"]
        root.after(500, lambda: (app.open_icons(force_search=True),
                                 q != "1" and (app.icon_query.set(q), app.icon_search())))
    if os.environ.get("LABELBOX_SHOW_PLACE"):
        root.after(600, app.open_place)
    if os.environ.get("LABELBOX_TEXT"):            # pre-filled label, for screenshots
        root.after(300, lambda: app._set_text(os.environ["LABELBOX_TEXT"]))
    try:
        root.mainloop()
    finally:
        app.stt.close()


if __name__ == "__main__":
    main()
