ScottYates/VoiceLabels/labelbox/render.py

"""Draw the label as an image. The same image is shown on screen and printed,
so the preview is exactly what comes out of the printer."""

from __future__ import annotations

from dataclasses import dataclass
from functools import lru_cache

from PIL import Image, ImageDraw, ImageFont

import config


@dataclass
class LabelSpec:
    text: str = ""
    show_date: bool = False
    date_text: str = ""
    show_qr: bool = False
    qr_data: str = ""          # blank = use the label text
    orientation: str = config.ORIENTATION
    align: str = config.TEXT_ALIGN   # "left", "center" or "right"
    icon: str = ""                   # Iconify id like "mdi:coffee"; blank = none
    icon_pos: str = config.ICON_POSITION   # "left", "right", "top", "bottom"
    icon_size: str = config.ICON_SIZE      # "small", "medium", "large"


def canvas_size(orientation: str) -> tuple[int, int]:
    a = round(config.LABEL_WIDTH_IN * config.DPI)
    b = round(config.LABEL_LENGTH_IN * config.DPI)
    short, long = min(a, b), max(a, b)                     # 406, 609 for 2 x 3"
    return (long, short) if orientation == "landscape" else (short, long)


@lru_cache(maxsize=64)
def _font(path: str, size: int) -> ImageFont.FreeTypeFont:
    return ImageFont.truetype(path, size)


# --- text fitting ---------------------------------------------------------

def _wrap(draw: ImageDraw.ImageDraw, text: str, font, max_w: int) -> list[str] | None:
    """Word-wrap text to max_w. Returns None if a single word is too wide."""
    lines: list[str] = []
    for para in text.split("\n"):
        words = para.split()
        if not words:
            lines.append("")
            continue
        line = words[0]
        if draw.textlength(line, font=font) > max_w:
            return None
        for w in words[1:]:
            trial = f"{line} {w}"
            if draw.textlength(trial, font=font) <= max_w:
                line = trial
            else:
                if draw.textlength(w, font=font) > max_w:
                    return None
                lines.append(line)
                line = w
        lines.append(line)
    return lines


def _fit_text(draw, text: str, box_w: int, box_h: int):
    """Find the largest font size where the wrapped text fits the box."""
    lo, hi = config.TEXT_MIN_PX, config.TEXT_MAX_PX
    best = None
    while lo <= hi:
        size = (lo + hi) // 2
        font = _font(config.FONT_BOLD, size)
        lines = _wrap(draw, text, font, box_w)
        line_h = round(size * 1.15)
        if lines is not None and line_h * len(lines) <= box_h:
            best = (font, lines, line_h)
            lo = size + 1
        else:
            hi = size - 1
    if best:
        return best
    # Too much text even at the minimum size: wrap by character and cut off.
    font = _font(config.FONT_BOLD, config.TEXT_MIN_PX)
    line_h = round(config.TEXT_MIN_PX * 1.15)
    lines, cur = [], ""
    for ch in text.replace("\n", " "):
        if draw.textlength(cur + ch, font=font) > box_w:
            lines.append(cur)
            cur = ch.lstrip()
        else:
            cur += ch
    lines.append(cur)
    max_lines = max(1, box_h // line_h)
    if len(lines) > max_lines:
        lines = lines[:max_lines]
        lines[-1] = lines[-1][:-1] + "…"
    return font, lines, line_h


def _x_for(align: str, x0: int, x1: int, w: float) -> float:
    if align == "center":
        return x0 + (x1 - x0 - w) / 2
    if align == "right":
        return x1 - w
    return x0


def _draw_text_block(draw, text: str, box: tuple[int, int, int, int], align: str):
    x0, y0, x1, y1 = box
    if not text.strip() or x1 - x0 < 20 or y1 - y0 < 10:
        return
    font, lines, line_h = _fit_text(draw, text.strip(), x1 - x0, y1 - y0)
    total_h = line_h * len(lines)
    y = y0 + (y1 - y0 - total_h) // 2
    for line in lines:
        w = draw.textlength(line, font=font)
        x = _x_for(align, x0, x1, w)
        draw.text((x, y), line, font=font, fill=0)
        y += line_h


# --- QR -------------------------------------------------------------------

def make_qr(data: str, size: int) -> Image.Image:
    """QR code scaled by a whole number of dots per module, so it stays sharp."""
    import qrcode

    qr = qrcode.QRCode(error_correction=qrcode.constants.ERROR_CORRECT_M, border=0, box_size=1)
    qr.add_data(data)
    qr.make(fit=True)
    img = qr.make_image(fill_color="black", back_color="white").get_image().convert("L")
    scale = max(1, size // img.width)
    return img.resize((img.width * scale, img.height * scale), Image.NEAREST)


# --- icon -----------------------------------------------------------------

ICON_SIZES = {"small": 0.5, "medium": 0.75, "large": 1.0}


def icon_box(spec: LabelSpec, box, align: str, gap: int):
    """Where the icon goes inside `box`, and what's left for the text.
    Returns ((x, y, size), text_box_or_None)."""
    x0, y0, x1, y1 = box
    bw, bh = x1 - x0, y1 - y0
    f = ICON_SIZES.get(spec.icon_size, 0.75)
    if not spec.text.strip():                      # icon only: centre it
        s = round(min(bw, bh) * (0.6 + 0.4 * f))
        return (x0 + (bw - s) // 2, y0 + (bh - s) // 2, s), None
    pos = spec.icon_pos if spec.icon_pos in ("left", "right", "top", "bottom") else "left"
    if pos in ("left", "right"):
        s = round(min(bh, bw * 0.6) * f)
        y = y0 + (bh - s) // 2
        if pos == "left":
            return (x0, y, s), [x0 + s + gap, y0, x1, y1]
        return (x1 - s, y, s), [x0, y0, x1 - s - gap, y1]
    s = round(min(bw, bh * 0.6) * f)
    x = round(_x_for(align, x0, x1, s))
    if pos == "top":
        return (x, y0, s), [x0, y0 + s + gap, x1, y1]
    return (x, y1 - s, s), [x0, y0, x1, y1 - s - gap]


def _place_icon(img, spec, box, align, gap):
    (x, y, s), text_box = icon_box(spec, box, align, gap)
    if s < 8:
        return box
    import iconlib                        # here so render works without the icon code

    pic = iconlib.raster(spec.icon, s)
    if pic is None:
        return box
    # Paste only the dark parts so the icon never blanks out anything under it.
    mask = pic.point(lambda p: 255 if p < 128 else 0)
    img.paste(0, (x, y), mask)
    return text_box


# --- main entry -----------------------------------------------------------

def render(spec: LabelSpec) -> Image.Image:
    """Return the label as a 1-bit image, in reading orientation."""
    w, h = canvas_size(spec.orientation)
    m = config.MARGIN_DOTS
    img = Image.new("L", (w, h), 255)
    draw = ImageDraw.Draw(img)

    text_box = [m, m, w - m, h - m]
    qr_data = (spec.qr_data or spec.text).strip()
    show_qr = spec.show_qr and bool(qr_data)
    date_font = _font(config.FONT_REGULAR, config.DATE_PX)
    date_h = round(config.DATE_PX * 1.25)
    gap = 12
    align = spec.align if spec.align in ("left", "center", "right") else "left"

    if spec.orientation == "landscape":
        # [ text ............ ][ QR ]
        # [ date              ]
        if show_qr:
            qr = make_qr(qr_data, round(min(w, h) * config.QR_SIZE_FRACTION))
            qx = w - m - qr.width
            img.paste(qr, (qx, (h - qr.height) // 2))
            text_box[2] = qx - gap
        if spec.show_date and spec.date_text:
            dw = draw.textlength(spec.date_text, font=date_font)
            dx = _x_for(align, text_box[0], text_box[2], dw)
            draw.text((dx, h - m - date_h), spec.date_text, font=date_font, fill=0)
            text_box[3] = h - m - date_h - gap
    else:
        # [ date ]
        # [ text ]
        # [  QR  ]
        if spec.show_date and spec.date_text:
            dw = draw.textlength(spec.date_text, font=date_font)
            draw.text((_x_for(align, m, w - m, dw), m), spec.date_text, font=date_font, fill=0)
            text_box[1] = m + date_h + gap
        if show_qr:
            qr = make_qr(qr_data, round(min(w, h) * config.QR_SIZE_FRACTION))
            qy = h - m - qr.height
            img.paste(qr, ((w - qr.width) // 2, qy))
            text_box[3] = qy - gap
    if spec.icon:
        text_box = _place_icon(img, spec, text_box, align, gap)
    if text_box:
        _draw_text_block(draw, spec.text, tuple(text_box), align)

    # Hard black/white threshold (no dithering) keeps text edges clean.
    return img.point(lambda p: 255 if p >= 128 else 0).convert("1", dither=Image.Dither.NONE)


def for_printer(img: Image.Image, orientation: str) -> Image.Image:
    """Turn the label so its width matches the labels' width across the print head."""
    across = round(config.LABEL_WIDTH_IN * config.DPI)
    if img.width == across or config.LABEL_WIDTH_IN == config.LABEL_LENGTH_IN:
        return img
    return img.rotate(config.LANDSCAPE_ROTATE_DEG, expand=True)
