ScottYates/VoiceLabels/(commit log)

2026-10-18 Voice-to-label printer: Raspberry Pi app and 3D-printed case
    The labelbox app records speech with Moonshine on the Pi, shows an editable
    text box beside a live preview of the 2x3" label (with optional date and QR
    code), and prints it as ZPL to a Zebra thermal printer. It has a Setup
    screen for copies, brightness and the PRINT hold time. The screen blanks
    after 5 minutes. The app supports physical TALK and PRINT buttons, and finds
    the USB mic on any port.
    The case folder holds a parametric manifold3d model with print-ready STLs:
    a reclined screen housing, a button deck, a side mic socket and snap-out
    cable tabs. Every part fits a 270 mm bed and prints without supports.
    [1_housing.stl, 2_back_plate.stl, 3_clamp_x4.stl, 4_base.stl, 5_deck.stl]
2026-10-18 Replace the case images with proper renders; add the Setup screen
    Swap the rough matplotlib previews for three.js renders of the assembled
    case (front and back). Show the main and Setup screens side by side in the
    README. The main-screen shot now shows a real label instead of an error.
    Add a LABELBOX_TEXT environment variable that pre-fills the label text,
    for taking screenshots.
    [app.py]
2026-10-18 Kiosk mode, clearer main screen, and the mic opening at the Pi's USB port
    Kiosk: the Pi boots straight into the app with no desktop. The app runs as
    a labwc session under a systemd service. session.sh restarts the app if it
    crashes, and systemd restarts the window manager. Setup has an "Exit to
    desktop" button (tap twice) that starts lightdm. The service conflicts with
    lightdm, so the kiosk stops, and a desktop icon goes back. A polkit rule
    lets the user switch without a password. install.sh now sets this up, and
    kiosk/uninstall-kiosk.sh reverts it.
    Main screen: "LABEL PREVIEW" and "TEXT" captions. The preview is drawn as a
    label on its backing paper, and the text box is now a dark input wi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
    [1_housing.stl]
2026-10-18 Taskbar, menu and desktop buttons to reopen the app after exiting to the desktop
2026-10-18 Green PRINT button in the case renders; main-screen image with the label upright
2026-10-19 Power-off protection: read-only root with settings kept on the boot partition
2026-10-19 Print the deck face up so the engraved labels form in the top layers
    [5_deck.stl]
2026-10-19 Power pod: switched, fused mains socket and the USB power brick in a closed box behind the base
    [2_back_plate.stl, 4_base.stl, 6_power_pod.stl, 7_pod_lid.stl]
2026-10-19 Power panel on the Setup screen: Restart, Shut down and Desktop tiles
2026-10-19 Icons on all the buttons, drawn by a small icon module; updated screenshots
2026-10-19 README: Rotate button name
2026-10-20 allow-power.sh: let the app restart and shut down the Pi without a password
2026-10-22 Add label icons, a main-screen Align button and the button wiring diagram
    Icon search uses the free Iconify API (by voice or typing), shows results
    in pages, and keeps used icons in a local library that works offline.
    The placement screen moves the icon to any side of the label in three
    sizes, and the text shrinks to make room. SVG icons are drawn by a small
    built-in renderer, so no extra graphics library is needed. With
    power-off protection on, saved icons are kept on the boot partition.
2026-10-22 Icon search: computer and 3D-printing parts
    Search more single-colour icon sets (Phosphor, IconOven, IconPark, Bootstrap,
    Lucide and others), match common words to what the sets call things
    (RAM, video card, network card, PSU, NVMe, filament, ...), and leave out
    thin, two-tone and crossed-out variants. The SVG renderer now handles
    masks, which IconPark's solid icons use.
2026-10-23 Icon screen: larger thumbnails, shorter saved-icons hint
    [app.py]
2026-10-23 Deck PRINT button acts as Done / OK on the Setup, icon and placement screens
2026-10-23 Case: dovetail joints for the housing and power pod, 1.5 inch cable hole
    The screen housing now slides down its seat on two dovetail rails into
    slots in solid ribs in the base, and the deck's new back-edge lip locks
    it in. The power pod drops onto two vertical dovetail rails on the back
    of the base and is held down by the housing's lean (two bumps on the
    pod take up the gap). This replaces the four long screws up through the
    base and the four screws through the floor tongue.
    Adds a 1.5 inch hole on the right side through the pod's front wall and
    the base's back wall, level with the pod floor. The case is 3 mm taller
    so the hole stays a closed circle. All parts still print without
    supports.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
    [1_housing.stl, 4_base.stl, 5_deck.stl, 6_power_pod.stl]
2026-10-23 Case: push-in lock pins for the dovetails, smaller cable hole
    Four printed lock pins hold the housing and the power pod on their
    dovetails. Each passes through an outside wall and across a groove in
    the rail, so the part can't slide; pulling the pins lets the parts come
    apart. They replace the bumps on the pod's sloped front.
    The cable hole is now 30 mm so its top stays below where the pod's front
    starts to slope, leaving no gap.
    [1_housing.stl, 4_base.stl, 6_power_pod.stl, 8_lock_pin_x4.stl]
2026-10-23 Case: hold the screen with push-in pins instead of screwed clamps
    Four pins go in through the housing's side walls, through posts beside
    the screen board, and reach 3.5 mm over the back of the board's edge,
    at the spots the clamps used. They replace the four clamps and their
    M3 screws; pulling the pins frees the screen.
    [1_housing.stl, 3_clamp_x4.stl, 3_screen_pin_x4.stl]
2026-10-23 Case: quarter-turn lock for all the pins
    Each pin now has a lug on its shaft and a wing head. The lug passes a
    slot in the wall with the head upright; a quarter turn either way puts
    it behind the wall, where it rides up a small ramp that pulls the head
    tight and clicks into a notch, with a stop just past it. The pins can't
    pull out while locked or turn back on their own. Same lock for the
    four lock pins and the four screen pins.
    [1_housing.stl, 3_screen_pin_x4.stl, 4_base.stl, 6_power_pod.stl, 8_lock_pin_x4.stl]
2026-10-23 Add the interactive 3D case viewer
    case/viewer/index.html is a single self-contained page (the model data is
    built in) with the assembled case, see-through and spread-apart views,
    and an animated close-up of the quarter-turn pin lock. The case README
    shows animated previews and how to open it.
2026-10-23 Network screen: automatic (DHCP) or a fixed IP address
    Setup has a new Network button. The screen shows the connection in use,
    switches between Automatic and Fixed address, and has fields for the IP
    address, router and DNS with an on-screen number pad. Save checks the
    numbers and that the address is free, applies them through
    NetworkManager and waits for the router; if it can't be reached the old
    settings are restored. The choice is kept with the app's settings and
    re-applied at start, so it holds with power-off protection on.
    allow-power.sh now also grants the NetworkManager permission.
    [app.py, icons.py, network.py]
2026-10-23 Remember the Date and QR switches and the QR text across restarts
2026-10-23 Keep the app window exactly full-screen
    At start the window manager sometimes gave the window a title bar or an
    offset, cutting off the bottom row of buttons. The check now looks at the
    window's position as well as its size, runs often just after start and
    every few seconds after that, and puts it back to fullscreen at 0,0.
2026-10-23 Case: no screws at all - the back plate, pod lid and deck slide in
    Each panel's long edges are bevelled at 45 degrees and slide under lips
    along the top of the side walls they sit on, like a pencil-box lid; a
    stop ends the travel and a small bump clicks into a dimple under the
    panel. The back plate slides down from the top of the housing, the pod
    lid in from the back, and the deck in from the front. The housing's
    corner ribs, the pod's lid bosses and the deck's screw holes are gone.
    The 3D viewer shows the panels sliding.
    [1_housing.stl, 2_back_plate.stl, 4_base.stl, 5_deck.stl, 6_power_pod.stl, 7_pod_lid.stl]
2026-10-23 Turn Wi-Fi power saving off, watch the router and reconnect on drops, log them
2026-10-23 Voice commands (space, start over, upper/lower/title case) and a Help screen; spelled letters join into a word (Trae); guard against the bottom row being cut off
2026-10-23 Help replaces Clear on the main screen; double-tap the text or preview clears text and icon; redraw the window after fixing fullscreen
    [app.py]
2026-10-23 Voice command "change X to Y": replace punctuation, spaces or words throughout the text
    [app.py, config.py, voicecmd.py]
2026-10-23 Screen pins: cam ends clamp the board against the bezel when locked
    [1_housing.stl, 3_screen_pin_x4.stl]
2026-10-23 Viewer: show the screen board, so the screen pins are seen resting on it
2026-10-23 Viewer: click parts to take the case apart; fix housing slide path and screen entry path
    - Base: trim the side-wall tops in front of the housing, which stood 1 mm into
    the housing's slide path
    - Housing: move the back plate's click pad beside the screen board, out of the
    board's way through the back opening
    - README: take-apart order (the housing has to come off before the pod)
    [1_housing.stl, 2_back_plate.stl, 4_base.stl]
2026-10-23 Power socket without screws: printed keeper frame held by two quarter-turn pins
    - New parts: 9_socket_keeper (pocket fits the socket's front plate, window for
    the plug, switch and fuse drawer) and 10_socket_pin_x2
    - Pod: screw holes and thinned wall removed; two pin bores beside the socket
    - Socket plate size is an estimate (INLET_PLATE); only the keeper depends on it
    - Viewer: keeper, its pins and the socket come off by clicking
    [10_socket_pin_x2.stl, 6_power_pod.stl, 9_socket_keeper.stl]
2026-10-23 Label sizes (3x2, 3x1, 2x1) with a Labels screen: measure, calibration print and per-size position offsets
2026-10-23 Base front wall becomes a panel that slides up from underneath, so the deck can slide in with the buttons hanging below it
    - Rebated panel edges run in slotted corner posts; a lip keeps the front flush
    - Click bump holds the panel up; its top follows the deck's slope
    - Deck front face trimmed vertical, flush with the panel
    - Viewer: front panel clickable; the deck needs it lowered
    [11_front_panel.stl, 4_base.stl, 5_deck.stl]
2026-10-23 Square bottom corners on the screen housing; close visible seams
    - Pod's sloped front thickened between the back plate's rails: 2.3 mm slot down to 0.4 mm
    - Deck lip reaches to 0.4 mm of the bezel (was 0.8 mm)
    - Pod to base seam 0.2 mm (was 0.5 mm)
    [1_housing.stl, 4_base.stl, 5_deck.stl, 6_power_pod.stl]
2026-10-23 Pod lid runs up to the back of the screen housing (front edge cut at 20 degrees, 0.4 mm gap); no corner stop blocks or USB-C notch; pod face 0.4 mm from the housing across the full width
    [6_power_pod.stl, 7_pod_lid.stl]
2026-10-23 Back plate: fill in the old USB-C cable notch
    [2_back_plate.stl]
2026-10-23 Pod front follows the housing 0.4 mm away with no wedge gaps; pod lid to 0.15 mm; printer status check and log
    - Pod: fill in front of the sloped face, minus the housing swept through the gap
    and along its way off; straight against the base below the housing
    - Pod: locator rib and zip-tie anchors joined to the floor
    - Printer: ask the printer for its status (~HS) before printing; resume it if
    paused, say so if it's out of labels or open, warn if a label sits unprinted;
    log status changes to printer.log
    [6_power_pod.stl, 7_pod_lid.stl]
2026-10-24 Pod: lid rails run forward to the housing, trimmed to the same 0.4 mm gap, closing the notch at the top front corners
    [6_power_pod.stl]
2026-10-24 Pod lid touches the back of the screen housing and sits flush with the back of the pod
    [6_power_pod.stl, 7_pod_lid.stl]
2026-10-24 Pod front touches the back of the screen housing along its full width and both sides
    [6_power_pod.stl]
2026-10-24 Viewer: show the current pod lid (it was still showing the old, shorter one)
2026-10-24 Pod's vertical front touches the back of the base (no seam)
    [4_base.stl, 6_power_pod.stl]
2026-10-25 Logo plaque: 3D-printable Voice Labels logo with text, one piece or split by colour
    [logo_1_base_dark.stl, logo_2_yellow.stl, logo_3_white.stl, logo_4_gray.stl, logo_plaque.stl]
2026-10-25 Socket keeper sized for the real socket: wider window for its raised face, larger pocket for its plate; same thickness and pin holes
    [9_socket_keeper.stl]
2026-10-25 Socket keeper 1/16" wider (window and pocket), after a test fit
    [9_socket_keeper.stl]
2026-10-29 Front panel: Voice Labels logo inlaid flush in its face, with the panel split by colour (11a-11d); viewer shows the logo
    [11a_front_panel_dark.stl, 11b_front_logo_yellow.stl, 11c_front_logo_white.stl, 11d_front_logo_gray.stl]
2026-10-29 Viewer: every printed part the case colour (pins still stand out), logo and TALK/PRINT lettering in colour; front panel files renamed for a light panel
    [11a_front_panel_main.stl, 11c_front_logo_voice.stl, 11d_front_logo_tagline.stl]
2026-11-02 Printer: wait for the last chunk to go out before closing the device, so big labels aren't cut off; report a half-received label
2026-11-02 Lock pins for the pod lid and the deck: one quarter-turn pin each, straight down into a block on the pod's back wall and a post in the base, so neither can slide out; viewer updated
    [12_panel_pin_x2.stl, 4_base.stl, 5_deck.stl, 6_power_pod.stl, 7_pod_lid.stl]
2026-11-02 Socket keeper: 1 mm room all round the socket's raised face in its window
    [9_socket_keeper.stl]
2026-11-02 Front panel pin; braced posts under the deck and in the housing; socket keeper pins moved out to 35 mm (closed holes), socket 4 mm inwards
    [11_front_panel.stl, 11a_front_panel_main.stl, 12_panel_pin_x2.stl, 12_panel_pin_x3.stl, 1_housing.stl, 4_base.stl, 6_power_pod.stl, 9_socket_keeper.stl]
2026-11-02 Viewer: only the button tops press down
2026-11-02 Viewer: detailed Pi 5, screen, power brick, cord socket, power socket, wiring and arcade buttons
2026-11-02 Viewer: arcade buttons have one block with four terminals in a 2x2 grid
2026-11-02 Viewer: 2-prong cord socket wired straight to the power socket's terminals, low domed buttons; README wiring to match
2026-11-02 Case pictures redone from the current 3D model
2026-11-02 Spinning case animation from the current 3D model
2026-11-02 Sliding panels animation from the current 3D model, with the front panel
2026-11-02 "Hold to listen" on the talk button; new screenshots of every screen (main, setup, labels, power, network, help, icon search and placement)
2026-11-02 "Hold and speak" on the talk button and in the empty text box; main screen screenshot updated
